kemallaydn/FAC-IO-HARDWARE/manufacturing/DRAFT-2026-11-08/drill-report.txt

Drill report for FAC-IO-Mini-V1.kicad_pcb
Created on 2026-11-08T16:09:45

Copper Layer Stackup:
    =============================================================
    L1 :  F.Cu                      front
    L2 :  In1.Cu                    in1
    L3 :  In2.Cu                    in2
    L4 :  B.Cu                      back

Drill file 'FAC-IO-Mini-V1-PTH.drl' contains
    plated through holes:
    =============================================================
    T1  0.300mm  0.0118"  (154 holes))
    T2  0.300mm  0.0118"  (12 holes))
    T3  0.600mm  0.0236"  (4 holes)  (with 4 slots)
    T4  0.850mm  0.0335"  (16 holes))
    T5  0.900mm  0.0354"  (8 holes))
    T6  1.020mm  0.0402"  (4 holes))
    T7  1.100mm  0.0433"  (4 holes))
    T8  1.600mm  0.0630"  (10 holes))

    Total plated holes count 212

Drill file 'FAC-IO-Mini-V1-NPTH.drl' contains
    unplated through holes:
    =============================================================
    T1  0.650mm  0.0256"  (2 holes))
    T2  3.200mm  0.1260"  (4 holes))
    T3  3.250mm  0.1280"  (2 holes))

    Total unplated holes count 8
