kemallaydn/FAC-IO-HARDWARE/manufacturing/REVIEW-2026-11-10-PCBA-DRAFT/release/drc-report.txt

** Drc report for FAC-IO-Mini-V1.kicad_pcb **
** Created on 2026-11-10T16:45:32 **
** Report includes: Errors, Warnings, Exclusions **

** Found 0 DRC violations **

** Found 0 unconnected pads **

** Found 0 Footprint errors **

** Ignored checks **
    - Hiçbiri

** End of Report **
