kemallaydn/FAC-IO-HARDWARE/manufacturing/DRAFT-2026-11-09-DRAFT-1.2/reports/revision-notes.txt

DRAFT-1.2 revision notes

- Enabled footprint-placement enforcement for the existing ESP32 antenna keepout in both the PCB footprint instance and project footprint library. No manufacturing geometry, nets, outline, Gerbers or drills changed. Refreshed ERC, DRC and machine-readable parity reports; ERC and DRC/parity pass with zero violations. A follow-up coordinate audit confirmed the 30×14 mm Edge.Cuts cutout places the 28×11 mm antenna keepout fully outside the base-board outline; the earlier rectangular-bounding-box interpretation was incorrect. Confirm enclosure clearance and perform RF range/throughput tests if Wi-Fi/BLE is enabled.

- Source revision: DRAFT-1.2.
- Changed only F1's manufacturer selection from Littelfuse 1812L050/30PR to 1812L075/33DR. The MPN is synchronized in schematic, PCB, source BOM, Robotistan draft BOM, schematic BOM and exported position Value fields. The 1812 footprint, PCB geometry, nets and component placement are unchanged.
- Littelfuse's 1812L datasheet lists the new part at 0.75 A hold, 1.5 A trip, 33 V maximum, and 0.36 A in its 85 C temperature table. Littelfuse explicitly says temperature rerating is reference-only. This improves the preliminary hot-current estimate but does not close the PTC selection; source/load/ambient, local heating, fault coordination and first-article tests remain open.
- Regenerated current-source KiCad 10.0.8 Gerber, Excellon, schematic PDF, schematic BOM, ERC, DRC and machine-readable parity report. All normalized Gerber and drill payloads match DRAFT-1.1 after revision/date metadata is removed; this confirms no manufacturing geometry changed.
- Gerber/Excellon CRC ZIP contains 11 Gerber layers, one Gerber job file, and separate PTH/NPTH drill files. ZIP integrity passes. Gerbonara 1.6.3 independently parses the DRAFT-1.2 Gerbers and drills; see `reports/gerber-parse.txt`. Its `G90`-after-header warning is a parser classification warning: Excellon defines G90 as absolute mode and permits it as a standalone program command, and JLCPCB's published example also places it after `%`. The KiCad exports remain unchanged. Fabricator CAM acceptance remains open.
- Corrected 51 stale `Status` notes in `bom/robotistan-bom-draft.csv` by syncing from `hardware/bom-draft.csv`. Exact supplier-code mappings now cover 45 of 56 placements across 26 MPNs (resistors, capacitors, semiconductors, PTC fuse, TVS, relays, ESP32 module, USB-C connector and Samtec sockets); 11 BOM rows remain without confirmed codes. The values are catalog identifiers, not confirmed Robotistan procurement/assembly acceptance or current stock. Current stock and assembly acceptance are unverified.
- KiCad 10.0.8 ERC and DRC/parity both pass on current source CAD. This remains an engineering DRAFT, not a production release.

- 2026-11-09 follow-up: fresh KiCad 10.0.8 ERC/DRC/parity and netlist checks pass (0 ERC issues; 0 DRC/parity issues/unconnected pads/ignored checks). A stale 10-row schematic BOM was replaced by the current 56-reference KiCad export. Source, Robotistan and assembly BOMs match 56 refs × 7 fields; schematic BOM matches value/footprint/MPN 56/56; positions match 56/56. Exact catalog codes cover 45/56 placements (11 blank).
- Refilled-zone Gerber/drill exports, schematic PDF, assembly PDF, board render and flat 14-file ZIP were regenerated from current CAD. Gerbonara parses 11 Gerbers and both drill files; Excellon `G90` warnings remain for supplier CAM confirmation. ZIP integrity and `git diff --check` pass. PlatformIO target build was attempted and stopped during RISC-V toolchain extraction with `No space left on device`; no target binary is verified.

- Follow-up sourcing update: matched CUI TB007-508-02BE (J1) to LCSC C3816270 and TB007-508-03BE (J4/J5) to C3820511; synchronized source, Robotistan and assembly BOMs. Exact catalog-code coverage is now 48/56 across 28 MPNs (8 rows blank). These IDs do not confirm Robotistan import, current stock or assembly acceptance.

- Follow-up component lifecycle update: changed C3/C8/C30 from TDK C1608X7R1E104K080AA (manufacturer NRND) to C1608X7R1H104K080AA (active production, 100 nF/50 V X7R 0603, LCSC C72453). Corrected C3 BOM/value export to 100nF/50V; updated schematic, PCB, source/assembly/Robotistan/schematic BOM and placement CSVs. Nets, land patterns, copper and drill geometry are unchanged. KiCad 10.0.8 netlist/ERC/DRC/parity pass. Manufacturer states alternate interchangeability is not guaranteed; independent design review remains open. Supplier-code coverage is 51/56 placements across 29 MPNs; five placements remain uncoded.
