kemallaydn/FAC-IO-HARDWARE/PROJECT_STATUS.md

# 2026-11-12 — Basit üretim yolu seçimi ve güncel KiCad kontrolü
- Aynı checkout’taki ana tasarımlar KiCad 10.0.8 ile tekrar kontrol edildi. **Mini V1 (ESP32-C3 + hazır WIZ850io modülü + iki kuru kontak röle):** ERC 0 hata, 2 uyarı (J6/J7 özel sembol kopyaları kütüphaneyle eşleşmiyor); tam DRC 0 ihlal, 0 açık bağlantı, 0 şematik eşlik sorunu. Üretim paketi mevcut: `manufacturing/REVIEW-2026-11-10-PCBA-DRAFT/`.
- **Lite V3 (çıplak W5500 + magjack):** ERC 0/0; error-level DRC/parity 0 hata/açık; tam DRC 389 uyarı. Esas engel MDI: RX toplam uzunlukları 81.81/77.20 mm ve hatlarda via var; WIZnet’in 75 mm sınırı/via kılavuzunu karşılamıyor. V3’ten yeni Gerber çıkarılmadı.
- Bu kanıta göre yeni MDI yerleşimini sıfırdan yönlendirme yolunu durdurup, üretime en yakın sade yol olarak WIZ850io modüllü V1’e dönüyorum. Kart yine **üretime hazır değil**: Robotistan BOM stok/tedarik ve WIZ850io’nun fabrikada takılmasını yazılı kabul etmeli; V1’in iki ERC uyarısı ve elektriksel/ilk ürün doğrulamaları da kapanmalı. DRAFT paketi sipariş onayı değildir.
- Raporlar: `validation-reports/final-check-v1-{erc.txt,drc.json,drc-full.json}` ve `final-check-v3-{erc.txt,drc.json,drc-full.json}`. V3 deney adayları ana CAD’e alınmadı; kullanıcı değişiklikleri korunuyor.

# 2026-11-12 — Lite V3 MDI yerleşim/yönlendirme denemeleri (üretim kapısı açık)
- Kaynak V3 şema/PCB dosyaları bu denemelerde değiştirilmedi. Üretim Gerber/BOM/PnP paketi üretilmedi. Önceki kaynak doğrulaması geçerlidir: KiCad 10.0.8 ERC 0 hata/0 uyarı; kaynak PCB hata-seviyesi DRC + parity 0 hata/0 açık/0 parity, fakat MDI gereksinimleri ve 389 tam-seviye uyarı nedeniyle üretime hazır değil.
- Tam bağlanan geçici `mdialign19` rotası izleri 0.20 mm’ye alınıp W5500 pinindeki iki 0.0023 mm açıklık ihlali kısa, yatay pad kaçışıyla giderildi. Son hata-seviyesi KiCad DRC: **0 ihlal / 0 açık**. Ölçülen MDI: TXP/TXN 30.78/43.88 mm (2/0 via); RX PHY tarafı 40.35/39.77 mm (2/3 via); RX magjack tarafı 37.81/34.14 mm (1/1 via). RX kondansatörleri üzerinden toplam yaklaşık 78.16/73.91 mm: RXP, WIZnet 75 mm mutlak sınırını aşıyor. Her çiftte yasaklanan via/katman geçişleri de var. Aday üretim için reddedildi.
- Kondansatörleri U6–J7 arasına alan `mdialign23` yerleşimi fiziksel yerleşim DRC’sinde temizdi, fakat 200 geçişe kadar autoroute 26 bağlantı açık bıraktı; genişletilmiş 0.20 mm izlerle hata DRC’sinde 2 clearance hatası kaldı. MDI ölçümleri: RX toplam yaklaşık 44.40/44.90 mm, fakat via’lar 2–3/adet; TX 35.50/31.79 mm ve TXP/TXN’de 1/0 via. Elektriksel bağlantı tam değil, aday reddedildi.
- Kondansatörleri kart altındaki boşluğa alan `mdialign26` da fiziksel yerleşim DRC’sini geçti; 200 geçişte 26 açık bağlantı, 2 clearance hatası ve MDI’de 1–3 via/net verdi. RX toplamı yaklaşık 59.91/63.86 mm, TX 42.05/33.25 mm. Aday reddedildi.
- Tam bağlı `mdialign19` güç izlerini yeni MDI rotalarıyla birleştirme denemesi `mdialign27` de KiCad hata-seviyesi DRC’de 56 ihlal ve 11 açık verdi; iz uçları ve ağlar çakıştığından reddedildi. Otomatik rota parçalarını farklı yerleşimlerden birleştirmek güvenilir değil.
- Ayrıntılı deneme kanıtı geçici çalışma alanında `/tmp/facio-v3-finalize/mdialign19*`, `mdialign23*`, `mdialign26*` altındadır; bu adayların hiçbiri kaynak tasarıma alınmadı ve eşlenik şematik parity/CAM testi geçmedi. Üretim kapısı halen kapalıdır. Sonraki gerekli iş: magjack, RX kuplaj kondansatörleri, güç dağıtımı ve W5500’ü birlikte yeniden yerleştirip tüm kartı elle/kurallı yönlendirmek; sonra MDI via’sız ve ≤75 mm (tercihen <25 mm) doğrulaması, tam ERC/DRC/parity ve bağımsız CAM/ilk ürün incelemesi.

# 2026-11-12 — V3 magjack yerleşim adayı yeniden değerlendirildi
- Taze KiCad 10.0.8 kontrolü kaynak V3 için ERC **0 hata/0 uyarı**, hata-seviyesi DRC + şematik eşliği **0 hata/0 açık/0 parity** verdi. Tüm-seviye DRC **389 uyarı** verdi (193 silk çakışması, 190 silk-bakır, 6 silk-kenar); bu uyarılar üretim onayı değil. Raporlar: `validation-reports/lite-v3-2026-11-12-audit-{erc.txt,drc.json,netlist.xml,mdi.txt}`.
- Kaynak PCB izleri KiCad’in pcbnew API’siyle ölçüldü: TXP/TXN **59.19/49.11 mm, 3/3 via**; RX PHY P/N **39.48/40.41 mm, 4/4 via**; RX kablo P/N **42.33/36.79 mm, 1/1 via**. RX seri kuplaj kondansatörlerinin iki yanındaki net parçaları toplandığında toplam RXP/RXN **81.81/77.20 mm**; WIZnet’in 75 mm mutlak uzunluk sınırını da aşıyor. Tüm MDI çiftlerinde via var; kılavuz via/katman değişimini yasaklıyor. DRC temizliği bu üretici koşullarını karşılamıyor; kaynak PCB üretime hazır değil.
- WIZnet’in W5500 + J1B1211CCD referans şeması büyütülerek kontrol edildi ve KiCad netlist’iyle eşlendi: 6.8 nF RX seri kuplajı, RX 49.9 Ω eşleme ve 10 nF merkezden GND’ye, TX 49.9 Ω bias ve TCT 10 Ω/22 nF ağı V3 ile uyumlu. Referanstaki R21–R24 seri damping konumları opsiyonel; şemadaki temel değeri 0 Ω, açıklama ise kendi testlerinde 33 Ω’nun EMI’ye iyi geldiğini söylüyor. 33 Ω zorunlu değildir ve mevcut V3’e körlemesine eklenmeyecek.
- `/tmp/facio-v3-finalize/mdialign11-trackless.kicad_pcb` deneme yerleşimi 37 fiziksel DRC hatası verdi; reddedildi. Deneme ana V3’e aktarılmadı. Kaynak şema/PCB değişmedi; Gerber/BOM/PnP üretilmedi.
- `/tmp/facio-v3-mdi90/` içindeki 90° magjack denemesini KiCad 10.0.8 3D görünümünde kontrol ettim. Adayda J7 kart kenarında değil, kartın ortasında kalıyor; routing/DRC sayısal olarak 0 açık/parity gösterse de mekanik kullanıma uygun değil. Bu aday reddedildi ve ana V3 şema/PCB’ye kopyalanmadı.
- Kaynak PCB’nin kendi J7’si üst kenarda (194,109,0°). Sağ kenar alternatifi için yalnızca geçici yerleşim denemesi yaptım: U6 (185,136,180°), J7 (205,136,90°). MDI pad merkezleri yaklaşık 18–21 mm aralığında; doğrudan düz fanout hesabında TX ve RX çiftlerinin her birinde birer sıralama kesişmesi var. Son yerleşim taslağında U6/R38 ve C104/R38 courtyard çakışmaları da sürüyor. Bu, yönlendirilmiş PCB veya üretim adayı değildir; mevcut routing bu taşımada artık geçersizdir.
- **MDI damping kararı:** J1B1211CCD referansındaki R21–R24 opsiyonel seri damping yerleşimleridir; şemada 0 Ω gösterilmiş, notta WIZnet’in kendi denemesinde 33 Ω’nun EMI için iyi sonuç verdiği yazılmıştır. V3 bunları eklemez; EMI test sonucu olmadan 33 Ω’ya çevrilmeyecek.
- Üretici kılavuzu MDI için 100 Ω diferansiyel empedans, 6–12 mil iz, olabildiğince eş uzunluk, <25 mm öneri / 75 mm en kötü durum ve via/katman değişikliği olmamasını istiyor; RJ45/manyetik altında güç ve GND düzlemi bırakılmamalı. Kaynaklar: [WIZnet Hardware Design Guide](https://docs.wiznet.io/Design-Guide/hardware_design_guide), [J1B1211CCD referans şeması](https://docs.wiznet.io/assets/files/w5500_sch_v110_use_mag_-dfff8bbb103d13be4f25cd2b2f8b950d.pdf), [Yageo RC0402JR-070RL](https://www.yageogroup.com/component-documentation/download/specsheet/RC0402JR-070RL).
- **Kaynak V3 dosyaları değiştirilmedi.** Bu oturumda `/tmp` yerleşim denemeleri üretim/parity kanıtı oluşturmaz; mevcut kaynak PCB’nin daha önceki DRC raporu da yeni MDI topolojisini doğrulamaz. Gerber/BOM/PnP yayımlanmadı.
- **Sıradaki:** J1B1211CCD’yi gerçek kart kenarında tutarak U6, kristal, RX 6.8 nF ağı ve terminasyonları birlikte yerleştir; MDI’yi mümkün olduğunca kısa, eş uzunlukta ve viasız route et. DRC/parity yanında MDI uzunluk/via, silk, power/return, CAM, BOM ve Robotistan PCBA kabulü geçmeden üretim paketi verme.

# 2026-11-11 — V3 üretici referanslı Ethernet yerleşimi yeniden başlatıldı
- Kaynak `hardware/FAC-IO-Lite-V3.kicad_sch/.kicad_pcb` KiCad 10.0.8 ile yeniden kontrol edildi: ERC **exit 0 / 0 ihlal**; zone refill + schematic parity error-level DRC **exit 0 / 0 hata / 0 açık bağlantı / 0 parity sorunu**. Tam-severity DRC **389 uyarı** veriyor; raporlar `validation-reports/lite-v3-continuation-*` altında. Uyarılar üretime uygunluk kararı değildir.
- WIZnet’in `W5500-EVB-Pico_V100` resmi PCB referansındaki W5500/magjack ve MDI pasif geometrisi ayrı deneme kopyasına taşındı. 0603’ler bu sık yerleşimde açıklık ve courtyard ihlali oluşturdu; uygun KiCad 0402 kütüphane footprint’lerine çevrilip U5 ve kristal çevresi konumu düzeltildi. Trackless placement-only adayda error-level DRC **0 fiziksel kural ihlali** verdi. Aday ve rapor: `validation-reports/lite-v3-wiznet-placement-only-trackless.kicad_pcb`, `lite-v3-wiznet-placement-only-errors.json`.
- Bu adayda yönlendirme ve zonelar bilerek kaldırıldı: **183 bağlantısız öge** var. Şematik/PCB parity, WIZnet MDI performansı veya üretim dosyası kanıtı değildir; ana V3 kaynakları değiştirilmedi. Resmî referanstaki R21–R24 opsiyonel seri damping noktaları V3’te yok; 33 Ω yalnızca WIZnet’in kendi EMI denemesinde işe yarayan opsiyonel değerdir.
- **Üretime hazır değil; Gerber/BOM/PnP yayımlanmadı.** Sonraki: V3 şemasına dört MDI seri direncini ve PHY/kablo net sınırlarını ekle; üretici footprint/MPN’lerini doğrula; Ethernet alanını bu adayda bütün netlerle route et; kaynak PCB’ye almadan tam parity, DRC, MDI uzunluk/via, silk, power/return, CAM ve Robotistan PCBA kabulünü kapat.

# 2026-11-11 — WIZnet yerleşiminde çift GND dolgusu denemesi reddedildi
- Kaynak V3 kartına dokunmadan PnP-referanslı 0402 Ethernet yerleşimine üst katman GND dolgusu eklendi; KiCad 10.0.8 zone-refill + error-level DRC çalıştırıldı. Üst dolgu GND açıklarını 16'dan 5'e düşürdü, fakat 5 bağlantısız zone adacığı kaldı. Pad bağlantısını solid yapmak C31 açık bağlantısını ve iki starved-thermal hatasını kaldırdı; zone adacıklarını kaldırmadı.
- Adayda hâlâ 8 gerçek açıklık ihlali var: U6 çevresinde iki ETH_MOSI/ETH_INT açıklığı 0.1986/0.200 mm; OPEN_COM/OPEN_NC 0.1786/0.200 mm; PULSE2/TRIG2 0.1517/0.200 mm. Ölçümler DRC kuralını karşılamıyor ve gevşetilmedi.
- Kaynak `FAC-IO-Lite-V3` ayrıca KiCad 10.0.8 ile taze kontrol edildi: ERC **0 ihlal** (exit 0); zone-refill + schematic-parity error-level DRC **0 ihlal / 0 açık bağlantı / 0 parity sorunu** (exit 0). Tam severity DRC **389 uyarı** veriyor; bunlar kaynak kartın bilinen silkscreen uyarılarıdır. Raporlar `validation-reports/lite-v3-current-final-*` altında. Bu CAD temel sonucu MDI topolojisinin üretici kılavuzuna uyduğunu veya kartın üretime hazır olduğunu kanıtlamaz.
- Reddedilen aday ve raporlar `validation-reports/lite-v3-wiznet-pnp-dualgnd-trial*` altında saklandı. Ana şema/PCB değişmedi; Gerber, Excellon, üretim BOM veya PnP üretilmedi. Bu aday şema-parity, MDI eş uzunluk/viasız yönlendirme, tam üretici/CAM ve Robotistan incelemesini geçmedi; üretime hazır değil.
- Sıradaki: clearance kurallarını koruyarak MDI, röle/dijital izleri yeniden yerleştirip route et; GND plane island bağlantılarını çöz; tüm-net DRC/parity ve MDI uzunluk/via analizinden sonra güncel BOM/PnP/Robotistan kabulüne geç.

# 2026-11-11 — V3 üretici yerleşim yönündeki yeni routing denemesi
- WIZnet'in resmi tasarım kılavuzu tekrar kontrol edildi: MDI izleri 6–12 mil, 100 Ω diferansiyel, çiftler olabildiğince eş uzunlukta ve viasız olmalı; önerilen uzunluk <25 mm, mutlak üst sınır 75 mm. Referans sayfası J1B1211CCD'yi W5500 ile desteklenen magjack olarak listeliyor. Kaynaklar: [Hardware Design Guide](https://docs.wiznet.io/Design-Guide/hardware_design_guide), [W5500 Reference Schematic](https://docs.wiznet.io/Product/Chip/Ethernet/W5500/ref-schematic).
- Eski kaynak karttan ayrı bir trackless kopyada J7/U6 yönü üretici W5500-EVB-Pico PnP sırasına göre düzeltildi; eski MDI ağı ve ilgili pasiflerin konumu bu yerleşimde korundu. FreeRouting 2.5.0, bu ayrı kopyada **195 bağlantısız netten 0'a** indi ve **0 router ihlali** raporladı.
- FreeRouting'in 0.10–0.15 mm izleri 0.20 mm'ye büyütülüp KiCad 10.0.8 DRC çalıştırıldı: **0 bağlantısız öğe, 13 açıklık ihlali** (exit 5). Tam DRC'de bunlara ek olarak 391 silkscreen uyarısı ve 1 footprint kitaplık uyarısı var. KiCad parity bu geçici farklı adlı adayda çalıştırılamadı. MDI uzunlukları hâlâ yüksek: TXP/TXN **59.93/46.46 mm**, RX_PHY P/N **46.31/50.64 mm**; TXP/TXN/RX_PHY P/N sırasıyla **3/2/3/2 via**. WIZnet'in viasız ve <25 mm hedefini karşılamıyor.
- Aday PCB ve DRC/FreeRouting raporları `validation-reports/lite-v3-ethernet-relayout-trial*` içinde. **Ana V3 PCB/şema değiştirilmedi; üretim Gerber/BOM/PnP üretilmedi ve kart üretime hazır değil.** Sıradaki iş MDI terminasyon/kuplaj elemanlarını ve W5500/RJ45 yerleşimini birlikte yeniden kurup MDI çiftlerini üretici kurallarına yaklaştırmak; ardından temiz tam DRC/parity ve Robotistan CAM/BOM kabulünü doğrulamak.
- Takip denemesi: FreeRouting optimizer MDI uzunluk/via ölçülerini değiştirmedi; yakın pasif yerleşimi denemesinde W5500 pad aralığında kısa-devre ve footprint çakışmaları oluştu, reddedildi. Hiçbiri ana PCB'ye aktarılmadı.

# 2026-11-11 — V3 iki katmanlı yönlendirme adayı: 3V3 dolgusu ölçüldü, serbest bırakılmadı
- Kaynak PCB'ye dokunmadan geçici U6/J7 yerleşimi ve FreeRouting rotasına F.Cu/B.Cu 3V3 dolgusu eklendi; J7/manyetikler altında dolgu için copper-fill keepout kullanıldı. Dolgu, açık bağlantıları 18'den 5'e düşürdü.
- Router'ın 0.15 mm izleri aday kopyada 0.20 mm'ye büyütüldü. KiCad 10.0.8 hata-seviyesi DRC sonucu: **1 starved-thermal hatası, 5 bağlantısız item; exit 5** (`validation-reports/lite-v3-2layer-plane-candidate-errors.*`). İz genişliği/açıklık hatası kalmadı; bu aday için parity testi koşulmadı.
- 3V3 zone bağlantısı doğrudan bakır (full connection) yapılarak starved-thermal hatası kapatıldı. Güncel tam DRC adayı: **0 error-level ihlal, 5 bağlantısız item ve 392 uyarı; exit 5** (`validation-reports/lite-v3-2layer-plane-candidate-connectivity.*`). Açıklar 3 zone adacığı ile J7.12/U6 ve J7.5/C8 arasındaki 3V3 bağlantılarıdır. Kaynak PCB'ye uygulanmadı.
- Kalan açıklar: 3V3 dolgu adacıkları, U6 pin 45 beslemesi ve J7/C8 LED beslemesi. MDI ölçümleri hâlâ uygunsuz: TXP/TXN 43.91/30.97 mm ve 2/1 via; RXP/RXN_PHY 18.80/25.28 mm ve 2/1 via; kablo çifti 24.04/22.00 mm ve 1/1 via. Bu nedenle aday WIZnet yerleşim/yönlendirme koşullarını karşılamıyor.
- **Üretim dosyası oluşturulmadı; V3 üretime hazır değil.** Büyütülmüş ve doldurulmuş kopya `/tmp/v3-place-j-fullpower-routed-3v3planes-020.kicad_pcb` altındadır; kaynak V3 PCB değişmedi. Sonraki CAD işi MDI çiftlerini viasız ve eş uzunlukta yeniden yerleştirmek, kalan 3V3 bağlantılarını kapatmak, ardından tam DRC/parity ve bağımsız CAM kontrolü almaktır.

# 2026-11-11 — Lite V3 kısa MDI yerleşim yönlendirmesi reddedildi
- Trackless U6 `(191,133,270°)` / J7 `(188,108,0°)` yerleşimi, 0402 RX seri kondansatörleri ve taşınmış pasiflerle fiziksel error-level DRC'yi geçiyordu. FreeRouting 2.5.0 bu adayı 30 ve 100 geçişte de **16 unrouted** bağlantıyla bıraktı; devamı 3V3 ağı ve röle GPIO netlerinde kaldı.
- SES geçici kopyaya alındığında KiCad 10.0.8 DRC **34 iz genişliği hatası** ve **22 bağlantısız item** (20 adet 3V3, 1 TRIG1, 1 ACTLED) ve 14 dangling-via uyarısı buldu. Altı MDI iletkeni toplam iz/via sayımı: TXP 34.28 mm/2, TXN 28.28 mm/1, RXP_PHY 13.92 mm/1, RXN_PHY 27.89 mm/0, RXP_CABLE 21.72 mm/1, RXN_CABLE 21.53 mm/1. PHY RX çifti **13.97 mm dengesiz**; aday üretim için reddedildi.
- Kaynak V3 kart değiştirilmedi. Kaynak dosyanın yeni KiCad 10.0.8 kontrolleri: ERC **0 ihlal**; PCB hata-seviyesi DRC **0 ihlal, 0 bağlantısız, 0 parity**; tam DRC **389 silkscreen uyarısı** ile exit 5. Raporlar `validation-reports/lite-v3-final-erc.txt`, `lite-v3-final-drc-errors.json`, `lite-v3-final-drc.json`; reddedilen geçici aday ölçümleri `validation-reports/lite-v3-place-j-0402d-router.txt`.
- **Durum değişmedi: V3 üretime hazır değil; Gerber/Excellon/BOM/PnP yayımlanmadı.** Kalan temel iş, Ethernet bloğunu üretici kılavuzuna uyan viasız/eşlenmiş diferansiyel rotayla yeniden yerleştirip tüm 3V3/SPI/röle netlerini üretilebilir iz genişliklerinde tamamlamak. Kısa pad aralığı tek başına yeterli değil.

# 2026-11-11 — V3 güncel ERC/DRC ve MDI pin-sırası incelemesi
- KiCad CLI **10.0.8** ile güncel V3 kaynakları tekrar kontrol edildi. ERC: **0 hata / 0 uyarı** (raporda 4 ERC exclusion listeleniyor). Zone refill + schematic parity PCB DRC: **0 hata, 0 bağlantısız pad, 0 footprint/parity sorunu**; bütün **389 DRC mesajı uyarı** ve silkscreen taşması/örtüşmesi/kenar mesafesi. Raporlar: `validation-reports/lite-v3-final-followup-erc.txt`, `validation-reports/lite-v3-final-followup-drc.txt`, `validation-reports/lite-v3-final-followup-drc.json`. `--severity-all` çalıştırmasının exit code 5'i bu uyarıları da exit-code kapsamına aldığı için; hata-seviyesi ve bağlantı/parity sayıları sıfırdır.
- WIZnet'in güncel referans sayfası J1B1211CCD'yi W5500 EVB'de kullanılan magjack olarak listeliyor; bağlı merkez uç devresinde C23/C24 şartını tekrar doğruluyor. Donanım kılavuzu MDI çiftleri için 100 Ω diferansiyel empedans, 6–12 mil iz, TX/RX çiftleri arasında en az 20 mil ayrım, tercihen <25 mm (en çok 75 mm) ve via/layer-change olmaması gerektiğini belirtiyor. Datasheet W5500'de Auto-MDIX olmadığını söylüyor; bu nedenle TX/RX çiftlerini çaprazlamak çözüm olarak kullanılmayacak.
- MDI pad sırası, gerçek KiCad footprint'leri ve 4 kardinal U6 yönü / 4 J7 yönü geçici kopyalarda karşılaştırıldı. Mevcut dar yerleşimde dış RJ45 yönünü koruyan J7=0° dışında diğer 3 yön yerel courtyard/kenar/pad çakışmaları getiriyor; J7=0° ile W5500 MDI pad sırası, referans kablo pin sırasıyla düz ve sıralı viasız fanout oluşturmuyor. Bu sonuç üretici pin/net eşlemesini veya iletken polaritesini değiştirmeden yeni Ethernet alanı yerleşimi/footprint adayı gerektiğini gösteriyor; hiçbir geçici yön ana PCB'ye alınmadı.
- WIZnet'in önerdiği `J1B121ZCCD` ve `J1B1211CCD` üretici çizimleri karşılaştırıldı. MDI pad sırası ve yerleşimi aynı olduğundan, `J1B121ZCCD`'ye geçiş tek başına pin-order sorununu çözmüyor; mevcut aday değişmedi.
- İkinci bir geçici yerleşimde U6=180° / J7=0° denendi. FreeRouting 2.5.0 geçişi 195 bağlantıyı 2 açık bağlantıya düşürdü, ancak KiCad 10 DRC bu adayda **62 iz genişliği hatası** (0.15 mm izler, kart minimumu 0.20 mm) ve **4 bağlantısız pad** buldu; MDI ağları hâlâ 1–3 via içeriyor ve uzunluklar TXP 48.89 mm, TXN 39.63 mm, RXP_PHY 22.38 mm, RXN_PHY 29.87 mm, RX kablo 35.96/21.53 mm. Aday reddedildi, ana karta aktarılmadı. Router ve DRC kayıtları `validation-reports/lite-v3-orient-u180-j0-*` altında.
- U6=0° ve J7=0° denemesi FreeRouting'de 1 unrouted bağlantıya indi; KiCad DRC yine **42 iz genişliği hatası**, **4 bağlantısız pad** ve MDI çiftlerinde **1–2 via** buldu. Ethernet iz uzunlukları TXP/TXN 52.49/34.60 mm, RX_PHY 18.25/20.42 mm, RX_CABLE 23.83/21.53 mm. Bu aday da reddedildi. U6=90° denemesi 15 unrouted bağlantıda kaldı. Raporlar `validation-reports/lite-v3-orient-u0-j0-*` altında; tüm yön denemeleri `/tmp` kopyalarında, kaynak PCB değişmedi.
- Kaynak V3 PCB/şematik bu incelemede değiştirilmedi. Mevcut MDI segmentleri (TXP 59.19 mm/3 via; TXN 49.11 mm/3; RXP_PHY 39.48 mm/4; RXN_PHY 40.41 mm/4; kablo tarafı 42.33/36.79 mm ve via'lı) WIZnet yerleşim rehberini karşılamıyor. **V3 ve üretim paketi hâlâ üretime hazır değil; Gerber/Excellon/BOM/PnP yayımlanmadı.** Sıradaki iş: RJ45/PHY alanını pin-sırası ve enclosure/board-edge yönüyle yeniden yerleştirip tüm MDI izlerini doğru hat sırası ve WIZnet kurallarıyla route etmek; bu başarılamazsa mevcut V1'in dört katmanlı, DRC/parity geçmiş üretim tasarımını PCBA tedarik engelleriyle karşılaştırıp en kısa gerçek üretim rotasını seçmek.

# 2026-11-11 — V3 Ethernet yerleşim alternatifleri elendi; üretim kilidi sürüyor
- Mevcut V3 PCB'yi bozmadan iki geçici yerleşim denemesi KiCad 10.0.8 DRC ile kontrol edildi. İşlevsel blokları kaba biçimde yeniden dağıtan deneme 42 footprint courtyard çakışması verdi; J7/U6'ı yaklaştıran dar kapsamlı deneme 8 çakışma ve 8 fiziksel pad kısa-devre DRC'si verdi. RJ45'i kart kenarına 90° çeviren alternatif 10 courtyard çakışması, 2 bakır-kenar açıklığı ve 1 THT/courtyard ihlali verdi. Bunların tamamı `/tmp` altındaki geçici kopyalardır; ana PCB ve mevcut netlist/routing kaynakları değiştirilmedi.
- Denemeler yeni üretim PCB'si değildir: izler kaldırılarak yalnız footprint çakışma teşhisi yapılmıştır; bu yüzden bu raporlardaki bağlantısız pad sayıları routing sonucu olarak yorumlanamaz. Ana V3 kartın son geçerli raporu VBG düzeltmesi sonrası önceki girişte kayıtlıdır.
- **Üretime hazır değil; Gerber/Excellon/BOM/PnP onaylanmadı.** Darboğaz, W5500 MDI çiftlerini kısa/eş uzunluklu/viasız tutarken J1B1211CCD, seri/terminasyon elemanları, kristal ve decoupling bileşenlerini aynı bölgede fiziksel olarak çakışmadan yerleştirecek yeniden tasarımdır. Sıradaki iş, Ethernet bölgesini netlist ve mekanik courtyard kısıtlarını birlikte gözeterek yeniden yerleştirip tam izleri baştan route etmek; ancak ERC/DRC/parity ve MDI ölçümleri geçerse ana karta almak.

# 2026-11-11 — V3 MDI için düşük uzunluklu yerleşim adayı bulundu (geçici)
- Track'leri kaldırılmış geçici yerleşimde U6 W5500 `(191,133,270°)`, J7 magjack `(188,108,0°)` konumuna alındı; U6 çevresindeki R/C elemanları yeniden konumlandırıldı. KiCad 10 DRC'sinde footprint-courtyard çakışması, bakır kısa devresi ve bakır açıklık ihlali **0** oldu; 389 silkscreen uyarısı ve 1 footprint library uyarısı kaldı. Bu placement-only denemedir; izler kaldırıldığı için net bağlantısı/DRC'si geçmedi ve ana PCB'ye aktarılmadı.
- Pad merkezleri arasındaki düz çizgi alt sınırları: TXP **21.49 mm**, TXN **21.08 mm**, RXP **23.38 mm**, RXN **23.52 mm**. Bunlar route uzunluğu değildir; RX seri kapasitörleri, eş uzunluk ayarı, 100 Ω diferansiyel empedans, via'sız yönlendirme ve tüm-net DRC ayrıca kanıtlanmalı. C32/C33 0603 footprint'leri bu dar alana sığmadı; 0402 alternatifi kütüphane-senkron footprint ve uygun MPN doğrulaması olmadan kabul edilmedi.
- Sonraki CAD adımı: C32/C33'ü üretici kütüphanesiyle gerçekten 0402 yapıp MDI koridorunda fiziksel DRC'yi doğrula; ardından bu yerleşimde dört MDI netini ve TX tap/LED/RX matching ağını yönlendir, rotaları ölç ve kalan tüm güç/SPI/röle ağlarını yeniden bağla. Mevcut kaynak dosyalar ve üretim çıktıları değiştirilmedi.

# 2026-11-11 — V3 W5500 VBG düzeltildi; PCB DRC/parity tekrar doğrulandı
- W5500 üretici datasheet'inde VBG pini açık devre bırakılmalı. Şemadan hatalı C100 (10 nF) kaldırıldı; U6 pin 18 NC olarak işaretlendi. PCB'den C100, eski VBG bağlantıları ve DRC'nin yakaladığı 0.475 mm'lik boştaki GND izi çıkarıldı. NC pad, KiCad şema/PCB eşliği için `unconnected-(U6-VBG-Pad18)` ağına eşlendi.
- KiCad 10.0.8 güncel V3 ERC: **exit 0, 0 ihlal**. Zone refill + schematic parity tam PCB DRC: **0 hata, 0 bağlantısız, 0 şema/PCB eşlik sorunu**; 389 uyarının tamamı silkscreen taşması/örtüşmesi/kenar mesafesi. JSON raporları: `validation-reports/lite-v3-w5500-erc-current.json`, `validation-reports/lite-v3-drc-current.json`; güncel netlist: `validation-reports/lite-v3-w5500-netlist.xml`.
- Ethernet yönlendirme ölçümü hâlâ uygun değil: TXP 59.19 mm/3 via, TXN 49.11 mm/3 via, RXP_PHY 39.48 mm/4 via, RXN_PHY 40.41 mm/4 via, RXP_CABLE 42.33 mm/1 via, RXN_CABLE 36.79 mm/1 via. WIZnet kılavuzu MDI için 25 mm altını öneriyor, 75 mm üst sınır veriyor, çiftlerin eş uzunlukta ve viasız olmasını istiyor; mevcut PCB hem uzunluk hedefini hem via kuralını hem de TX/RX çift eşleşmesini karşılamıyor. W5500+magjack yakın yerleşim denemesi geçici kopyada yapıldı; DRC pin aralığı/çakışma sorunları ve tamamlanmayan FreeRouting sonucu nedeniyle ana karta aktarılmadı.
- **Üretime hazır değil ve Gerber/BOM/PnP yayımlanmadı.** MDI yerleşim/yönlendirme, silkscreen ve Robotistan tedariki açık. Netlistteki 71 fiziksel referansın 20'sinde MPN boş (önceki 25 sayısı fiziksel olmayan 5 adet `PWR_FLAG` sembolünü de içeriyordu); katalog kodu/stok ve Robotistan PCBA kabulü ayrıca doğrulanmadı. Kontrollü empedans ve bağımsız CAM/ilk-numune kontrolü açık.

# 2026-11-11 — V3 W5500 + J1B1211CCD devresi tamamlandı, ERC temiz
- V3 şemasına WIZnet’in J1B1211CCD magjack referansı eklendi: TX bias/merkez-uç ağı, 2×6.8 nF RX seri izolasyonu (WIZnet’in connected-CT C23/C24 şartı), 2×49.9 Ω RX eşlemesi, 22 nF/10 nF EMI ağı, 1 nF/2 kV shield kapasitörü, LED dirençleri, 3V3A ferrit ayrımı, W5500 100 nF/10 µF bypassları ve 1 MΩ/25 MHz kristal ağı. J1B1211CCD pin numaraları, V3’teki gömülü KiCad sembolü ve kurulu footprint ile eşleşiyor.
- KiCad 10.0.8 netlist export **exit 0**; ERC **exit 0, 0 hata / 0 uyarı**. Kontrol edilen ağlar: ESP32-C3 SPI/reset/interrupt↔W5500 pin 32–37; TX±→J7.1/J7.3; RX±→seri C32/C33→J7.4/J7.6; RX eşleme R34/R35 ortak düğümü; TCT/RCT; LINK/ACT LED; 3V3A/3V3 ve CGND. Netlist: `validation-reports/lite-v3-w5500-netlist.xml`; ERC: `validation-reports/lite-v3-w5500-erc.txt`.
- KiCad BOM export **exit 0**, 72 benzersiz referans (başlık hariç) gösteriyor. Bu bir Robotistan PCBA BOM’u değil; yeni W5500 ağı için birçok exact MPN/katalog kodu ve tedarik doğrulaması henüz eklenmedi. Schematic PDF dışa aktarıldı ve gözle incelendi; çizim yerleşimi okunabilirlik için yeniden düzenlenmeli.
- **Hâlâ üretime hazır değil:** V3 PCB henüz oluşturulmadı; bu nedenle V3 DRC, bağlantısız pad, şematik/PCB eşliği, Gerber/Excellon, Pick & Place, CAM ve iki katman route kanıtı yok. Sonraki: 2 katmanlı V3 PCB’yi oluştur, Ethernet pair/anten/izolasyon keepout’larını uygula, route et ve gerçek DRC/parity çalıştır. BOM/Robotistan teklif ve ilk numune testleri sonradan.

# 2026-11-11 — Lite V3 C3 + W5500 şema entegrasyonu başladı
- `hardware/FAC-IO-Lite-V3.kicad_sch` WT32 starter olarak kalmaktan çıkarılıp ESP32-C3-WROOM-02-N4 ve doğrudan W5500 entegrasyonuna başlandı. W5500 `LQFP-48` sembolü, 12.4 kΩ/1% EXRES, 25 MHz kristal ve WIZnet referansından alınan yerel kondansatörler eklendi. ESP32-C3 SPI/reset/interrupt bağlantıları netlistten doğrulandı: SCK GPIO4↔U6.33, MOSI GPIO5↔U6.35, MISO GPIO6↔U6.34, CS GPIO7↔U6.32, INT GPIO10↔U6.36, RESET GPIO3↔U6.37; röle TRIG1/2 GPIO0/1 eşleşmeleri korunuyor.
- KiCad 10.0.8 şematik netlist export **exit 0**. Güncel ERC **exit 5, 2 hata / 4 uyarı**: RXN/RXP henüz magjack/PHY eşleme ağına bağlanmadı ve TX/RX ağ etiketleri tek uçlu. Bu, bilinen eksik devreyi doğru biçimde yakalıyor; ERC temiz değil.
- V3 başlık ve çizim açıklaması, devam eden taslağı ve üretim yasağını yansıtacak şekilde güncellendi. Gerber, BOM veya Pick & Place üretilmedi. Raporlar: `validation-reports/lite-v3-w5500-netlist.xml`, `validation-reports/lite-v3-w5500-erc.txt`.
- **Sıradaki:** resmi WIZnet J1B1211CCD PHY/center-tap referans ağını ve RJ45 sembol pin eşleşmesini V3'e entegre et; W5500 decoupling/clock değerlerini üretici belgesiyle son kez karşılaştır; ardından V3 tam ERC ve netlist işlev kontrollerini çalıştır. Sonra röle/güç devrelerinin V3'e doğru taşındığını ve iki katmanlı yeni PCB'yi kur. V3 üretim için hazır değil.

# 2026-11-11 — İki katman V1 dönüşümü FreeRouting ile yeniden denendi
- Resmî FreeRouting 2.5.0 JAR'ı indirildi ve SHA-256'sı yayımlı sürüm özetiyle eşleşti (`f6f51bb02245e8e717f9359bd260cc9c5c0b1bc0acc8b7cb2cd5b8ffeb5de3c7`). FreeRouting, geçici V1 iki-katman DSN'i üzerinde fanout'u **124/147 SMD pininde** tamamladı; ilk autoroute pass'i **69 unrouted item'dan 40'a** indi ve o anda sıfır router ihlali raporladı. Sonraki geçişler `/GND`, `ETH_MISO`, USB ve tetik netlerinde 2.000 iterasyon normalizasyon sınırına takıldı; en iyi durum pass 8'de 40 unrouted item idi. İki dakikayı aşan takılma nedeniyle SES oluşmadan denemeler durduruldu. Günlük: `/tmp/en/freerouting.log`; V1 kaynak PCB'si değişmedi.
- **Sonuç:** 4 katmanlı V1'i sadece iki kata indirmek üretim yolu değil; DRC'den geçen tam yönlendirme sağlanmadı. Bu, yeni yerleşimli iki katman V3'ün imkânsız olduğunu göstermez. Sıradaki iş eski V1'i dönüştürmeyi bırakıp seçilen ESP32-C3 + W5500 + röle işlevini taşıyan ayrı V3 şema ve yeni PCB yerleşimini kurmaktır. **Üretim dosyası hâlâ yok; siparişe hazır değil.**

# 2026-11-11 — W5500 referans devresi ve yerleşim kısıtları doğrulandı
- WIZnet'in güncel W5500 referans şeması ve PCB kılavuzu incelendi: J1B1211CCD bu uygulama için desteklenen magjack adaylarından; bağlı merkez uçlu topolojide RX eşleme ağı ile 3V3 arasına C23/C24 ayırma kapasitörleri konmalı. Ethernet çiftleri kısa/eş uzunlukta ve viasız yönlendirilmeli; konektör/manyetiklerin altındaki tüm bakır katmanlar boş bırakılmalı. Kaynaklar: `hardware/FAC-IO-Lite-V3-architecture.md` içindeki WIZnet referans bağlantıları.
- WIZnet'in Altium referans kartı yalnız `/tmp` altında KiCad'e alındı ve incelendi; içe aktarılan geçici dosyada **298 DRC ihlali** çıktı. Kaynak yerleşimden fikir alınabilir, ancak bu KiCad aktarımı V3'e kopyalanmayacak ve üretim çıktısı değildir.
- **V3 CAD hâlâ kurulmadı:** `FAC-IO-Lite-V3.kicad_sch` WT32 starter kopyası olarak duruyor; V3 PCB yok. Bu aşamada üretim Gerber/BOM/PnP çıkarılmadı. Sonraki: V1'in güvenilir güç/röle bölümlerinden başlayarak gerçek ESP32-C3 + W5500 devre bloğunu üretici referansına göre V3'e entegre etmek ve yeni şemanın ERC/netlistini doğrulamak.

# 2026-11-11 — Üretim hedefi için CAD başlangıç durumu tekrar doğrulandı
- Yerel KiCad CLI **10.0.8** ile `hardware/FAC-IO-Lite-V3.kicad_sch` ERC çalıştırıldı: **exit 0, 0 hata, 0 uyarı**. Rapor: `/tmp/facio-v3-baseline-erc.txt`. Ancak bu V3 dosyası hâlâ WT32 V2 starter kopyasıdır; ERC sonucu seçili ESP32-C3 + doğrudan W5500 devresine ait değildir. Raporda dört hariç tutulan ERC kontrolü var.
- Karşılaştırma için kullanıcı kaynaklı `hardware/FAC-IO-Mini-V1.kicad_pcb` üzerinde KiCad DRC + zone refill + şematik eşliği: **exit 0, 0 DRC ihlali, 0 unrouted pad, 0 parity sorunu**. Rapor: `/tmp/facio-v1-baseline-drc.txt`. Bu kart 4 katmanlıdır ve seçilen düşük maliyetli 2 katmanlı V3 tasarımının yerine geçmez.
- Önceki iki katmana yalnızca iç katmanları silerek dönüştürme denemesi geçersiz kaldı; temp kopyada **101 ihlal ve 85 unrouted bağlantı** bulundu (`/tmp/facio-v1-2layer-drc.txt`). V1 kaynak dosyası değiştirilmedi.
- **Durum: V3 üretim-CAD işi hâlâ başlamadı; üretim hazır değil.** Sıradaki adım, V1'deki doğrulanmış ESP32-C3/güç/röle bloklarını referans alıp WIZnet referansına göre doğrudan W5500 + J1B1211CCD içeren ayrı bir V3 şeması kurmak; şema/ERC ve gerçek 2 katmanlı PCB/DRC/parity kanıtı oluşturmaktır. WIZnet, bağlı merkez uçlu magjack devresinde C23/C24 ayırma kapasitörlerini zorunlu belirtiyor; PCB'de RJ45 altı bakır ve Ethernet çift yönlendirmesi ayrıca kılavuzlanmalı.

# 2026-11-10 — Robotistan BOM içe aktarma hatası kökü bulundu
- Kullanıcının Robotistan yükleme ekranındaki sıfır C kodu ve adet/ref uyuşmazlığı, CAD hatası değil BOM sütun/adet eşlemesi: `Exact MPN` üretici parça numarasıdır, RobotistanPro/LCSC `C...` kodu değildir. Ayrıca yüklenen “Quantity for 5 boards” değerleri 5'le çarpılmış toplam adet olduğundan, portalın kart başına adet alanına verilince her PCB sayısıyla yeniden çarpılmıştır.
- Mevcut PCBA taslak dosyası `manufacturing/REVIEW-2026-11-10-PCBA-DRAFT/bom/Robotistan-BOM.xlsx` kontrol edildi: `RobotistanPro Part` sütununda C-kodları, `Quantity` sütununda kart başına adet var; 56 referansın 51'inde C-kodu mevcut. Import eşlemesi: `Designator` → Reference, `RobotistanPro Part` → Part Code/MPN, `Quantity` → Quantity (per board), `Manufacturer Part Number (MPN)` → Exact MPN, `Footprint` → Footprint, `Comment` → Request/description.
- Beş referans için hâlâ Robotistan C-kodu yok: C1, C2, L1, SW1, SW2. Bunlar kodu eklenmeden çevrimiçi stok eşleştirmesinden otomatik doğrulanamaz. Bu dosya düzeltmesi sipariş onayı değildir; C-kodu olmayan beş parça ve mevcut dört katman/1 katman seçimi ayrıca çözülmelidir.

# 2026-11-10 — V1 Gerber katman seçimi yeniden kontrol edildi
- Kullanıcının Robotistan konfigüratöründe 1 katmanı seçmesi üzerine mevcut gerçek PCB kaynağı incelendi: `hardware/FAC-IO-Mini-V1.kicad_pcb` hâlâ **4 bakır katmanlıdır** (`F.Cu`, `In1.Cu`, `In2.Cu`, `B.Cu`). Bu kaynak için 1 katmanlı üretim seçeneği/çıktısı eşleşmez. Önizlemede iki yüz görünmesi, iki katman olduğu anlamına gelmez.
- Güncel KiCad 10.0.8 doğrulaması: ERC **0 hata / 0 uyarı**; DRC, zone refill ve şematik eşliği **0 ihlal / 0 bağlantısız pad / 0 eşlik sorunu**. Raporlar `/tmp/facio-current-v1-erc.txt` ve `/tmp/facio-current-v1-drc.txt` içinde. Bu yalnız mevcut V1 CAD kurallarını doğrular; fiyatlandırma ayarı, PCBA tedariki veya üretim onayı değildir.
- Sonraki işlem: V1 dosyalarıyla teklif/üretime gidilecekse katman sayısını 4 ile eşleştir; daha ucuz 2 katmanlı sürüm hedefleniyorsa ayrı PCB yeniden yerleşim ve yönlendirmesi gerekir. Mevcut V3 dosyası gerçek devre/PCB olmadığı için V3 Gerber'i de henüz yoktur.

# 2026-11-10 — Lite V3 düşük maliyetli üretim rotası seçildi
- Güncel Robotistan katalog sayfaları incelendi: WT32-ETH01 ürünü **tükendi** ve ESP32-C3 Mini geliştirme kartı da **tükendi**. Bu modül yolu, mevcut ESP32-C3 + SPI W5500 firmware hedefini de değiştirecekti. Kaynaklar: [WT32 Robotistan](https://www.robotistan.com/wt32-eth01-ethernet-modul), [ESP32-C3 Mini Robotistan](https://www.robotistan.com/esp32-c3-mini-wifi-bluetooth-modul).
- Aktif maliyet/uyumluluk mimarisi `hardware/FAC-IO-Lite-V3-architecture.md` içine kaydedildi: üretim ESP32-C3-WROOM-02-N4 + doğrudan W5500 + WIZnet J1B1211CCD manyetikli RJ45; iki kuru-kontak röle; tek dual CD74HC221 one-shot; korumalı 12 V ve 3.3 V; iki katman hedefi. Tak-çıkar WIZ850io ve soket maliyetini kaldırma hedefleniyor; Ethernet fiziksel devresi WIZnet referansına göre CAD'de kurulmalı.
- LCSC katalog sayfalarında aday tedarik kodları/stok görünümü bulundu: ESP32-C3-WROOM-02-N4 `C2934560`, W5500 `C32843`, J1B1211CCD `C910371`, CD74HC221M96 `C133954`. Bu katalog görünümü RobotistanPro eşleşmesi, gerçek stok, teklif veya sipariş kabulü değildir; her kod PCBA BOM'a alınmadan canlı Robotistan doğrulaması gerekir. Kaynaklar: [ESP32-C3](https://www.lcsc.com/product-detail/C2934560.html), [W5500](https://www.lcsc.com/product-detail/C32843.html), [J1B1211CCD](https://www.lcsc.com/product-detail/C910371.html), [CD74HC221](https://www.lcsc.com/product-detail/C133954.html).
- Gerçek mevcut CAD kapsamı yeniden doğrulandı: V2'de yalnız şema var, `FAC-IO-Lite-V2.kicad_pcb` yok. `FAC-IO-Lite-V3.kicad_sch/.pro` bu aşamada yalnız V2 WT32 şemasının adlandırılmış starter kopyasıdır; başlıkta üretim yasağı eklendi ve KiCad BOM'da U2 hâlâ WT32-ETH01 olarak doğrulandı. V3 ESP32-C3 + doğrudan W5500 devresi, PCB, manufacturing BOM/PnP ve Gerber henüz yok. Kopya üzerinde KiCad 10.0.8 net BOM export **exit 0 / 40 referans** ve ERC **exit 0 / 0 hata / 0 uyarı** verdi; bunlar seçilen V3 devresini doğrulamaz. Raporlar `/tmp/facio-v3-starter-bom.csv` ve `/tmp/facio-v3-starter-erc.txt` altında. Üretim hazır değil.
- V1 karşılaştırma tasarımı mevcut KiCad 10.0.8 ile yeniden kontrol edildi: ERC **exit 0 / 0 hata / 0 uyarı**, DRC + schematic parity **exit 0 / 0 ihlal / 0 bağlantısız öğe / 0 eşlik sorunu**. Raporlar mevcut kullanıcı dosyalarını ezmemek için `/tmp/facio-v1-erc.txt` ve `/tmp/facio-v1-drc.txt` altında üretildi. Bu sonuçlar V1 taslağının kurallara uygunluğunu gösterir; V3 mimarisini, tedarik onayını veya üretim hazırlığını doğrulamaz.
- Sonraki adım: WIZnet W5500 referans devresini ve J1B1211CCD bağlantı şemasını eşleyerek V3 entegre şemayı oluştur, pin/netlist/ERC doğrula; ardından iki katman PCB'yi yerleştir ve route et.

# 2026-11-10 — WT32 pin numaraları fiziksel 26-pad adayına düzeltildi
- Üretici datasheet'i ana 20-pin arayüz ve 6-pin programlama arayüzünü **ayrı ayrı** numaralandırıyor. Eski KiCad sembolü bunları birleştirip OPEN/CLOSE'ı fiziksel pad 2/3 sanıyordu; PCB'ye taşınsaydı yanlış pad eşleşmesi riski vardı. Sembol ve şema içindeki 26 pin, datasheet sinyalleri ve açık kaynak KiCad fiziksel pin dizilimi referans alınarak düzeltildi. Pin dizilimi/ölçü üretici çizimiyle onaylı değildir; fiziksel numune kapısı açık.
- KiCad 10.0.8 CLI yeniden çalıştırıldı: netlist export **exit 0**, BOM export **exit 0**, ERC **exit 0 / 0 hata / 0 uyarı**. Güncel rapor/netlist/BOM: `validation-reports/lite-v2-schematic-erc.txt`, `lite-v2-netlist.xml`, `lite-v2-schematic-bom.csv`. Netlistte OPEN trigger `U2.5`, CLOSE trigger `U2.6`, EN `U2.1/U2.4`, 3V3 `U2.3/U2.10`, programlama IO0/RX0/TX0 `U2.24/U2.25/U2.26` olarak doğrulandı.
- Rapor dört exclusion göstermeye devam ediyor; ERC sonucu yalnız CAD kural kontrolüdür. `U2` footprint'i boş ve `FAC-IO-Lite-V2.kicad_pcb` hâlâ yok; dolayısıyla DRC, parity, Gerber, Robotistan PnP/BOM paketi yok.
- Tedarik güncellemesi: Robotistan WT32 ürünü tükendi gösteriyor; Görsü Elektronik ürünü stokta ve 404,51 TL + KDV listeliyor. Bu, numune temini için gerçek bir adaydır; stok adedi ve Robotistan'ın müşteri tedarikli THT modülü dizgiye kabulü henüz doğrulanmadı. Kaynak: [Robotistan](https://www.robotistan.com/wt32-eth01-ethernet-modul), [Görsü Elektronik](https://gorsuelektronik.com/wt32-eth01-esp32-tabanli-serial-to-ethernet-modul).
- Sıradaki: WT32 revizyonunu ve fiziksel pad/anten/RJ45 konumunu numuneyle ölç; doğru footprint'i kilitle; ardından iki katmanlı PCB'yi çizip ERC/DRC/parity ve CAM, BOM/PnP eşliğini üret. Gerber üretim onayı hâlâ kapalı.

# 2026-11-10 — Lite V2 tek çift-zamanlayıcı taslağı yeniden doğrulandı
- Mevcut `hardware/FAC-IO-Lite-V2.kicad_sch` KiCad 10.0.8 CLI ile tekrar işlendi: netlist export **exit 0**, şema BOM export **exit 0**, ERC **exit 0 / 0 hata / 0 uyarı**. Rapor: `validation-reports/lite-v2-schematic-erc.txt`; netlist ve BOM aynı klasörde.
- V2 adayında iki LTC6993 yerine tek çift-kanallı `CD74HC221M96` ve iki RC zaman ağı var. Bu CAD tutarlılığını sadeleştiriyor; pulse toleransı, power-up/reset davranışı ve gerçek bariyerle uyum hâlâ ölçülmemiştir. ERC raporunda dört bilinen exclusion var (tekil global label, birleşik bağlantı noktaları, SPICE model, footprint-filter mismatch); sıfır ERC mesajı bunları veya elektriksel onayı ortadan kaldırmaz.
- BOM çıktısı 40 referanslıdır; `U2 WT32-ETH01` için PCB footprint'i boş. `hardware/FAC-IO-Lite-V2.kicad_pcb` **yok**; bu nedenle V2 için DRC, Gerber, PnP, üretim BOM'u veya CAM kanıtı yoktur.
- Robotistan ürün sayfası WT32-ETH01'i **596,79 TL KDV dahil / tükendi** gösteriyor. Robotistan PCBA servisi dizgi için Gerber+BOM+Pick & Place ve tedarik edilecek parçalarda RobotistanPro/LCSC C kodu istiyor. Dolayısıyla WT32'li V2 şu anda Robotistan'dan tamamı takılı kart olarak hızlı teslim edilebilir rota değildir. Kaynaklar: [WT32-ETH01 ürün sayfası](https://www.robotistan.com/wt32-eth01-ethernet-modul), [Robotistan PCB servisi](https://www.robotistan.com/pcb-servisi).
- **Karar:** V2'nin elektronik sadeleşme yönü korunuyor; ancak PCB/üretim dosyası adımına geçmeden Robotistan'ın tedarik edebildiği Ethernet/ESP32 çözümü ve WT32'nin yerine geçecek stoklu modül netleştirilecek. V1'in hazır dört-katmanlı CAD'i fiziksel/tedarik/PCBA engelleri çözülmeden üretim alternatifi olarak onaylanmış sayılmaz.
- **Durum: üretime hazır değil.** Sonraki iş: mevcut BOM satırlarını Robotistan stok/tedarik eşleşmesiyle sınıflandırıp en az özel parça gerektiren uygulanabilir modülü seçmek; ardından yalnız seçilen mimari için PCB, DRC/parity, Gerber, BOM/PnP eşliği ve ilk-numune planını tamamlamak.

# 2026-11-10 — Lite V2 ilk entegre şema taslağı oluşturuldu
- Yeni `hardware/FAC-IO-Lite-V2.kicad_sch` ve `.kicad_pro` eklendi; V1 dosyaları korunarak WT32-ETH01, 12 V giriş/power, iki röleli kuru-kontak çıkışı, servis header'ı ve iki donanımsal darbe zamanlayıcısını içeren aday çıkarıldı. `hardware/fac_io.kicad_sym` içine yeni WT32 modül sembolü eklendi.
- KiCad 10.0.8 CLI'da şema netlist/BOM dışa aktarımı ve ERC çalıştı: **0 ERC error, 0 warning**. Aday netlistte TRIG1/TRIG2, OPEN/CLOSE COM/NO ve servis UART/reset hatları doğrulandı. Bu yalnız ERC ve CAD bağlantı tutarlılığıdır; elektriksel tasarım incelemesi veya üretime hazır olma kanıtı değildir.
- Şemada V1'den taşınan iki `LTC6993IS6-1` var; mimari taslaktaki CD74HCT221 gerçek şemaya henüz geçirilmedi. V2 bileşen azaltma hedefi için bu seçim açık. KiCad şema önizlemesi üretildi; okunabilirlik/yerleşim düzeltmesi gerekli.
- **Üretim engelleri:** WT32 sembolünde footprint yok; gerçek modülün 2×13 pad sırası/ölçüsü fiziksel örnekle doğrulanmadı. V2 PCB, DRC, Gerber, BOM/PnP ve üretici CAM onayı yok. Mevcut firmware ESP32-C3+W5500 hedefli olduğu için WT32'de çalışmaz; yazılım portu gerekir.
- Sıradaki: V2 pin bağlantılarını datasheet ile yeniden gözden geçir, şemayı okunaklı blok düzenine getir ve pulse-limiter bileşen seçimini doğrula; sonra fiziksel modül ölçüsüyle footprint/PCB'ye geç. Gerber üretme kapısı henüz kapalı.

# 2026-11-10 — Lite V2 GPIO arayüzü çıkarıldı
- WT32-ETH01'in resmî ana I/O ve debug pin tablolarından V2 aday net eşlemesi oluşturuldu: OPEN tetik GPIO32/CFG, CLOSE tetik GPIO33/485_EN; EN/IO0/TXD0/RXD0 servis programlama header'ına ayrıldı. Strapping hassas IO2/IO12/IO15 kullanılmıyor; Ethernet PHY pinleri modül içinde kalıyor.
- [gpio-map-lite-v2-draft.csv](hardware/gpio-map-lite-v2-draft.csv) ile [gpio-map-lite-v2-draft.md](hardware/gpio-map-lite-v2-draft.md) eklendi. Kaynak pin adlarını ve servis bağlantılarını tanımlar; gerçek PCB pad numaralarını bilerek tahmin etmez. Modülün tam 2×13 footprint sırası/ölçüsü hâlâ fiziksel modülle doğrulanmalı.
- Daha az parça/hedef maliyet için güç taslağı 5 V'tan 3.3 V WT32 beslemesine çevrildi; mevcut AP63203 3.3 V buck yeniden kullanım adayı. Regülatörün gerçek 500 mA+ kaynak, termal ve geçici rejim performansı doğrulanmadı.
- Güncel yerel liste fiyatı karşılaştırması WT32 yönünü destekliyor: Robotistan W5500 USR-ES1 348,49 TL + ESP32-C3 Mini 189,01 TL = 537,50 TL (C3 Mini stokta yok, soket/montaj hariç); Görsü WT32 404,51 TL + KDV ≈485,41 TL KDV dahil. Yaklaşık 52 TL görünen fark üretim teklifi değildir; WT32'nin ayrı üretici kaynağı/PCBA montajı ve yazılım port maliyeti ayrıca çözülmeli. Kaynaklar architecture notundadır.
- **Uyumluluk riski:** Mevcut firmware `ESP32-C3 + W5500` (RISC-V + SPI Ethernet) için derleniyor. WT32 klasik ESP32 + LAN8720 RMII kullanır; mevcut binary/firmware aynen çalışmaz, farklı firmware hedefi ve Ethernet başlangıç kodu gerekir. Bu fark V2 kararının üretim maliyetinden ayrı olarak çözülmeli; firmware uyumluluğu doğrulanmadan V2 şematik dondurulmayacak.
- Bu arayüz notundan sonra ilk V2 şematik taslağı ayrıca oluşturuldu (yukarıdaki güncel kayıt). Şematik ERC geçiyor, ancak elektriksel/pin/footprint incelemesi açık; V2 PCB ve Gerber hâlâ yok. Firmware uyumluluk ve WT32 tedarik/footprint riskleri çözülmeden üretim kilidi açılamaz.

# 2026-11-10 — WT32 Lite V2 tedarik kontrolü güncellendi
- Resmî WT32-ETH01 veri sayfası tekrar kontrol edildi: modülde ESP32 + Ethernet/RJ45 entegre; 5 V veya 3.3 V besleme seçeneklerinden yalnız biri seçilmeli ve güç kaynağı en az 500 mA sağlayabilmeli. 26 pinin sinyal görevleri verilmiş, ancak üretime esas ölçülü PCB land-pattern çizimi yok.
- Canlı katalog kontrolünde LCSC WT32-ETH01 C477837 **0 stok**, Robotistan ürün sayfası mevcut fakat stokta değil; Görsü Elektronik sayfasında WT32-ETH01 **404,51 TL + KDV / stokta var** görünüyor. Bu nedenle V2 modülü başka satıcıdan satın alınabilir aday, Robotistan'ın tedarik edeceği/haricî müşteri modülünü dizgiye alacağı ise doğrulanmış değil.
- Tasarım kararı değişmedi: WT32 tabanlı yeni 2 katmanlı taşıyıcı kart en az elektronik blokla devam edecek. Ancak modülün pin/delik geometrisi fiziksel numune ile ölçülmeden footprint/Gerber üretim onayı verilmeyecek. V1 dosyaları korunuyor.
- Kaynaklar: [WT32 üretici veri sayfası](https://www.mouser.com/datasheet/2/744/WT32_ETH01_datasheet_V1_1__en-2487862.pdf), [Robotistan](https://www.robotistan.com/wt32-eth01-ethernet-modul), [Görsü Elektronik](https://gorsuelektronik.com/wt32-eth01-esp32-tabanli-serial-to-ethernet-modul), [LCSC](https://www.lcsc.com/product-image/C477837.html).
- Bu aşama yalnız tedarik/arayüz doğrulamasıdır; sonraki tarihli kayıt ilk V2 şematik taslağını ve ERC sonucunu kaydeder. V2 PCB ve üretim dosyası yoktur.

# 2026-11-10 — Sade/ucuz revizyon için Ethernet modülü ve üretim yolu karşılaştırıldı

## 2026-11-10 — Lite V2 yönü seçildi (CAD'e geçiş öncesi)
- Mevcut WIZ850io (LCSC C134462, 1 adet $22.89) + ESP32-C3 modülü (C2934560, 1 adet $3.32) yerine Ethernet/RJ45'i üzerinde taşıyan WT32-ETH01 modülü seçildi. Robotistan sayfasında 596,79 TL KDV dahil ve stokta yok; Görsü Elektronik sayfasında 404,51 TL + KDV ve stokta var. Bu, V2'nin parça sayısını ve kaynak donanım maliyetini azaltma yönünde somut aday; farklı satıcıların fiyatı kesin üretim maliyeti karşılaştırması değildir.
- V2'nin ilk şema kararları [FAC-IO-Lite-V2-architecture.md](hardware/FAC-IO-Lite-V2-architecture.md) içine yazıldı: 12 V girişten 5 V/1 A buck, WT32'ye 5 V, iki 12 V G6K-2P-Y kuru-kontak röle, AO3400A sürücüler ve 5 V TTL tetik uyumlu çift CD74HCT221 zamanlayıcı; USB-UART kaldırılıp UART/BOOT/EN servis header'ı bırakılacak.
- Manufacturer kaynakları WT32'nin Ethernet/RJ45, pin tablosu, tek besleme seçimi ve en az 500 mA besleme ihtiyacını doğruluyor; TI CD74HCT221'in çift resetli monostable ve TTL uyumlu giriş olduğunu doğruluyor. WT32'nin ölçülü mekanik footprint'i üretici veri sayfasında yok. Fiziksel modül örneği veya ölçülü çizim, Robotistan'ın müşteri tedarikli modülü dizgiye kabulü ve RC pulse toleransı açık üretim kapılarıdır.
- Eski CAD'e direkt 2 katman müdahalesi yok. Sonraki CAD işi yeni `FAC-IO-Lite-V2` entegre şematiği ve PCB'si; V1 DRAFT ve Gerber'ler yedek/karşılaştırma için korunuyor.

## 2026-11-10 — İki katmana düşürme denemesi
- V1 kartının kopyasında iç katman izleri/viaları çıkarıp 2 katmanlı aday oluşturuldu. İlk gerçek KiCad DRC sonucu: **103 ihlal, 85 bağlantısız öğe**; bu kopya üretime uygun değil.
- Freerouting 2.4.1 ile, bölgeler kaldırılmış DSN üzerinde 40 geçişli deneme başlatıldı. Fanout 147 SMD pad'in 124'ünü çıkardı; otomatik yönlendirme 12 geçişten sonra **33 bağlantısız öğe ve 48 ihlalde takıldı**. `normalizeTraces` tekrar uyarıları ve artmayan skor nedeniyle deneme durduruldu; SES/üretim dosyası alınmadı.
- Bu sonuç, iki katmanın imkânsız olduğunu değil, mevcut yerleşimin iki katmana doğrudan çevrilemeyeceğini gösteriyor. Sonraki doğru adım daha az parçalı ve iki katman için baştan yerleştirilmiş yeni revizyondur; V1 üretim dosyaları korunacak.

- Hedef netleştirildi: Robotistan’dan mümkün olduğunca az parçalı, iki katmanlı ve montajlı bir kart almak; mevcut V1’in dört katmanlı Gerber’ini tek katman fiyatıyla sipariş etmemek.
- Sıfırdan en basit alternatif olan Wireless-Tag WT32-ETH01 incelendi. Üretici veri sayfası modülde ESP32, LAN8720A ve RJ45 bulunduğunu; modülün PCB’ye yarım delikli pad veya delikli bağlantıyla lehimlenebildiğini doğruluyor. Robotistan ürün kodu 24229 sayfası incelenirken modül 596,79 TL ve stokta yok görünüyordu; bu nedenle Robotistan’dan hızlı/ucuz PCBA yolu olarak doğrulanmadı. LCSC `C477837` katalog kaydı var, fakat açılan sayfa stok miktarı veya fiyat vermiyor. Haricî Türkiye satıcılarında görülen yaklaşık 702 TL fiyat, Robotistan PCBA tedarik/monte kabulü kanıtı değildir.
- WT32-ETH01 ile devam etmek ESP32-C3 + W5500 hedefini ve mevcut firmware Ethernet sürücüsünü değiştirir. Şu an en az riskli tasarım yönü ESP32-C3 + WIZ850io modüllerini koruyup taşıyıcı kartı küçültmek; USB/programlama, besleme, iki kuru kontak çıkış ve donanımsal darbe sınırını yalnız ihtiyaca göre tutmaktır. Yeni revizyon/fiyat karşılaştırması ve BOM/PCB üretilebilirliği doğrulanmadan bu karar üretim onayı sayılmaz.
- Tedarik engeli olan iki adet tek kanallı LTC6993 yerine araştırılacak maliyet/stok adayı TI `CD74HC221M96` (LCSC `C133954`) bulundu: TI bunu resetli, iki kanallı monostable olarak tanımlıyor ve tetiklemeden sonraki girişlerin aktif darbeyi değiştirmediğini belirtiyor; LCSC katalog sayfasındaki anlık görüntüde 1.022 adet stok ve 10 adette $0,50/adet görünüyordu. Bu parça henüz seçilmedi; RC toleransları, çıkış/reset/power-up davranışı, üretici stok güncelliği ve şematik/PCB yeniden yönlendirmesi doğrulanmalı.
- Mevcut V1 kaynak CAD’i KiCad 10.0.8 ile yeniden kontrol edildi: ERC **exit 0, 0 hata/uyarı** (dört exclusion raporda listeleniyor); zone refill + schematic parity DRC **exit 0, 0 ihlal, 0 bağlantısız pad, 0 footprint hatası, 0 parity sorunu**. Bu yalnız mevcut dört katmanlı CAD kural kontrolüdür; yeni sade revizyonu, elektriksel güvenliği, üretici kabulünü veya fiziksel ürünü doğrulamaz.
- Sonraki iş: aynı firmware hedefini koruyan küçük revizyonun gerçek şematik/BOM kapsamını dondurmak, uygun iki katman yerleşimi oluşturmak ve tedarikçi BOM/PnP akışına göre fiyatı tekrar ölçmek. Üretim Gerberi, yalnız yeni revizyon ERC/DRC/parity ve CAM kontrollerinden geçtikten sonra çıkarılacak.

# 2026-11-10 — Tedarik engeli olan pasifler BOM/CAD'e eşitlendi

- Robotistan BOM ekranında stok sorunu görülen pasiflerden altı referans için, değer/gerilim sınıfı/dielektrik/ayak izi eşleşen stoklu katalog alternatifleri seçildi: C3/C8/C30 → YAGEO `CC0603JRX7R9BB104` (C91183, 100 nF/50 V X7R, 0603); C9 → YAGEO `CC1206KKX7RDBB102` (C23631, 1 nF/2 kV X7R, 1206); C28/C29 → KEMET `C0805C104K1RACAUTO` (C141125, 100 nF/100 V X7R, 0805). LCSC kataloglarında bu MPN'ler stoklu listeleniyor; Robotistan'ın satın alma/dizgi kabulü henüz doğrulanmadı.
- Schematic ve PCB yalnızca MPN alanları bakımından eşitlendi; footprint, pad, net ve routing değiştirilmedi. `hardware/bom-draft.csv`, PCBA CSV ve iki BOM XLSX'inde MPN, katalog kodu ve değer güncellendi. `manufacturing/REVIEW-2026-11-10-PCBA-DRAFT/bom/schematic-bom.csv` da güncel CAD MPN'lerini içeriyor. 56 PCB referansı ve PnP koordinatları değişmedi.
- KiCad 10.0.8 yeniden çalıştırıldı: ERC **exit 0, 0 hata / 0 uyarı** (raporda dört bilinen exclusion görünür); refill + schematic parity DRC **exit 0, 0 ihlal / 0 bağlantısız pad / 0 parity sorunu**. Raporlar depo ve PCBA taslak paketinde yenilendi. Robotistan BOM XLSX'i Artifact Tool ile dışa aktarıldı ve 3 alternatif satır yeniden okunup/render edilerek doğrulandı. Paket SHA-256 manifesti yenilendi.
- Üretim kararı değişmedi: V1 PCB dört katman; Robotistan yapılandırıcısındaki tek katmanlı fiyat bu CAD'e uygulanamaz. İki katmana yeni tam routing henüz yapılmadı. 5 BOM kodu hâlâ boş (C1, C2, L1, SW1, SW2); LTC6993 sayısı 5 kart için yetersiz; WIZ850io'nun Robotistan'da temini ve J6/J7'ye fabrika takılması onaylanmadı. Bağımsız elektrik/CAM incelemesi, gerçek bariyerle OPEN darbesi ve ilk ürün testleri de açık.
- **Durum: üretim emri için hazır değil.** Sonraki iş: kalan BOM/monte edilebilirlik engellerini Robotistan'ın gerçek sourcing akışıyla kapatmak ve ancak eşdeğer 2-katmanlı CAM teklifi doğrulanırsa ayrı V2 routing yapmak. V1'in dört katmanlı Gerber'i tek katmanlı seçeneğe yüklenmemeli.

# 2026-11-10 — Sade kart / iki katman maliyet azaltma fizibilitesi

- Ölçülen mevcut KiCad V1: 4 bakır katman, 501 iz parçası ve 125 via; izlerin 89'u In1.Cu, 49'u In2.Cu üzerinde. Bu yüzden Robotistan'da katman sayısını 1/2 seçmek mevcut Gerber'i değiştirmez; yeni iki katmanlı PCB yerleşimi ve yönlendirmesi gerekir.
- Doğrudan iki katmana indirme fizibilite denemesi sadece `/tmp` kopyasında yapıldı; 138 iç-katman izi çıkarıldı, özgün PCB'ye dokunulmadı. Deneme DRC'si **89 ihlal / 51 bağlantısız pad** verdi; dolayısıyla bu dönüşüm Gerber olarak verilemez ve kapsamlı yeniden yönlendirme gerektiriyor.
- Mac ARM64 FreeRouting CLI 2.5.0 dosya checksum'u yayınlanan SHA-256 ile eşleşti ve iki katmanlı DSN'yi yükledi; ancak routing işi board snapshot serileştirme exception'ında durdu, `.ses` üretmedi. Otomatik yönlendirme sonucu CAD'e alınmadı; özgün V1 değişmedi.
- Aynı anda özgün V1 tekrar KiCad 10.0.8 ile kontrol edildi: ERC **0 error / 0 warning** (dört exclusion raporda görünür); zone refill + schematic parity DRC **0 ihlal / 0 bağlantısız / 0 eşlik sorunu / 0 ignored check**. Bu, elektriksel ürün doğrulaması veya üretim onayı değildir.
- V1'in elektronik blokları ESP32-C3 modülü, WIZ850io (W5500 + Ethernet), 12 V korumalı besleme, iki bağımsız kuru kontak röle ve iki donanımsal non-retriggerable darbe sınırlayıcıdır. 56 referansın önemli kısmı bypass/protection ve güvenli röle sürüşüdür; yalnızca parça sayısını azaltmak, kartın doğru veya ucuz kaldığını kanıtlamaz.
- İki katmanlı yeniden tasarımın Robotistan maliyeti/termin avantajı için karşılaştırılabilir güncel fiyat teklifi henüz yok. 1 katmanlı yapılandırıcı ekranındaki fiyat, 4 katmanlı mevcut CAD ile eşdeğer değildir. Bu nedenle V1'in “gereksiz” olduğu veya sıfırdan V2'nin daha ucuz/hızlı olacağı doğrulanmış sayılmıyor.
- Üretim hedefi değişmedi: Robotistan'ın kartı parçaları takılmış halde göndermesi. Bunun için üretici tarafından alınabilir/monte edilebilir BOM satırları ve WIZ850io'nun fabrika montaj kabulü kritik; Gerber tek başına bu teslimatı sağlamaz.
- Güncel tedarik araştırması: Robotistan ürün kataloğunda 0805 150 nF/50 V seramik kapasitör SKU 24019 ve 1206 1 nF/50 V SKU 17922 listeleniyor. İlk ürünün exact üretici MPN'si yayınlanmıyor; ikinci ürün C9'un 2 kV değerinin yerine kullanılamaz. Bu nedenle bunlar Robotistan Pro PCBA için doğrulanmış ikame sayılmadı ve CAD/BOM'a işlenmedi. Samsung'un üretici sayfası 150 nF/50 V X7R 0805 sınıfını doğruluyor, fakat Robotistan SKU 24019 ile birebir parça kimliği eşleşmesi açık değil.
- Darbe sınırlayıcı için TI SN74LV221A teknik olarak 2–5.5 V çift monostable seçeneğidir; ancak tedarikçi verileri paket/ömür durumu tutarsız ve Robotistan PCBA stoğu kanıtlanmamış. LTC6993 yerine geçecek şekilde seçilmedi.
- Sıradaki somut iş: mevcut V1'in tedarik blokajlarını exact-spec üretici alternatifleriyle kapatmak ve Robotistan'ın güncel stok/dizgi teklifini almak. Ancak doğrulanabilir toplam maliyet/termin avantajı çıkarsa, ayrı V2 olarak iki katmanlı yerleşim yapılacak; V1 kaynakları korunacak.

# 2026-11-10 — Lowest-cost/fastest route checked against fresh CAD and supplier evidence

- Re-ran local KiCad 10.0.8 on the current V1: ERC **0 errors / 0 warnings** (four listed exclusions remain visible in the report); refilled DRC with schematic parity **0 violations / 0 unconnected pads / 0 footprint errors / 0 parity issues**. Reports refreshed at `validation-reports/schematic-erc.txt` and `validation-reports/pcb-drc.txt`.
- The current four-layer design and Gerbers already exist, so a full V2 would add re-layout, new Gerber quote and new first-article risk. Robotistan's upload dialog has inflated component counts because it received order-total quantities rather than per-board BOM quantities; the prepared `Robotistan-BOM.xlsx` is per-board (for example C1=1, R30=1, U5/U6=2) and is the fastest next supplier check.
- Cost leads are not directly comparable: the user's Robotistan screenshot shows $136.97 for the selected five-board offer; KinCony's official KC868-A2v3 listing is $55 each but currently says sold out and does not establish delivered price to Turkey. No cheaper turnkey replacement is proven yet.
- A lower-cost timer candidate was identified for a possible V2: TI SN74LV123ADR is dual-channel and operates at 2–5.5 V, but it is retriggerable. A repeated trigger can extend the output, so it is not an approved replacement for the current non-retriggerable LTC6993-1 barrier pulse limiter; timer truth table, maximum-pulse behavior, stock and CAD changes would need validation first. The non-retriggerable SN74LV221A family is another research lead, with supplier code/stock unresolved. No timer substitution was applied.
- The PCBA review package manifest now verifies all listed deliverables; volatile Finder `.DS_Store` metadata was excluded. `git diff --check` exits 0.
- Decision for the objective: first upload the prepared per-board Robotistan BOM and obtain a corrected assembly/source quote; preserve V1. Start a cheaper V2 only if the corrected quote remains uneconomic or sourcing is rejected. Production remains unapproved; no purchase order or fabricated first article exists.

# 2026-11-10 — Robotistan example BOM and Pick & Place files prepared

- Filled the user's Robotistan templates: BOM has 34 grouped MPN rows covering 56 fitted PCB references plus EXT1 WIZ850io; PnP has the exact 56 CAD placements, coordinates, rotations and top/bottom layers. Both XLSX files round-trip through the workbook reader; template headers and BOM/PnP PCB reference sets match. Per-board quantity is 57 including the module.
- The WIZ850io BOM row (C134462) explicitly requests factory insertion into J6/J7. It is not in the CAD PnP because the current schematic/PCB represents it as a plug-in external module, not a main-board centroid. Robotistan must accept this manual installation item; do not invent a centroid to force parity.
- BOM C codes remain blank for C1, C2, L1, SW1 and SW2; exact MPNs are present. A portal-only stock check may classify these as customer-supplied. Files are ready for supplier quotation/review, not a fully source-confirmed assembly order.
- CAD unchanged. KiCad ERC/DRC evidence remains applicable. XLSX render and round-trip reviews passed; PCBA package SHA-256 manifest verifies 24 files and `git diff --check` passes.

# 2026-11-10 — BOM adapted to the supplied XLSX template

- Replaced the generic workbook with the user's `default_bomlist.xlsx` template columns: Fabrika Kodu, Açıklama, Designatör, Malzeme Kılıfı, Adet. Grouped the 56 PCB references by exact manufacturer MPN into 33 supplier rows, with Adet as per-board quantity, and added EXT1 WIZ850io as a separate factory-install item. Sum is 57 physical parts per board including the Ethernet module.
- Rendered the workbook and verified its exported XLSX round-trip, template headers, reference coverage, numeric per-board quantities and module row. The LCSC/RobotistanPro codes for C1, C2, L1, SW1 and SW2 remain unresolved in the PCBA portal BOM. MPNs are supplied in this template for sourcing quotation; availability is not yet confirmed.
- KiCad CAD was not edited; existing ERC/DRC evidence remains applicable to the CAD. Package SHA-256 manifest verifies 20 files, and `git diff --check` passes.
- This remains a review/quotation draft, not an approved order. Robotistan must confirm sourcing and install WIZ850io into J6/J7 before shipment; first-article validation remains open.

# 2026-11-10 — PCBA scope clarified for Robotistan factory delivery

- Confirmed from Robotistan's current PCB service documentation that PCB dizgi uses Gerber + BOM + Pick & Place and that THT/SMD parts, sourcing, and assembly are selected in the same flow. This supports the requested factory-assembled delivery; it does not itself prove every component or the plug-in Ethernet module is accepted for this particular order.
- Added WIZnet WIZ850io as factory-installed external assembly item EXT1, LCSC C134462, with a supplier instruction to insert it into J6/J7 before shipment. The user is not expected to install it. Robotistan’s manual final insertion acceptance and supply remain unconfirmed.
- Added `manufacturing/REVIEW-2026-11-10-PCBA-DRAFT/bom/robotistan-component-sourcing-request.csv` for the five exact MPNs whose online catalog codes remain unresolved (C1, C2, L1, SW1, SW2), quantities for five boards. No substitutions or guessed codes were introduced.
- Refreshed PCBA readiness text and package manifest. This is still a quotation/review draft, not an order-ready release: five catalog codes/sourcing, module insertion acceptance, assembly availability/stock, independent electrical review and first-article verification remain open. Firmware flashing and enclosure are separate follow-on steps.

# 2026-11-10 — Current-source bare-PCB review bundle staged

- PCBA path: the requested outcome is an assembled FAC-IO board. Created `manufacturing/REVIEW-2026-11-10-PCBA-DRAFT/` by adding the Robotistan BOM and Pick & Place to the current-source bare-PCB evidence. Fresh KiCad 10.0.8 schematic BOM matches all 56 references' values/footprints/MPNs; fresh position export matches all 56 designators' coordinates/rotation/side. Five supplier codes are still blank (C1, C2, L1, SW1, SW2); WIZ850io is a separate plug-in module and is not in the 56 placements. PCBA release gate is intentionally blocked by absent independent approval; do not place assembly order from this DRAFT.
- Supplier configurator check: user selected 1 copper layer for a price estimate, but the current KiCad source and Gerber archive are 4-layer (F.Cu/B.Cu/In1.Cu/In2.Cu). Fresh KiCad 10.0.8 exports contain 662 F.Cu, 211 B.Cu, 272 In1.Cu and 231 In2.Cu Gerber objects; the current PCB has 125 through-vias. A 1-layer order would not match this design and cannot be fixed by changing the supplier dropdown. Select 4 layers for this revision, or complete a full PCB reroute and repeat ERC/DRC/parity and Gerber validation for any layer reduction. No source CAD was changed.
- Final local rerun: KiCad `10.0.8`; ERC exit 0 / 0 errors / 0 warnings; refilled DRC with schematic parity exit 0 / 0 violations / 0 unconnected pads / 0 footprint errors / 0 parity issues; JSON reports zero ignored checks. Refreshed the repository validation reports and the review bundle copies from this run.
- `git diff --check` and manufacturing gate tests **8/8** pass. Review bundle SHA-256 manifest and Gerber ZIP CRC both verify. `release_check.py --profile pcb --root manufacturing/REVIEW-2026-11-10-DRAFT` remains blocked only by the intentionally absent independent `release/APPROVED.txt`; repository PCB profile is missing five release files and PCBA seven.
- Independently checked Excellon record structure: PTH has 177 round hits plus 4 `G85` slots; NPTH has 6 round hits; all coordinates are inside Edge.Cuts. KiCad's `G90` body command after `%` matches the command placement shown in JLCPCB's published Excellon fragment. Gerbonara's message remains as a parser warning, but is not evidence of malformed drill data. Added `validation-reports/excellon-structure.txt` and the same evidence to the review package. Robotistan CAM/stackup and slot acceptance remain open.
- Checked supplier-code candidates for C1, C2, L1, SW1 and SW2. Exact manufacturer MPN/spec sources are not proof of an available Robotistan/LCSC stocking code; LCSC live search returned HTTP 403 from this host. Left those catalog-code fields blank rather than inventing or substituting them. PCBA package is therefore not approved or complete.
- Re-ran local KiCad 10.0.8 against the current CAD: schematic ERC exit 0 / 0 violations; PCB DRC with zone refill and schematic parity exit 0 / 0 violations, 0 unconnected pads and 0 parity issues. Latest saved reports: `validation-reports/schematic-erc.txt`, `validation-reports/pcb-drc.txt`, and `validation-reports/pcb-drc-parity.json`. Fontconfig emitted host-only warnings.
- Exported all 11 Gerbers and both decimal-format Excellon files from the current PCB. Compared them with DRAFT-1.2 after normalizing only creation timestamps; all 13 layer/drill files match. Built `manufacturing/REVIEW-2026-11-10-DRAFT/gerber/FAC-IO-Mini-V1.zip` from those fresh exports plus the Gerber job file: 14 members, ZIP CRC pass. Gerbonara 1.6.3 parsed 11 Gerbers and 2 drills; Edge.Cuts is 110.10×77.10 mm, PTH count 181 including four slots, NPTH count 6. Gerbonara still flags G90 after the header in both Excellon files; the package records that and requires fabricator CAM/slot acceptance.
- Added `--root` to `manufacturing/release_check.py`, allowing checks and reviewer hash generation against an explicitly labelled review bundle. Review bundle includes current ERC/DRC/parity evidence, preview, drill/parser reports, SHA256 manifest and `NOT-APPROVED.txt`; it has no `APPROVED.txt`. The bare-PCB check against this bundle is blocked only by the missing independent approval. The repository default bare-PCB package still misses five release files; PCBA misses seven. No approval or production release was generated.
- Manufacturing gate regression suite passes **8/8**; `git diff --check` passes. Updated README, ROADMAP, validation guide and this status record. The design remains **NOT production-ready**: fabricator/supplier CAM and stackup acceptance, independent electrical review, purchasing/assembly confirmation, and physical first-article tests are open.

# 2026-11-10 — Signed ESP32-C3 security test build verified

- Fixed the isolated PlatformIO security profile after real CMake/build failures: pinned the available ESP-IDF 5.5.5 package (`framework-espidf ~4.50505.0`), removed a reference to a missing generic SDKConfig defaults file, enabled Arduino autostart and its required 1 kHz FreeRTOS tick, and selected the actual 4 MB flash size.
- Cross-checked the configured `ESP32-C3-WROOM-02-N4` MPN against Espressif's current module datasheet: it specifies chip revision v0.4; Espressif's Secure Boot V2 guide requires v0.3/ECO3 or newer. Firmware minimum revision 3 is compatible for this exact specified variant; incoming production lot/marking remains to be verified.
- `uvx --from platformio pio run -e fac_io_c3_security_test` exited 0 against `esp32-c3-devkitm-1`; PlatformIO reports 15,172 bytes RAM and 354,812 bytes in the 1 MB application partition. SDKConfig confirms ESP32-C3, minimum silicon revision 3, Secure Boot V2 and flash-encryption Release mode.
- Signed bootloader (28,672 bytes), application (397,312 bytes) and partition table (8,192 bytes) verified successfully with `espsecure v5.4.0` using a temporary RSA-3072 key. The key and signed test images were deleted after checks. Detailed build/config/signature exit codes and artifact hashes are recorded in `validation-reports/firmware-secure-build-test.txt`. ESP-IDF warned that no flash-encryption key was configured, so this does not prove a flash-encrypted production image. No firmware was flashed and no eFuse was changed. Test profile artifacts must never be flashed or distributed.
- Local verification: strict C++ host tests 5/5 using installed Mbed TLS 3.6.7; firmware Python 7/7, GPIO checker Python 5/5, manufacturing gate Python 7/7; `git diff --check` passes. The physical target, exact production module revision, networking, NVS fault behavior, relay pulses and reset/brownout behavior remain untested.
- Production gate remains **NOT READY**: bare PCB release check exits 1 for five missing approval/report/production Gerber files; PCBA exits 1 for those plus BOM and Pick & Place. CAM/supplier acceptance, independent electrical review, security-key custody/provisioning and first-article measurements are still open.

# 2026-11-10 — Release approval bound to exact reviewed artifacts

- Hardened `manufacturing/release_check.py`: reviewer approval now must carry SHA-256 values for the source CAD set, ERC/DRC/parity reports and Gerber ZIP; PCBA approval additionally binds BOM and Pick & Place. Any changed source or release artifact invalidates approval. Added `--print-approval-hashes` to produce values for reviewer entry after staging; it does not create approval.
- Added stale-CAD and stale-DRC negative-control tests. Release-gate suite passes **7/7**; `docs/validation.md` records the new approval fields and command. Latest DRAFT-1.2 ZIP's 13 layer/drill filenames match the gate's normalized `.gbr`/`.drl` expectations; the earlier native-extension DRAFTs are obsolete, so no suffix-check change was needed.
- Re-ran the real repository profiles after the gate change: bare PCB exits 1 on the five absent approval/report/production Gerber files; PCBA exits 1 on those plus BOM/Pick & Place (seven). DRAFT-1.2 Gerber ZIP passes CRC and contains all 13 required layers/drills plus the optional KiCad job file. `git diff --check` passes.
- No release approval or production outputs were created. Production readiness is still **NOT READY**.

# 2026-11-10 — Secure C3 build environment feasibility checked

- Rechecked the current host and PlatformIO profile: no `idf.py` or `framework-espidf` installation is present in the local search paths; the security profile requests `arduino + espidf`, ESP-IDF SDKConfig defaults and an external signing key. `pio project config --json-output` parses these settings successfully, but this is configuration evidence only.
- Only 1.6 GiB is available on the data volume and no external build volume is mounted. The secure target build was not attempted because installing/building ESP-IDF under this space limit risks a partial package and still cannot establish a reproducible signed image. No eFuse/device operations occurred.
- The profile remains unverified. Next target-build step requires a build volume with adequate free space or an already provisioned ESP-IDF 5.5.5 environment; continue local design/release review meanwhile.

# 2026-11-10 — DS-TMG42X command input electrical limit clarified

- Matched the `UD30852B-A` DS-TMG42X manual listed on Hikvision's official support page with its indexed section 2.4.3: it instructs connecting the barrier's opening/closing command pairs to the corresponding Access ANPR camera outputs. It publishes no command input electrical limits in the reviewed section.
- **Correction:** an earlier draft of this entry incorrectly applied a DC 12 V maximum from a DS-TMG52X manual to DS-TMG42X. That value was removed from all three technical documents; it is not valid evidence for the target model. The 42-Series brochure still supports the Rising/Falling command names and warns that continuous closing can lock the barrier. Command contact limits and acceptable pulse width remain unknown; keep outputs isolated and first-article compatibility testing as release gates. No CAD change or compatibility approval was made.
- Re-ran local KiCad 10.0.8 against current CAD: schematic ERC exit 0 / 0 violations; PCB DRC with zone refill and schematic parity exit 0 / 0 violations / 0 unconnected items / 0 parity issues. Refreshed `validation-reports/schematic-erc.txt` and `validation-reports/pcb-drc-parity.json`; JSON reports empty violation/unconnected/parity arrays. `git diff --check` passes.
- Release-gate rerun remains blocked as expected: bare PCB profile misses approval, release ERC/DRC/parity records and production-named Gerber ZIP (5 files); PCBA additionally misses BOM and Pick & Place (7 files). These were not fabricated.
- Production status remains **NOT READY**. Next: resume the current verified-release blockers: secure C3 target build/signing (1.6 GiB available, ESP-IDF package absent), supplier/CAM/mechanical and independent review, and first-article contact/timing/power/fail-safe tests.

# 2026-11-09 — ESP32-C3 development target build and full CAD/host regression rerun

- Installed PlatformIO Core 6.2.0 via `uvx`; used a temporary `/tmp` low-disk package-install wrapper to avoid the installer's duplicate 2.16 GB toolchain copy. Official target packages resolved as Arduino-ESP32 3.3.12 / ESP32-C3 libs 3.3.12, espressif32 8.0.0 and RISC-V toolchain 14.2.0+20260121. The wrapper is not in the repository.
- Corrected the flash-encryption API to `esp_flash_encryption_enabled()` from the installed SDK header. The real C3 build then exposed USB mode selection: `USBSerial` was undefined because the C3 hardware USB Serial/JTAG mode was not selected. Added `ARDUINO_USB_MODE=1` alongside CDC-on-boot and extended the GPIO config checker and negative-control tests to require it.
- `pio run -e fac_io_c3` now exits 0 and produces `.pio/build/fac_io_c3/firmware.bin` (373,694 bytes flash image; 15,692 bytes RAM / 327,680). This is a prototype/dev target build only: current config does not sign Secure Boot firmware or provision production flash encryption, so the command service remains fail-closed. No device upload or eFuse operation occurred.
- Re-ran host tests: C++ 5/5 with `-Wall -Wextra -Werror -pedantic` and installed Mbed TLS 3.6.7; firmware Python 7/7; GPIO config/startup 5/5; manufacturing gate 5/5; static GPIO checker 11/11. KiCad 10.0.8 netlist export, schematic ERC (0 violations) and refilled PCB DRC/parity (0 violations, 0 unconnected, 0 parity issues, 0 ignored checks) all exit 0. Fontconfig warnings are environment-only.
- Re-ran both manufacturing profiles: `--profile pcb` remains blocked by 5 missing release files; `--profile pcba` by the same 5 plus production BOM and positions. No approval marker or production package was created. `git diff --check` passes.
- Updated `firmware/src/main.cpp` SDK API call, `firmware/platformio.ini`, `hardware/gpio_check.py`, and `hardware/test_gpio_check.py`. No PCB or manufacturing source changed. Production release remains NOT READY; secure production configuration/signing, LPR integration, physical board bring-up, supplier/CAM/mechanical/independent review and first-article tests are still open.

# 2026-11-09 — Secure firmware build profile corrected; full sign/build still unverified

- Inspected the installed PlatformIO 8.0.0 builder and found that a profile using only `framework=arduino` ignores the ESP-IDF security SDKConfig path. Its first trial produced ordinary unsigned prototype artifacts; these were explicitly discarded along with the disposable `/tmp` test key and were not treated as security evidence.
- Corrected `fac_io_c3_security_test` to use the supported `arduino, espidf` component build, pinned ESP-IDF 5.5.5 (`framework-espidf ~3.50505.0`, matching the installed Arduino/C3 libraries), separate SDKConfig defaults, Secure Boot V2 RSA signed binaries and flash-encryption Release mode. Secure Boot key path comes from `FAC_IO_SECURE_BOOT_SIGNING_KEY`; no private key is stored in the repository. PlatformIO configuration parsing confirms the selected frameworks/config paths and required options.
- A genuine signed image build was not run: the required ESP-IDF package is absent from `~/.platformio/packages`, with 267 MiB free on the data volume. No package installation was attempted. No flash/upload/eFuse operation occurred. First boot of a Release-mode image can irreversibly configure security eFuses; production image provisioning remains an explicit first-article task.
- `firmware/README.md` and `docs/validation.md` now distinguish this unverified secure profile from the passing ordinary development build. Next: run the secure profile on a build host with sufficient storage using a disposable signing key, inspect the signed bootloader/app and SDKConfig evidence, then separately define production-key custody and per-device flash-encryption provisioning. Do not flash the test image.

# 2026-11-09 — Host CI test linking fixed; complete local verification rerun

- Reproduced the repository's previous `.github/workflows/firmware-host-tests.yml` loop locally; it failed to link the pulse-parser and request-auth tests because their implementation sources were omitted. Updated the workflow to install the Mbed TLS development package and explicitly compile each test with its source dependencies and `libmbedcrypto`.
- Ran all five C++ host executables locally with strict warnings against installed Mbed TLS 3.6.7: **5/5 passed**. Firmware client Python tests: **7/7**; GPIO startup Python tests: **4/4**; manufacturing gate tests: **5/5**; GPIO static checker: **11 signal assignments pass**. The GitHub Actions run itself has not been observed.
- Re-exported the current schematic netlist and reran KiCad 10.0.8. Netlist exit 0; ERC exit 0 / 0 violations; zone-refilled DRC plus schematic parity exit 0 / 0 violations / 0 unconnected pads / 0 parity issues / 0 ignored checks. `git diff --check` passes. Fontconfig warnings are host-only.
- Production release gate remains blocked; no approval or production package was created. A renewed ESP32-C3 install attempt got through archive extraction but failed moving the 2.16 GB unpacked toolchain into the package directory because the package manager temporarily needs both staging and destination copies. Removed that incomplete toolchain directory (it had no `.piopm` install record) and duplicate retry archives; one re-downloadable 558 MB archive remains and free disk is restored to 2.5 GiB. No target binary resulted. The toolchain alone needs about 5 GiB transient space with this installer; framework/build packages require additional room. Next: use a sufficiently provisioned build host or free adequate workspace, then continue target secure build, exact sourcing, mechanical/CAM review and first-article validation.

# 2026-11-09 — Hikvision command interface evidence corrected

- Checked Hikvision's official 42-Series brochure. It supports the interface names **Rising Control ±** / **Falling Control ±** and warns that only pulsed closing signals are supported; a continuous closing signal can lock the barrier. The brochure does not substantiate J4/J5 terminal numbers, input voltage, minimum contact load or a 503 ms pulse window.
- Removed the unsupported J4/J5 claim and corrected README, requirements, architecture and first-article validation wording. Installation guidance now requires wiring only to the exact board's physically labelled, isolated command pair; power/ground/motor/mains are excluded.
- No CAD or manufacturing content changed in this milestone. `git diff --check` passed. Installed KiCad 10.0.8: schematic ERC exit 0 / 0 violations; PCB DRC using `--refill-zones --schematic-parity --format json --exit-code-violations` exit 0 / 0 violations / 0 unconnected pads / 0 parity issues. An initial DRC without zone refill reported two stale-fill clearance items; the required refilled-zone run is clean. Fontconfig emitted environment warnings only.
- Manufacturing release-gate regression suite passed 5/5 tests. Actual `release_check.py --profile pcb` exits 1 for five missing approval/report/production Gerber files; `--profile pcba` exits 1 for those plus BOM and Pick & Place. `git diff --check` passes; no release files or approval were created. The verified Hikvision command wording was also aligned in `hardware/component-selection-v1.md`.
- Target build toolchain is still unavailable: no `pio`, `idf.py` or `riscv32-esp-elf-g++`; `~/.platformio/packages` is empty and the data volume has only 2.0 GiB free. Do not remove unrelated user caches to force an installation. The current PlatformIO config also does not establish the required signed Secure Boot / flash-encryption production build.
- **Disposition remains NOT production-ready.** Next: continue target firmware build/integration, exact sourcing and mechanical/CAM approval, independent electrical review, and first-article barrier pulse/fail-safe validation. No fabrication approval or production package is inferred.

# 2026-11-09 — ESP32-C3 target build attempted with recovered PlatformIO CLI

- Rechecked machine state: no global `pio`, ESP-IDF, or RISC-V compiler was installed; `~/.platformio/packages` was empty. `uvx --from platformio pio --version` successfully provided PlatformIO Core 6.2.0 without adding a repo dependency.
- Ran `uvx --from platformio pio run -e fac_io_c3` in `firmware/`. The manager began installing `toolchain-riscv32-esp @ 14.2.0+20260121`, but unpacking stopped with `Errno 28: No space left on device`; mirror retry was cancelled. No target compilation or binary resulted.
- The cached toolchain tar is 584,612,113 bytes compressed and contains 2,163,660,043 bytes uncompressed. Three byte-identical copies (SHA-256 `55a35871a174a321dfa4643bae16ae0a8ae2bb62318e2d774f94bbc616b34067`) had accumulated during retries. Removed the two duplicate cache copies, retained one, and restored free space to 2.5 GiB. No project files or user source files were removed; `~/.platformio/packages` remains empty.
- **Disposition remains NOT production-ready.** Next: obtain enough free disk for the complete target toolchain/framework and signed-production build, then resume integration/build; independent electrical/CAM review, sourcing, physical fit and first-article tests remain open.

# 2026-11-09 — Bare-PCB and PCBA release gates separated

- Robotistan'ın resmî PCB servis akışını kontrol ettim: çıplak kart için Gerber yeterli ve standart minimum 5 adet; PCBA için ayrıca BOM ve Pick & Place gerekiyor. Robotistan'ın tedarik edeceği BOM parçalarında C kodu stok/fiyat eşleştirmesi için kullanılıyor. Beş belirsiz katalog kodu bare-PCB Gerber teslimini engellemiyor, ancak Robotistan tedarikli dizgiyi engelliyor.
- `manufacturing/release_check.py` artık `--profile pcb` ve varsayılan `--profile pcba` seçeneklerine sahip. İki profil de profil ile eşleşen onay kaydı, 0 ERC/DRC kanıtı ve üretim-named Gerber ZIP ister; PCBA profili ayrıca BOM/PnP eşliği, MPN ve C-kodlarını kontrol eder. Bir onay dosyası başka profile aitse reddedilir.
- Beş release-check regresyon testi geçti (`python3 -m unittest discover -s manufacturing -p 'test_release_check.py' -v`); Python syntax ve `git diff --check` geçti. Gerçek projede `--profile pcb` hâlâ 5 eksik onay/rapor/ZIP dosyası, `--profile pcba` 7 eksik dosya nedeniyle exit 1; üretim paketi veya onay oluşturulmadı.

# 2026-11-09 — Fresh validation rerun and current blockers reconciled

- Re-ran installed KiCad 10.0.8 directly against current source: schematic ERC exited 0 with 0 violations; PCB DRC with zone refill and schematic parity exited 0 with 0 violations, 0 unconnected items and 0 parity issues. Refreshed `validation-reports/schematic-erc.txt` and `validation-reports/pcb-drc-parity.json`.
- Re-exported Gerber/Excellon from the current PCB into `/tmp`; all 14 fabrication files match DRAFT-1.2 after normalizing creation timestamps, and all 14 ZIP members exactly match their sidecars with CRC passing. A fresh KiCad position export matches the Robotistan Pick & Place coordinates/orientation/side for 56/56 references. A fresh schematic BOM export (`MPN` mapped to the package's `Manufacturer MPN` label) matches all 56 packaged schematic-BOM rows and six exported fields.
- Re-ran all available Python suites: firmware client 7/7, GPIO checker 4/4, manufacturing release-gate tests 3/3; `hardware/gpio_check.py` passes its 11 static assignments. Recompiled and ran all five standalone C++ host tests with strict warnings; the HMAC test used a temporary OpenSSL-backed mbedTLS shim, not the target mbedTLS binary.
- `manufacturing/release_check.py` exits 1 as expected and lists seven absent approval/report/production-package artifacts. This is a blocker result, not an approved release. The source/Robotistan/assembly BOM still has five supplier codes without confirmed identifiers.
- Queried LCSC's live global-search API for the five uncoded MPNs. The returned capacitor and switch listings are non-matching variants (voltage/MPN suffix or 160 gf vs the selected 100 gf switch), and no exact inductor listing was returned. Kept all five codes blank rather than inserting a plausible but wrong catalog number; Robotistan sourcing/import still needs supplier confirmation.
- Reconciled README wording: the host signer/client exists; production firmware signing and LPR integration do not. Current host has 2.0 GiB free, no `pio` or ESP-IDF CLI, and an empty PlatformIO packages directory; therefore no fresh ESP32-C3 target build was possible this rerun. No disk caches were removed and no eFuses were touched.
- **Disposition remains NOT production-ready.** Next: create a supported, reproducible signed/encrypted target build in a toolchain-capable environment; integrate client into LPR; then close source/CAM/mechanical/independent review and run first-article electrical and fail-safe tests. Do not submit the DRAFT package to fabrication.

# 2026-11-09 — Host pulse client and sequence-safe key setup added

- Added `firmware/tools/facio_client.py`: creates a cryptographically random 32-byte per-device key in a 0600 file, emits the physical USB pairing command, signs the fixed OPEN/CLOSE request, and sends it over HTTP. It stores a locked, atomic local uint64 sequence allocator with 256-command reservations; it advances only after an explicit server `replay` response and does not retry network timeouts, which could otherwise duplicate an accepted pulse.
- Added seven host tests covering the published HMAC vector, malformed inputs, key-file creation/permissions, actual signed HTTP framing to a localhost mock, sequence persistence/restart, replay-window recovery and no timeout retries. All seven pass; Python syntax/help checks and `git diff --check` pass. No request was sent to a physical device.
- Updated `README.md`, `ROADMAP.md`, `docs/network-contract.md` and `firmware/README.md` to identify the host helper accurately and keep deferred status/config APIs out of the implemented route list. The helper is not integrated into the LPR application and has not been tested against an ESP32.
- Re-ran KiCad 10.0.8 against current source: ERC 0 violations; DRC with zone refill and schematic parity 0 violations, 0 unconnected pads and 0 parity issues. Source, Robotistan and assembly BOMs match 56 references × 8 procurement/status fields; 51 codes are present and 5 remain uncoded. The release checker still fails on its seven absent approval/report/production-named artifacts. Production readiness remains blocked by target secure build, physical first-article verification, supplier/CAM approval and the missing release approval.

# 2026-11-09 — Candidate authenticated relay command path integrated

- Connected the fixed HTTP pulse parser, per-device HMAC-SHA256 verifier, sequence reservation/NVS persistence, shared relay guard, and GPIO trigger pulses in `firmware/src/main.cpp`. Only POST to relay 1/2 fixed pulse paths is accepted; request body and duration are rejected. Device MAC and HMAC must match; sequence ceiling writes complete before GPIO actuation. USB key setup/rekey is physically gated by pressing BOOT after normal startup, then sending `KEY:<64 hex chars>` within 60 seconds. This avoids holding GPIO9 low through reset, which would select the ESP32-C3 ROM downloader.
- Runtime commands require DHCP and active link, NVS readiness, Secure Boot enabled, flash encryption enabled and a key. Verified current official ESP-IDF declarations for `esp_secure_boot_enabled()` and `esp_efuse_is_flash_encryption_enabled()`; the code uses the non-deprecated flash-encryption check. **The current PlatformIO configuration still does not build/sign the required Secure Boot image or configure production flash-encryption mode, so this command service remains fail-closed in the current build.** No eFuses were modified.
- Verification: five standalone host C++ test executables pass with strict warnings (pulse parser, HMAC vector via temporary OpenSSL-backed mbedTLS shim, command policy, relay guard, sequence reservation); four GPIO startup tests and three production-gate regression tests pass. `hardware/gpio_check.py` passes. `main.cpp` and the firmware sources pass `-fsyntax-only -Wall -Wextra -Wpedantic -Werror` against API-shaped host stubs; this is not a target build. `git diff --check` passes.
- Re-ran KiCad CLI 10.0.8 on current CAD: ERC exit 0 / zero violations; PCB DRC with zone refill and schematic parity exit 0 / zero violations, unconnected pads, or parity issues. `manufacturing/release_check.py` still exits 1 because the seven approved-release artifacts are missing. Host reports contain Fontconfig warnings only.
- **Not production-ready:** no ESP32-C3 target build (2.0 GiB free; prior PlatformIO toolchain extraction failed for lack of space), no secure production firmware configuration/signing, physical board, first-article pulse/fail-safe test, or manufacturing approval. The host signer/client was added in the following milestone. Next: integrate it with LPR, establish a reproducible signed/encrypted target build, then perform first-article verification before considering release.

# 2026-11-09 — Firmware and fail-safe contracts reconciled with source behavior

- Updated `README.md`, `docs/network-contract.md`, `docs/firmware-interface.md` and `docs/validation.md` to match the current candidate firmware. Documented that only the two pulse routes exist in source, the current build is fail-closed, the server returns trigger acceptance without barrier feedback, and status/config API, client signer, per-client throttling and persistent audit logging are not implemented.
- Corrected reset/network-loss semantics: if the one-shot has already started, an MCU reset or Ethernet loss does not necessarily abort its bounded hardware pulse. The controller accepts no new commands and queues none; residual pulse/no-retrigger behavior must be measured on the first article. This replaces the inaccurate blanket claim that a reset immediately makes contacts inactive.
- Verification: source/docs consistency review and `git diff --check`; the host tests and KiCad gates from the preceding milestone remain applicable because no firmware logic or CAD was modified.

# 2026-11-09 — Enable native USB CDC for the custom board

- The board routes ESP32-C3 native USB D+/D- and has no separate USB-UART bridge. Added `ARDUINO_USB_CDC_ON_BOOT=1` to the PlatformIO environment so `Serial` diagnostics and the intended native USB workflow target that connector. Espressif's Arduino-ESP32 guide lists USB CDC on boot for ESP32-C3.
- `hardware/gpio_check.py` now checks that build flag. Four GPIO-check regression cases pass, including a disabled-CDC negative control. Target build/USB enumeration still require the ESP32 toolchain and physical board.

# 2026-11-09 — HMAC-SHA256 pulse-request verification primitive

- Added `firmware/include/request_auth.h` plus canonicalization/tag-parsing and mbedTLS SHA-256 HMAC verification sources. The signature binds method, route, device MAC and sequence in a strict LF-delimited canonical request; key length and signature length are fixed, hex is validated, and digest comparison is constant-time. Documented a cross-language vector in `docs/network-contract.md`.
- C++ tests cover canonical route/device/sequence formatting, invalid inputs, fixed-length digest parsing and constant-time equality. The HMAC verifier passes a known vector through a temporary OpenSSL-backed host shim; the mbedTLS call site also passes a host syntax check against an API-shaped stub. Neither check executes the target mbedTLS binary. The local PlatformIO target toolchain remains unavailable due the low-disk extraction failure.
- No network handler calls this verifier yet; no key provisioning or protected key storage exists. This adds no relay control. Current firmware remains diagnostic-only.

# 2026-11-09 — Sequence reservation ceiling loaded from NVS at boot

- Confirmed the selected local PlatformIO `espressif32@8.0.0` manifest uses Arduino ESP32 package `4.30312.0` / ESP32 libraries `3.3.12`. Added startup loading of `seq_hi` in namespace `facio`, type-checking it as `PT_U64`, and restoring the host-tested reservation window. If namespace open or stored type validation fails, sequence storage reports fail-closed. The sequence write adapter is not implemented yet.
- ESP32 Arduino's official API exposes `Preferences.getULong64` and `getType`. `main.cpp` passes a strict host C++ syntax check against API-shaped stubs; this does not prove the PlatformIO target build or runtime API behavior. The 4 C++ host tests, 4 GPIO tests, static GPIO checker and `git diff --check` pass. Real power-loss/corruption tests remain open.
- This does not add authentication or relay commands. Sequence ceilings are not secret credentials; no NVS encryption, flash encryption or secure-boot provisioning is configured. The initially drafted but unused `putULong64` callback was removed after the host warning check.

# 2026-11-09 — Host-testable anti-replay sequence reservation

- Added `firmware/include/sequence_reservation.h`: an authenticated command sequence is accepted only if strictly newer and the relay guard is clear. Before accepting a sequence beyond the stored ceiling, it persists a 256-value reservation high-water mark; reboot restores that ceiling as the accepted floor, skipping possibly-used numbers and avoiding a flash write for every pulse. Persistence failure and uint64 exhaustion fail closed.
- Added `firmware/test/test_sequence_reservation.cpp` covering block writes, within-block no-write behavior, duplicate/stale/unauthorized/busy requests, reboot skipping, storage failure, and overflow. All three standalone host C++ tests compile with `-Wall -Wextra -Wpedantic -Werror` and pass.
- Updated the network contract, security note, firmware README and roadmap. This is policy only: no HMAC implementation, NVS adapter, transport, relay actuation or ESP32 target build exists yet. `git diff --check` passes.

# 2026-11-09 — Firmware relay-trigger startup made explicitly inactive

- Re-exported netlist confirms `/TRIG1` maps to ESP32-C3 GPIO0 and `/TRIG2` to GPIO1. Firmware now preloads both output latches low, enables the pins as outputs, and keeps them low before SPI or Ethernet initialization. The hardware schematic has 100 kΩ pulldowns on these one-shot inputs; this static update does not prove reset/brownout waveforms or timer behavior on a physical board.
- Extended `hardware/gpio_check.py` to check firmware GPIO assignments, low initialization before network setup and the native USB CDC build flag. It passes: 11 static signal assignments and the startup/config checks. Added 4 `hardware/test_gpio_check.py` regression cases, including wrong-pin, missing-init and disabled-USB negative controls; all pass. All 3 release-gate regression tests also pass; `git diff --check` passes.
- `firmware/src/main.cpp` remains diagnostic-only: no network service, authentication, persistent anti-replay sequence, relay command path, or firmware update flow. ESP32-C3 target compilation and all bench/fault tests remain unverified, so this change does not enable barrier actuation or production use.

# 2026-11-09 — Source BOM parity added to production release gate

- Extended `manufacturing/release_check.py` to compare each production BOM reference and its quantity, value, footprint, manufacturer MPN, supplier C Code and population flag against the authoritative `hardware/bom-draft.csv`. It now rejects missing/invalid C Codes, BOM reference drift and per-field source drift before accepting a package.
- Added `manufacturing/test_release_check.py` with three persistent regression tests. A complete synthetic package passes the structural gate; a changed C1 value and an invalid supplier code both fail. `python3 -m unittest discover -s manufacturing -p 'test_release_check.py' -v` passed all 3 tests; Python syntax validation and `git diff --check` passed.
- Updated `docs/validation.md` to describe the stronger gate. The actual project release remains blocked because the seven approved-release artifacts are absent; the source BOM still has uncoded C1, C2, L1, SW1 and SW2. No production output was created.

# 2026-11-09 — Independent fresh local CAD/release-gate rerun

- Re-ran the installed KiCad CLI 10.0.8 directly against the current source files (not copied DRAFT exports): schematic ERC with all severities and violation exit codes returned **exit 0, 0 violations**; PCB DRC with all severities, zone refill, schematic parity and violation exit codes returned **exit 0, 0 DRC violations, 0 unconnected items and 0 schematic-parity issues**. The CLI emitted host Fontconfig configuration warnings, which did not affect ERC/DRC results.
- Re-ran `python3 manufacturing/release_check.py`: **exit 1**, blocked by the seven absent approved-release files (approval record, archived ERC/DRC/parity reports, production-named Gerber ZIP, BOM and position file). No production package was created from the draft.
- Checked firmware source and contract again: `main.cpp` is still Ethernet/W5500 DHCP diagnostics only and deliberately has no network command server, authentication or relay access. The required production control behavior is therefore not implemented. Host policy/state-machine tests do not substitute for an ESP32-C3 firmware build or first-article tests.
- Available host disk space is 1.8 GiB; PlatformIO's RISC-V build package is not installed in `~/.platformio/packages`. The prior target build failed during toolchain extraction for lack of space; no target binary is available. No user cache was deleted and no toolchain build was repeated.
- **Current disposition: NOT production-ready.** These checks changed no CAD, BOM or manufacturing output files. Remaining external/physical gates include full sourceability and Robotistan acceptance, CAM/stackup approval, module/enclosure fit, independent electrical/safety review, target firmware implementation/build, and first-article electrical/failsafe tests.

# 2026-11-09 — Fresh CAD gate and DRAFT-1.2 package synchronization

- KiCad CLI 10.0.8 netlist export, ERC and PCB DRC with `--refill-zones --schematic-parity` all pass: ERC 0 errors/0 warnings; DRC 0 violations, 0 unconnected pads, 0 parity issues and 0 ignored checks. Refreshed machine-readable reports in `validation-reports/` and DRAFT-1.2.
- Found and corrected a stale DRAFT schematic BOM that listed only 10 grouped rows. Re-exported it directly from the current schematic as 56 unique references. Source, Robotistan draft and assembly BOMs match on all 7 procurement fields across 56 references; schematic BOM matches value/footprint/MPN for all 56; Pick & Place reconciles 56/56 unique references. Added exact LCSC IDs for the CUI input/output terminal blocks (C3816270/C3820511); catalog-code coverage is now 51/56 with 5 rows still uncoded. Robotistan import, stock and assembly remain unverified.
- Replaced the TDK 0603 100 nF/25 V NRND MPN on C3/C8/C30 with active-production C1608X7R1H104K080AA (100 nF/50 V X7R, C72453); C3 value label now correctly states 50 V. Schematic/PCB properties and all BOM/position outputs are synchronized; no nets or footprints changed. TDK notes its recommended alternate is not guaranteed interchangeable, so independent electrical review remains required. Fresh ERC/DRC/parity all pass.
- Re-exported Gerbers with zone refill, PTH/NPTH drills, schematic PDF, assembly PDF and board render from current CAD; rebuilt the flat 14-file Gerber/drill ZIP. Gerbonara 1.6.3 parses all 11 Gerbers and both drill files (181 PTH hits including 4 slots; 6 NPTH hits; 110.10×77.10 mm Edge.Cuts). It still flags `G90` placement in each Excellon file; fabricator CAM confirmation is open. ZIP CRC and `git diff --check` pass.
- Re-ran host C++ policy/state-machine checks and `hardware/gpio_check.py`; both host checks pass, and GPIO checker reports 11 candidate signals without static conflicts. PlatformIO ESP32-C3 build was attempted but failed while unpacking the RISC-V compiler with `No space left on device` (2.0 GiB free remained); no target binary or hardware bring-up is verified.
- `python3 manufacturing/release_check.py` still exits 1 for seven intentionally absent release approval/report/production-package files. This remains an engineering DRAFT, not production-ready. Supplier CAM/assembly acceptance, full sourcing, physical fit, independent review and first-article tests remain open.

# 2026-11-09 — ESP32 antenna keepout placement enforcement

- Enabled footprint-placement checking on the ESP32-C3-WROOM-02's existing four-layer antenna copper keepout in both the board instance and project footprint library. This makes the current 28×11 mm keepout protect against future component placement as well as copper, traces, vias and pads.
- Re-ran local KiCad 10.0.8 against the current project: ERC **exit 0, 0 errors/0 warnings**; PCB DRC with zone refill and schematic parity **exit 0, 0 violations, 0 unconnected pads, 0 footprint errors**. Machine-readable parity report shows 0 violations, unconnected items, parity issues and ignored DRC checks. Refreshed both validation reports and DRAFT-1.2 report copies.
- This is a rule/metadata change; no nets, footprints, copper geometry, board outline, Gerber or drill geometry was changed. DRAFT Gerber/drill ZIP remains the same geometry package.
- Rechecked the actual `Edge.Cuts` geometry instead of the rectangular board bounding box. The antenna cutout runs from x=113 to 143 mm with its local edge at y=112 mm; the 28×11 mm copper/placement keepout is at x=114..142 mm and y=100.9..111.9 mm, outside the board outline. The base PCB is already cut back under the onboard antenna, with 0.1 mm vertical and 1 mm side clearance to that keepout. The previous 2.95 mm-inside-edge conclusion was incorrect and is withdrawn.
- The current ESP32-C3-WROOM-02-N4 layout therefore keeps its onboard antenna beyond the local board edge. Housing clearance still needs confirmation; Espressif recommends 15 mm clearance around the antenna inside the enclosure and RF range/throughput tests when Wi-Fi/BLE is used. The Ethernet control path itself does not rely on that radio. A temporary -02U footprint swap was rejected after its isolated candidate DRC reported silk-edge errors and a footprint/value mismatch; no -02U files or changes were retained.

# 2026-11-09 — Exact supplier-code mapping expanded across BOM

- Extended exact MPN-to-catalog-code checks from resistors to capacitor, diode, MOSFET, buck converter, USB ESD protector, one-shot timer, PTC fuse, relay and ESP32 module items. Added 14 exact MPN/code mappings covering 20 placements beyond the original 9 resistor MPNs, for **41/56 coded placements across 23 exact MPNs**; 15 parts remain without a confirmed supplier code.
- Synchronized only supplier-code/status fields in `hardware/bom-draft.csv`, `manufacturing/DRAFT-2026-11-09-DRAFT-1.2/bom/robotistan-bom-draft.csv` and `.../assembly-bom.csv`. All three have 56 unique references and 37 populated code cells. The new exact MPN/code pairs are recorded in `hardware/component-selection-v1.md`.
- Verified code and MPN consistency across all three BOMs, plus reference/value/footprint/quantity parity. These are catalog identifiers only: current stock, RobotistanPro import, MOQ, THT/SMT assembly acceptance and purchase pricing remain unverified. This does not make the PCBA BOM complete or unblock production.
- No schematic, PCB, Gerber, drill, position or firmware source was changed in this milestone; the prior KiCad 10.0.8/ERC/DRC/parity evidence remains the latest CAD run.
- Final checks for this BOM/documentation-only update: CSV parity assertion **PASS** (56/56 refs and all 7 BOM fields identical across all three files; 41 codes/15 blanks); Pick & Place reference check **PASS** (56/56 unique designators); `git diff --check` **PASS**; DRAFT Gerber/drill ZIP CRC check **PASS**. `python3 manufacturing/release_check.py` exits 1 as intended and reports seven missing release artifacts/approval files.

# 2026-11-09 — Exact LCSC/JLC catalog identifiers added for resistor BOM

- Mapped nine supplier part codes to the exact YAGEO MPNs used by 21 resistor placements: C98220, C105580, C107701, C114633, C14675, C482916, C22548, C105578 and C185324. The first eight were checked against exact LCSC product records; C185324 was checked against the exact YAGEO MPN in the JLCPCB catalog. Electrical values, 0603 packages and 1% specifications match the design BOM. A subsequent milestone expanded the total to 37 coded placements.
- Updated only supplier code and sourcing-status cells in `hardware/bom-draft.csv`, `manufacturing/DRAFT-2026-11-09-DRAFT-1.2/bom/robotistan-bom-draft.csv` and `manufacturing/DRAFT-2026-11-09-DRAFT-1.2/bom/assembly-bom.csv`. At that milestone, 21/56 rows had identifiers; the later update above covers 37/56. These identifiers do not establish stock, MOQ, Robotistan import or PCBA acceptance.
- Robotistan's live PCB-service description lists BOM and Pick & Place for PCBA and includes the C-code as a purchasing field. The draft package remains non-production; no upload or order was made.
- Subsequent exact catalog lookup found Littelfuse `1812L075/33DR` as LCSC C151170 and added that code for F1 to all three BOMs. This raises coverage to 38/56; no Robotistan stock/import/assembly acceptance is implied.
- Follow-up exact catalog lookups found Omron `G6K-2P-Y DC12` C132367 and Espressif `ESP32-C3-WROOM-02-N4` C2934560, then synchronized K1/K2/U2 in all three BOMs. Coverage is now 41/56; Robotistan import and current procurement status remain unconfirmed.

# 2026-11-09 — Robotistan BOM metadata integrity correction

- Audited the DRAFT-1.2 Robotistan BOM against `hardware/bom-draft.csv`. All 56 references, MPNs, values, footprints, quantities, populate flags and supplier-code cells already matched; however, 51 `Status` cells incorrectly repeated F1's PTC note. Replaced only those notes with the matching source-BOM status values and verified 56/56 exact status matches; no part selection or purchasing code was changed.
- At that point in the audit, all 56 RobotistanPro/LCSC C-code fields were blank; a subsequent entry above maps 21 resistor placements. ZIP integrity remains good and `git diff --check` passes.
- Robotistan's current PCB service page requires Gerber plus BOM/Pick & Place for PCBA and lists its C-code field as a purchasing identifier. This draft still lacks codes for 35 rows and stock/assembly/THT acceptance; no files were uploaded or ordered.

# 2026-11-09 — DRAFT-1.2 fresh CAM parser and KiCad gate recheck

- Re-ran the installed KiCad 10.0.8 ERC and PCB DRC on the integrated source. ERC: exit 0, 0 violations. PCB DRC with zone refill and schematic parity: exit 0, 0 violations, 0 unconnected items, 0 parity issues, 0 ignored checks. Refreshed `validation-reports/schematic-erc.txt`, `validation-reports/pcb-drc.txt`, `validation-reports/pcb-drc-parity.json` and the corresponding DRAFT-1.2 report copies.
- Installed Gerbonara 1.6.3 in an isolated `uv run` environment and parsed the fresh DRAFT-1.2 files: all 11 Gerber layers and both Excellon files parse; Edge.Cuts is 110.10 × 77.10 mm; PTH contains 181 hits including 4 routed slots; NPTH contains 6 hits. Gerbonara warns on `G90` after `%` because its parser treats G90 as header-only. The Excellon CNC-7 specification describes G90 as absolute mode (the default) and JLCPCB's published example also puts it after `%`; the KiCad drill files were not modified. Refreshed `validation-reports/gerber-parse-draft-1.2.txt` and the DRAFT report. Fabricator CAM still must accept drill interpretation and tool/slot mapping.
- Cost-down check: the integrated source still has four copper layers (`F.Cu`, `In1.Cu`, `In2.Cu`, `B.Cu`). No two-layer reroute candidate was produced or checked; no local Freerouting executable is installed. Do not order the current 4-layer package as a 2-layer board or assume two-layer pricing.
- `python3 manufacturing/release_check.py` remains exit 1 as designed: `release/APPROVED.txt`, release ERC/DRC/parity reports, production Gerber ZIP, production BOM and production position CSV are absent. This DRAFT package is not approved for manufacture. Supplier sourcing/CAM, physical fit, independent design review and first-article electrical/thermal/fail-safe tests remain release blockers.

# 2026-11-09 — DRAFT-1.2 hot-input PTC candidate and synchronized outputs

- Replaced F1 from Littelfuse `1812L050/30PR` with `1812L075/33DR`, keeping the same 1812 land pattern and changing no electrical nets or copper. The manufacturer datasheet lists 0.75 A hold, 1.5 A trip, 33 V maximum and a reference-only 85°C derating-table value of 0.36 A (vs. 0.29 A for the prior 0.50 A part). Against the existing 0.249 A illustrative input estimate, that is 111 mA of table-based headroom, not a guaranteed operating margin. Actual input/load/ambient, local PTC temperature, fault coordination and manufacturer confirmation are still open.
- Bumped schematic/PCB to DRAFT-1.2 and synchronized source BOM, Robotistan BOM draft, schematic BOM and position value fields. Regenerated the 11 Gerbers and two Excellon files from KiCad 10.0.8; normalized geometry payloads match DRAFT-1.1 exactly after excluding revision/date metadata. Regenerated schematic PDF, fresh ERC/DRC/parity reports and a 14-member Gerber/drill ZIP. ZIP CRC passes. Gerbonara 1.6.3 independently parsed the current package in the follow-up recorded above; both drill files show the unresolved `G90`-after-header warning.
- KiCad 10.0.8 ERC exit 0; DRC with zone refill and schematic parity exit 0 (0 violations, 0 unconnected items, 0 parity issues, 0 ignored checks). Fresh netlist export succeeds; all 56 board BOM MPNs match both schematic and PCB fields, and BOM/position references reconcile 56/56 uniquely. At this checkpoint all RobotistanPro/LCSC codes were blank; the follow-up entry above adds codes for 21 resistor placements. Production approval remains blocked.

# 2026-11-09 — relay command model aligned to the fixed hardware one-shot

- Found a safety-contract mismatch: the host helpers and proposed API accepted configurable 100–1000 ms durations, while the populated PCB has a fixed LTC6993-1 one-shot of about 503 ms nominal. Removed the variable duration from the host policy and proposed network contract; commands now use a strictly increasing sequence and cannot request a longer pulse. The contract also serializes OPEN/CLOSE commands through one shared 600 ms guard.
- Consolidated the orphaned/duplicated host controller experiments by removing both volatile replay-cache controller implementations. Added a pure `CommandPolicy` that requires authenticated input and a caller-supplied durable sequence watermark, plus a 600 ms software re-arm guard. These are host-only helpers, not wired to Ethernet or GPIO; durable persistence/authentication and scope verification remain open.
- Replaced the old helper tests with two focused host tests covering monotonic replay rejection, auth/busy decisions, fixed re-arm timing and `millis()` rollover. Both compile with `-std=c++17 -Wall -Wextra -Wpedantic` and pass.
- Updated `README.md`, `docs/requirements.md`, `docs/network-contract.md`, `docs/firmware-interface.md`, `firmware/README.md` and `firmware/SECURITY.md` so none implies that firmware can choose the contact pulse duration or that the pure helpers are production controls. `git diff --check` passes.
- This does not change the PCB/Gerber geometry and does not close production readiness: the target firmware is not built, command security is not implemented, and first-article pulse measurements remain required.

# 2026-11-09 — DRAFT-1.1 KiCad gate recheck and Ethernet diagnostic firmware

- Re-ran installed KiCad 10.0.8 on the current integrated CAD: schematic ERC exit 0 (0 violations); PCB DRC with zone refill and schematic parity exit 0 (0 violations, 0 unconnected, 0 parity issues, 0 ignored checks). Refreshed `validation-reports/schematic-erc.txt` and `validation-reports/pcb-drc-parity.json`. `git diff --check` passes.
- Re-ran all four host C++ tests with `-std=c++17 -Wall -Wextra -Wpedantic`; all pass. PlatformIO resolved and installed `arduino-libraries/Ethernet@2.0.2`.
- Replaced the serial-only firmware with WIZ850io/W5500 diagnostics: explicit schematic SPI/reset pins, active-low reset plus the manufacturer-required post-reset wait, unique locally administered MAC derived from the ESP32-C3 factory MAC, DHCP acquisition/renewal/retry, W5500 detection, cable/IP reporting. `firmware/platformio.ini` now pins the tested PlatformIO platform and Ethernet library versions.
- **Not verified:** the ESP32-C3 target binary could not be built after the previous PlatformIO attempt exhausted disk while extracting the RISC-V compiler. No W5500 board has been attached, so link/DHCP behavior is not hardware-verified. The firmware intentionally has no command server and no relay GPIO actuation; authentication, provisioning, relay integration and signed update remain unimplemented.
- Production release gate still fails intentionally: approval, release-named reports, production Gerber ZIP/BOM/position files, supplier CAM/assembly acceptance, sourcing, independent review and first-article measurements are absent. DRAFT-1.1 is not approved for fabrication.

# 2026-11-09 — DRAFT-1.1 exact connector footprint rules

- Found five project connector footprint-filter mismatches hidden by the previous global `ignore` setting: J1/J4/J5 terminal blocks and J6/J7 WIZ850io sockets. Added three project-local connector symbols with exact footprint filters in `hardware/fac_io.kicad_sym`, pointed the schematic instances at them, and changed KiCad's filter-mismatch severity to `warning`. This leaves KiCad's stock symbol library untouched. A disposable candidate and then the integrated source both passed ERC/DRC/parity; final source DRC reports 0 violations, 0 unconnected pads, 0 footprint errors, 0 parity issues and no ignored DRC checks. ERC has 0 errors/warnings. Netlist export succeeds, and comparison shows all 60 component refs/values/footprints/fields and pin-to-net mappings unchanged.
- Generated `manufacturing/DRAFT-2026-11-09-DRAFT-1.1/` from DRAFT-1.1 CAD. Gerbonara 1.6.3 parsed 11 Gerbers and 2 drill files: 110.10×77.10 mm Edge.Cuts, 181 plated drill objects including 4 slots, 6 NPTH. Gerber/drill ZIP integrity passes. BOM and PnP were carried forward after proving the schematic netlist and PCB placement were unchanged; both still have matching 56-reference sets and all MPNs filled. The two Excellon `G90`-after-header warnings remain and require CAM acceptance.
- Checked the ADI LTC6993-1 datasheet behavior against the current pulse-limiter circuit: the chosen resistor divider yields DIVCODE 5 within the datasheet's ratio/impedance limits, and the datasheet documents OUT-low/trigger-ignore behavior during POR startup with POL=0. Recorded this component-level evidence in `hardware/component-selection-v1.md`; board reset/brownout and relay-contact behavior remain first-article scope tests.
- Saved KiCad's machine-readable DRC result as `validation-reports/pcb-drc-parity.json` and in DRAFT-1.1. It records empty violations, unconnected, schematic-parity and ignored-check arrays. Extended `release_check.py` to require those arrays, reject nonempty/invalid results and check report version. A temporary valid release fixture passes; a parity-error fixture fails. The real release run remains blocked for absent production approval/reports/exports; no production release was created.
- Firmware audit: `firmware/src/main.cpp` is still heartbeat-only; four host-built C++ policy/timing tests pass. Attempted `pio run` for `fac_io_c3` with PlatformIO 6.1.18 / espressif32 8.0.0; install failed while unpacking `toolchain-riscv32-esp` with `[Errno 28] No space left on device`. No ESP32-C3 target build, W5500 integration, authenticated network control or relay actuation is verified. Updated README/roadmap to make this incomplete scope explicit.
- The improvement only removes a KiCad rule blind spot; it does not resolve the manufacturing blockers. Production remains NOT READY pending real input/ambient/load and thermal closure, supplier codes/stock and Robotistan acceptance, physical module/socket/enclosure fit, independent review, DS-TMG420 terminal confirmation and first-article measurements.

# 2026-11-09 — DRAFT-1.0 protected input copper width

- Final local gate recheck: KiCad 10.0.8 ERC was rerun on the source schematic at 16:54 UTC (exit 0, 0 errors/warnings); PCB DRC was rerun with zone refill and schematic parity (exit 0, 0 violations, 0 unconnected pads, 0 parity issues). Refreshed `validation-reports/` and the DRAFT-1.0 report copies from these fresh runs. A drill-export trial with `--excellon-min-header` still emits `G90` after `%`, so it does not resolve Gerbonara's warning; the existing DRAFT drill files were left unchanged. Production release remains blocked by the physical, electrical, sourcing, independent review and supplier acceptance gates below.
- Reconciled DRAFT-1.0 BOM and Pick & Place: both have 56 unique references and identical reference sets; all 56 manufacturer MPNs are populated, but all 56 RobotistanPro/LCSC supplier codes are blank. Rechecked the 13-member Gerber/drill ZIP: integrity passes and its 11 Gerber plus 2 drill files byte-match the loose DRAFT exports. This verifies package synchronization, not supplier CAM acceptance.
- Hardened `manufacturing/release_check.py`: when a release package exists, the gate now checks clean ERC/DRC report content, required Gerber/drill members and ZIP integrity, populated unique BOM/position references with matching sets, populated MPNs, and a non-draft approval revision with explicit reviewer/date/pass fields. Current run remains exit 1 because all six release artifacts are absent, as intended. This does not substitute for independent/supplier sign-off.

- Widened the seven routed `/12V_IN` and `/12V_FUSED` segments from 0.20 mm to 0.45 mm between J1, F1 and D1. Added a project DRC rule enforcing a 0.45 mm minimum on these protected-input segments. This improves copper cross-section at the input/protection path; it does not prove short-circuit coordination or replace the fuse/thermal review.
- Isolated candidate with the rule and widened traces passed KiCad DRC and schematic parity with 0 violations/unconnected items. Negative-control DRC on the original 0.20 mm geometry flagged all seven undersized segments; evidence is in `validation-reports/pcb-drc-width-negative-control.txt` and the DRAFT-1.0 report bundle. Applied the 0.45 mm change to the source board at revision DRAFT-1.0; local KiCad 10.0.8 ERC passed with 0 errors/warnings, source DRC with zone refill/parity passed with 0 violations/unconnected pads/parity issues. Refreshed the source reports.
- Generated `manufacturing/DRAFT-2026-11-09-DRAFT-1.0/` from DRAFT-1.0 CAD: 11 Gerbers, separate PTH/NPTH Excellon, BOM/positions, schematic PDF, assembly PDF, 3D board render and ZIP. Gerbonara 1.6.3 parsed all files: 110.10×77.10 mm outline, 181 PTH objects including 4 routed slots, 6 NPTH. ZIP integrity passes. The same non-fatal Excellon `G90` placement warnings remain; supplier CAM acceptance is open.
- Assembly drawing was visually reviewed and regenerated at 2:1 on A4 using F.Fab, Edge.Cuts and Dwgs.User, with values excluded. This makes reference designators and the external WIZ850io module outline readable; it remains an internal assembly drawing, not an independent review.
- Production remains NOT READY: the actual 12 V source/ambient envelope and PTC/buck hot margin are unconfirmed; all 56 RobotistanPro/LCSC codes and component stock are unresolved; module/enclosure fit, independent electrical/CAM review, supplier stackup/assembly acceptance and first-article tests are open. `release_check.py` must remain blocked.

# 2026-11-09 — DRAFT-0.9 connector courtyard and module envelope

- Follow-up verification: `hardware/gpio_check.py` exits 0 (11 candidate signal assignments, no static pin conflicts); its own output correctly leaves reset behavior/module pin availability and relay startup levels as bench-unverified. Refreshed KiCad 10.0.8 netlist, ERC and DRC/parity reports after source cleanup: netlist export exit 0, ERC exit 0 with 0 errors/warnings, DRC exit 0 with 0 violations/unconnected pads/parity errors. Current reports are copied into the DRAFT-0.9 package. `git diff --check` and the DRAFT Gerber/drill ZIP integrity check pass.
- Independent Gerbonara SVG previews were generated and visually scanned for F.Cu, B.Cu, In1.Cu, In2.Cu, F.Silkscreen and Edge.Cuts. No obvious missing board outline or broken layer geometry was observed. This is an internal visual sanity check only; it does not constitute independent CAM approval or supplier acceptance. The Excellon `G90` warnings remain unresolved pending fabricator interpretation.
- DRAFT BOM/PnP reconciliation: 56/56 unique designators match; all 56 rows have manufacturer MPNs, while all 56 RobotistanPro/LCSC stock codes remain blank. Re-ran `python3 manufacturing/release_check.py`: exit 1, correctly blocked for absent approval marker and production-named reports/Gerber ZIP/BOM/position files. GPIO static validation is not hardware reset/fail-safe validation. Supplier sourcing/assembly, 12 V and effective-capacitance margin, physical WIZ850io/socket/enclosure fit, independent design review, Robotistan CAM/assembly acceptance and all first-article electrical tests remain open.
- TDK manufacturer's data was checked for the two protected-input MLCC candidates: nominal values/ratings are confirmed, but TDK labels characteristic curves reference-only, so they do not provide a guaranteed minimum combined capacitance at operating DC bias and temperature. Documented this limitation in `hardware/component-selection-v1.md`; input-capacitance margin remains open, not signed off.
- First-order rail/current screen added to `hardware/component-selection-v1.md`: provisional 0.641 A 3.3 V allocation (ESP32 supply recommendation + WIZ850io typical 100 Mb/s TX) is not a measured worst-case. At 85% illustrative buck efficiency, two nominal relay coils and 10.8 V source, estimated input is about 0.25 A before minor loads; the F1 PTC derates to 0.29 A at 85°C, leaving only about 0.04 A in this simplified estimate. U1 loss is about 0.38 W and reference θJA implies ~34°C rise; actual board thermal performance/efficiency is unverified. Supply range, simultaneous actual current and hot thermal margin are therefore still open; no fuse/regulator change was made from assumptions alone.

- Replaced the two local WIZ850io socket footprints' duplicated 23×25 mm F.Fab module boxes with standard 1×6 socket body/silk/Fab/courtyard geometry. Added one non-fabrication `Dwgs.User` outline for the external WIZ850io module (23×25 mm) based on its published mechanical dimensions. This helps assembly-courtyard checks; actual mating, height and enclosure clearance still require physical samples.
- Updated KiCad project DRC severity from `ignore` to `warning` for missing courtyard, footprint-type mismatch, track-to-via centering and tuning-profile geometry. No such issues were found. The generic connector symbol/footprint-filter mismatch remains explicitly ignored because the selected terminal blocks and WIZ850io sockets use valid manufacturer-specific packages; reports show that one ignored DRC category.
- Re-generated the DRAFT-0.9 Gerber, Excellon, BOM, SMD position, schematic PDF, assembly-top PDF, 3D board render and ZIP. Gerbonara 1.6.3 parsed 11 Gerbers and 2 Excellon files: 110.10×77.10 mm outline, 181 PTH hits including 4 routed slots, 6 NPTH. Its two non-fatal `G90` placement warnings remain open. ZIP integrity passes.
- Re-ran local KiCad 10.0.8: netlist export exit 0; ERC exit 0 with 0 errors/warnings; DRC with zone refill and schematic parity exit 0 with 0 violations, 0 unconnected pads and 0 footprint errors. The DRC report's single ignored filter-mismatch category is retained in the report. `git diff --check` passes after footprint formatting cleanup.
- **Production remains NOT READY.** `manufacturing/release_check.py` must stay blocked: no approved release marker, supplier acceptance, verified Robotistan purchase codes/assembly, independent CAM/electrical review, physical WIZ850io/enclosure fit or first-article measurements.

# 2026-11-09 — DRAFT-0.8 D2 TVS polarity semantics

- Corrected D2 from the generic bidirectional `Device:D_TVS` symbol to `Device:D_Zener`, which matches the unidirectional `SMCJ15A` MPN. KiCad netlist now explicitly reports D2 pin 1/K on `/12V_PROT` and pin 2/A on `/GND`; PCB pad 1 remains on `/12V_PROT`, pad 2 on `/GND`. The board layout/connectivity is unchanged by this schematic-only correction.
- Re-ran KiCad 10.0.8: schematic netlist export succeeded; ERC exit 0, 0 errors/warnings; PCB DRC with zone refill and schematic parity exit 0, 0 violations, 0 unconnected pads, 0 footprint/parity errors. Reports are refreshed in `validation-reports/`.
- Created `manufacturing/DRAFT-2026-11-09-DRAFT-0.8/` from the unchanged DRAFT-0.7 PCB outputs, refreshed the schematic PDF and checks, and recorded the CAD-only revision note. Gerber geometry is unchanged because no PCB geometry or net assignment changed.
- Production remains NOT READY. DRAFT outputs are not fabrication authorization; 12 V range/clamp/effective capacitance, assembly sourcing, supplier CAM/stackup acceptance, physical fit, independent review and first-article tests remain open.

# 2026-11-09 — DRAFT-0.7 protected-rail capacitor bank and synchronized outputs

- Replaced the two derated Murata 10 µF/25 V/0805 input capacitors with TDK C1 `C3225X7R1H226M250AC` (22 µF/50 V/1210) and C2 `CGA5L1X7R1H106K160AC` (10 µF/50 V/1206). Moved C2 beside AP63203 VIN and rerouted the local input/GND paths; C1 remains the nearby bulk capacitor. The change addresses the inadequate confidence in nominal 20 µF on the original 0805 pair. Effective capacitance at the actual input/transient/temperature/tolerance corners is still not proven; the candidate MPNs and 1210/1206 package specs are recorded in `hardware/component-selection-v1.md` and `hardware/bom-draft.csv`.
- Adopted the tested candidate into `hardware/FAC-IO-Mini-V1.kicad_sch` and `.kicad_pcb`, revision DRAFT-0.7. Installed KiCad 10.0.8: ERC exit 0 (0 errors/warnings); DRC with zone refill and schematic parity exit 0 (0 violations, 0 unconnected items, 0 footprint errors/parity issues). Refreshed `validation-reports/schematic-erc.txt` and `validation-reports/pcb-drc.txt`.
- Regenerated the DRAFT-0.7 Gerber/drill bundle, schematic PDF, top render, drill report, CAD BOM, Robotistan-format BOM and Pick & Place. Gerbonara 1.6.3 parsed 11 Gerbers and 2 Excellon files; outline is 110.10 × 77.10 mm, plated hits total 181 (4 slots), NPTH 6. ZIP passes `unzip -t`. Gerbonara still warns that `G90` follows the Excellon header terminator; CAM acceptance is open.
- BOM and PnP contain the same 56 unique references; all manufacturer MPN fields are filled, all 56 RobotistanPro/LCSC supplier codes remain blank. The output directory and ZIP are explicitly DRAFT.
- **Production remains NOT READY.** Still required: worst-case MLCC effective-capacitance and 12 V transient/clamp calculation; supplier sourcing/assembly and Robotistan stackup/CAM acceptance; physical WIZ850io/enclosure fit; independent electrical/CAM review; first-article power, thermal, reset/brownout, relay pulse/contact and Ethernet tests. `python3 manufacturing/release_check.py` must remain blocked; do not create the approval marker until these gates have evidence.

# 2026-11-09 final CAD gate recheck — DRAFT-0.6

- Re-ran local KiCad 10.0.8 on the current source CAD after the final whitespace-only cleanup: schematic ERC exit 0 (0 violations); PCB DRC with zone refill and schematic parity exit 0 (0 physical violations, 0 unconnected items, 0 parity issues). Refreshed `validation-reports/schematic-erc.txt`, `validation-reports/pcb-drc.txt`, and the matching DRAFT-0.6 report copies.
- DRAFT-0.6 Gerber/Drill ZIP passes `unzip -t`. The draft assembly BOM and Robotistan PnP each have 56 unique references with identical sets and no duplicates; all manufacturer MPNs are filled, all 56 RobotistanPro/LCSC C-code fields are blank. `hardware/gpio_check.py` passes its static signal-map check; it explicitly does not verify reset/startup behavior.
- `git diff --check` passes. `python3 manufacturing/release_check.py` exits 1 because no approved release marker, release-named reports, production Gerber ZIP, BOM or PnP exist. The manufacturing outputs remain **DRAFT**.
- **Production remains NOT READY.** Remaining gates are effective input-capacitance/protected-rail transient calculation and review; Robotistan CAM/stackup/assembly and component-sourcing acceptance (including Excellon G90 interpretation); independent electrical/mechanical review and physical WIZ850io/enclosure fit; and first-article startup, brownout, relay pulse/contact, supply/thermal and Ethernet measurements. CAD ERC/DRC and file parsing do not prove those gates.

# 2026-11-09 continuation — DRAFT-0.6 fabrication bundle and CAM parse

- Generated the synchronized DRAFT-0.6 output set under `manufacturing/DRAFT-2026-11-09-DRAFT-0.6/`: 11 Gerbers, separate PTH/NPTH Excellon, drill report, ERC/DRC, assembly drawing, schematic PDF, 3D board render, BOM and positions. The Gerber/drill ZIP passes `unzip -t`; both PDFs and the 3D render were generated from current source CAD.
- Parsed all 11 Gerbers and 2 Excellon files with Gerbonara 1.6.3. Outline is 110.1 × 77.1 mm; 181 plated hits (including 4 slots) and 6 NPTH. The parser accepts all files but warns that `G90` follows the Excellon `%` header terminator in both drill files; leave this for Robotistan CAM confirmation. Empty backside paste/silkscreen is consistent with the current top-side-only population. Parser report: `manufacturing/DRAFT-2026-11-09-DRAFT-0.6/reports/gerber-parse.txt`.
- Verified the latest Robotistan Pick & Place example file schema (Designator, Mid X, Mid Y, Layer, Rotation). Converted current KiCad placements to positive board-local coordinates using the DRAFT-0.6 Edge.Cuts origin and rebuilt the supplier-format CSV. BOM/PnP each contain 56 unique references and the sets match; all 56 manufacturer MPNs are present, but all RobotistanPro/LCSC C-code fields are blank, so PCBA sourcing/quote is not complete. Supplier confirmation of coordinate-origin convention remains required.
- KiCad 10.0.8 source checks remain ERC exit 0 (0 errors/warnings), DRC with zone refill and schematic parity exit 0 (0 violations, unconnected pads or parity issues). `git diff --check` was cleaned and re-run.
- `python3 manufacturing/release_check.py` exits 1 as designed: release approval, release-named reports, Gerber ZIP, production BOM and production PnP are absent. The files remain DRAFT. No Robotistan order or file upload was made.
- **Production status: NOT READY.** Remaining gates include AP63203 protected-rail transient/effective-input-capacitance closure, supplier component codes and THT/SMT capability, Robotistan CAM/stackup acceptance (including Excellon G90 handling), independent electrical/mechanical review and WIZ850io/enclosure physical fit, and first-article fault/power/timing/relay/network measurements.

# 2026-11-09 continuation — buck bootstrap loop relocation / DRAFT-0.6

- On an isolated project copy, moved C3 (100 nF BST-to-SW) from the remote lower position to immediately beside U1, rotated the 0603 body, removed both old net routes/vias and rebuilt BST/SW with three short front-copper segments. C3-to-U1 routes are approximately 2.0 mm (BST) and 1.9 mm (SW), with no vias in this loop.
- Adopted only after the candidate passed installed KiCad 10.0.8 PCB DRC with zone refill and schematic parity: exit 0, 0 violations, 0 unconnected pads, 0 footprint errors, 0 parity issues. Main source repeated the same gate: DRC exit 0. Schematic ERC remains exit 0, 0 errors/warnings. Reports refreshed in `validation-reports/`.
- Bumped schematic/PCB CAD revision to DRAFT-0.6 to keep output revision identity aligned. No electrical part/value/net change. Old DRAFT-0.5 manufacturing exports are stale for this board geometry; a synchronized DRAFT-0.6 export set is being regenerated.
- This closes one local buck-layout issue; it does not establish buck-loop EMI, ripple, transient margin, assembly fit or thermal performance. Production remains **NOT READY** pending input capacitor / protected-rail transient closure, exact procurable BOM + supplier acceptance, WIZ850io/enclosure mating, independent electrical/CAM review and first-article measurements.

# 2026-11-09 continuation — cost-down feasibility and BOM sync

- Benchmarked against Nöron's published product list: Ethernet, one relay, one input, RS232 and 12 V. FAC-IO keeps the required two isolated OPEN/CLOSE relays; an input and RS232 are not in V1 scope. Robotistan's live PCB service page still lists minimum 5 pieces and a four-layer option.
- Evaluated a lower-cost two-layer conversion of the existing routed four-layer CAD in isolated copies. Re-serialized four-layer baseline stayed clean (0 DRC, 0 unconnected, 0 parity). Simple inner-layer-to-outer-layer assignments failed: best mapping had 76 violations and 4 unconnected; the other had 174 violations and 15 unconnected. No conversion was adopted; a genuine two-layer redesign needs complete rerouting and cannot be treated as a quote-form option.
- Replaced stale 15-row `hardware/bom-draft.csv` (which still listed bare W5500/RJ45 placeholders) with the current DRAFT-0.5 56-reference assembly BOM. All 56 board references have manufacturer MPNs; all 56 RobotistanPro/LCSC C-code cells remain blank, so PCBA sourcing/assembly is not ready.
- A follow-up trial changing both protected-rail capacitors to TDK 10 µF/50 V/1206 on an isolated copy had 3 physical DRC errors (a C2 trace short, courtyard overlap with C3 and solder-mask bridge) plus silkscreen warnings. It was rejected and no main CAD or Gerbers were changed.
- Final source check on the unchanged DRAFT-0.5 CAD: KiCad 10.0.8 ERC exit 0 (0 errors/warnings), DRC with zone refill and schematic parity exit 0 (0 violations/unconnected pads/footprint errors/parity errors). Refreshed `validation-reports/schematic-erc.txt` and `validation-reports/pcb-drc.txt`; the Gerber/drill ZIP passes `unzip -t`. The 56 BOM refs match 56 Pick & Place refs, with no duplicates; PCBA source-code fields are all blank. `release_check.py` exits 1 as intended because release approval and production-named files/reports are absent; `git diff --check` passes.
- Current CAD architecture remains the four-layer ESP32-C3 + plug-in WIZ850io carrier, two isolated relay channels. Existing DRAFT-0.5 Gerbers remain unapproved. Next: settle cost against the actual quote and supplier BOM feasibility, close protection/input-capacitor and physical fit review, then finish independent CAM/electrical review and first-article tests before any release.

# 2026-11-09 continuation — refreshed CAD gate and input-capacitor trial

- Re-ran the installed KiCad 10.0.8 against the current source: schematic ERC exit 0 (0 errors, 0 warnings); PCB DRC with zone refill and schematic parity exit 0 (0 violations, 0 unconnected pads, 0 footprint errors, 0 parity errors). The source board/schematic remain unchanged by the capacitor trial.
- Corrected the earlier AP63203-EVB reference: Diodes' official guide lists a generic 10 µF, X5R/X7R, 1206, **35 V** input capacitor, not a 50 V TDK part. The official AP63203 datasheet says a ceramic capacitor greater than 10 µF is sufficient for most applications. The TDK CGA5L1X7R1H106K160AC remains only a separate 10 µF/50 V/1206 candidate, not the EVB BOM part.
- A rotated C1 1206/50 V trial on an isolated board copy produced 10 DRC warnings (one library-footprint mismatch and nine silkscreen clearance/clipping warnings), with 0 unconnected pads and 0 schematic-parity issues. It was not adopted. Current C1/C2 remain 10 µF/25 V/0805 on `12V_PROT`, protected by the SMCJ15A candidate; actual rail transient envelope and effective capacitance are still unverified.
- Current production package remains **NOT READY**. Next: close the protection/input-capacitor voltage and effective-capacitance analysis, then complete independent electrical/layout review, supplier CAM/stackup and assembly acceptance, physical WIZ850io/enclosure verification, and first-article fail-safe/power/network measurements.

# 2026-11-09 continuation — In2 GND reference plane / DRAFT-0.5

- Added a KiCad-native GND copper zone on In2.Cu to the current four-layer PCB, preserving the actual Edge.Cuts outline and the ESP32-C3 antenna cutout. Refilled area is about 7,271 mm² as one connected polygon; 55 existing GND vias are available to tie the plane to the other layers. This improves return-path copper but is not an EMC or stackup approval.
- Installed KiCad 10.0.8 schematic ERC: exit 0, 0 errors/0 warnings. PCB DRC with zone refill and schematic parity: exit 0, 0 violations, 0 unconnected pads, 0 footprint errors, 0 parity errors. Current reports: `validation-reports/schematic-erc.txt`, `validation-reports/pcb-drc.txt`.
- Bumped schematic/PCB title-block revision to DRAFT-0.5 and refreshed `manufacturing/DRAFT-2026-11-09-DRAFT-0.5/`: all 11 Gerbers, PTH/NPTH drill, 14-file ZIP, DRC/ERC reports, independent parser report, schematic PDF and 3D board render. ZIP integrity passes.
- Gerbonara independently parsed all 11 Gerber layers and both Excellon files. Board outline is 110.1 × 77.1 mm; plated drill report has 183 hits including 4 slots; NPTH has 6 hits. Gerbonara still warns that each Excellon file places `G90` after its header; parsing completes, but Robotistan CAM must confirm acceptance.
- `git diff --check` passes. Production remains **NOT READY**: no independent visual/CAM acceptance, Robotistan stackup/DFM/THT and sourcing approval, physical WIZ850io/enclosure mating check, independent electrical review or first-article measurements. `release_check.py` must remain blocked; no approval marker or production-named package was fabricated.

# 2026-11-09 continuation — input-capacitor margin audit

- Re-ran installed KiCad 10.0.8 against the current source files: schematic ERC exit 0 (0 errors/0 warnings); PCB DRC + schematic parity exit 0 (0 violations, 0 unconnected pads, 0 footprint errors, 0 parity errors). Reports refreshed at `validation-reports/schematic-erc.txt` and `validation-reports/pcb-drc.txt`.
- Audited C1/C2 on `12V_PROT`: both remain Murata 10 µF/25 V/0805 (`GRM21BZ71E106KE15L`). Diodes Incorporated's AP63203 evaluation-board guide lists a generic 10 µF, 35 V, 1206 X5R/X7R input capacitor; the manufacturer datasheet says >10 µF ceramic is sufficient for most applications. The TDK `CGA5L1X7R1H106K160AC` is a separate 10 µF/50 V/X7R/1206 candidate, not the EVB part. Neither source by itself establishes the correct board BOM or proves a footprint fits/routs cleanly.
- A rotated C1 1206 trial on an isolated copy produced shorts/clearance/courtyard failures in the first placement, then 10 DRC warnings (library-footprint mismatch and silkscreen clearance/clipping) in the follow-up routed placement. Both trials were rejected; the main schematic/PCB and DRAFT exports were not changed.
- **Open electrical decision:** establish the real protected-rail transient envelope and effective MLCC capacitance at voltage/temperature, then re-place/re-route the buck input capacitor bank as one reviewed layout change and rerun DRC. Do not order the current board based only on a nominal 25 V rating.
- Production gate remains **NOT READY**. The real source ERC/DRC pass is CAD evidence only. `python3 manufacturing/release_check.py` exits 1 because approved release marker/reports and production-named Gerber/BOM/PnP files are absent. Independent CAM/mechanical review, Robotistan project acceptance, assembly and first-article measurements remain external/uncompleted gates.

# 2026-11-09 continuation — Robotistan quote / layer-cost audit

- User reports a Robotistan quote of USD 135. Robotistan's current PCB service page states a 5-board standard minimum. If USD 135 is the total for five bare boards, that is USD 27 per board; confirm the quote's quantity and whether assembly/stencil are enabled before treating this as unit cost.
- Current outline is 110.1 × 77.1 mm and the board is 4-layer. KiCad board inspection counts 91 In1.Cu segments, 49 In2.Cu segments and 127 vias; the only copper zones are two GND zones on F.Cu. Therefore selecting 2-layer in the quote form would not match these Gerbers. A 2-layer cost-down requires a full reroute and a new return-path/EMC review; it is not a safe manufacturing-option toggle.
- The linked Nöron page lists Ethernet, one NC/NO relay, one input, RS232 and 12 V but does not publish a current price. Neutron's 2023 price list gives USD 280 excluding VAT for a 4-input/4-output TCP/IP I/O card; it is a different version and an old list, so it is not a direct current price comparison.
- The current draft order bundle remains unsubmitted. The existing Gerber ZIP integrity check passes, but CAM acceptance and release approval remain open.

# 2026-11-09 checkpoint — full MPN BOM and refreshed CAD checks

- Current CAD revision: DRAFT-0.4 in `hardware/FAC-IO-Mini-V1.kicad_sch` and `.kicad_pcb`; installed KiCad CLI 10.0.8.
- Added E-Switch `TL3342F100QG` for SW1/SW2 (same TL3342 land pattern, 100 gf, manufacturer-listed 1M cycle life). Its distributor lead time/MOQ and Robotistan sourcing still require confirmation.
- C2 is now the same Murata 10 µF/25 V 0805 part as C1; both are parallel at `12V_PROT` for 20 µF nominal total. Manufacturer DC-bias/temperature/tolerance data and first-article rail/ripple measurement still need confirmation.
- Corrected C9's displayed/BOM value from the purchasing code to `1nF/2kV`; its MPN remains `C1206C102KGRACTU`.
- CAD BOM: 56/56 populated refs carry manufacturer MPNs. Corrected the off-board WIZ850io entry: it is `EXT1` on J6/J7, not PCB reference U6 (LTC6993-1 timer). Robotistan working BOM, CAD BOM, and PnP use 56 designators and match value/footprint/MPN. Supplier purchase codes, stock, alternate approval, and THT/WIZ850io assembly acceptance remain open.
- Final KiCad 10.0.8 run: schematic ERC exit 0/0 errors/0 warnings; PCB DRC+schematic parity exit 0/0 violations/0 unconnected pads/0 footprint errors/0 parity errors. Reports copied to `validation-reports/` and the DRAFT-0.4 package.
- Gerbonara parsed all 11 current Gerber layers and both Excellon outputs, reporting 183 plated hits (4 slots) and 6 NPTH. NoX2/no aperture macros removed earlier parser issues; the parser still gives a non-fatal `G90` placement warning.
- All files under `manufacturing/DRAFT-2026-11-09-DRAFT-0.4/` remain explicitly DRAFT. No production release package or approval marker exists. Hikvision docs confirm separate Open/Close command interfaces and an Open/GND, Close/GND control pattern; exact installed controller revision/terminal labels and contact-load limits remain unverified. Independent CAM/mechanical review, Robotistan CAM/stackup/assembly confirmation, and first-article reset/brownout/timing/relay/network/power measurements are still required.
- `python3 manufacturing/release_check.py`: exit 1, correctly blocked because the approved release marker, production ERC/DRC copies, Gerber ZIP, BOM and position files are absent.
- **Production status: NOT production-ready.** These CAD checks establish parse/ERC/DRC/parity only; they do not establish assembly capability, device compatibility, electrical margin, enclosure fit, or field fail-safe behavior.

# 2026-11-09 continuation — BOM synchronization and release gate

- KiCad CLI 10.0.8 recheck: ERC exit 0 with 0 errors/warnings; PCB DRC + schematic parity exit 0 with 0 reported violations, 0 unconnected pads, 0 footprint errors and 0 parity issues. Current reports: `validation-reports/schematic-erc.txt`, `validation-reports/pcb-drc.txt`. `git diff --check` passes.
- Synchronized exact manufacturer MPN fields across schematic, PCB, CAD BOM and Robotistan draft BOM for 27 additional references (C1–C9 except absent reference numbers, C28/C29, C30, D1–D4, F1, J1/J2/J4/J5/J6/J7, K1/K2, L1, Q1/Q2, U1/U2/U3, plus previously assigned resistor and timer parts). 54/56 BOM references now have MPNs; CAD BOM and Robotistan BOM MPNs match each other and schematic/PCB fields.
- Two switch rows SW1/SW2 remain unresolved: E-Switch’s current page lists `TL3342F160QG` as a configuration, while the manufacturer’s change notice marks that order code obsolete. No replacement selected without footprint/mechanical confirmation.
- MPN selection does not complete electrical ratings: C1/C7 are 10 µF, 25 V in 0805 on the protected 12 V rail; their effective capacitance under DC bias and AP63203 input-capacitance margin still require calculation. Supplier inventory/Robotistan codes and assembly acceptance are unverified.
- During field synchronization, KiCad `pcbnew` reserialized the whole board and introduced 43 silkscreen warnings. That save was discarded. The pre-save board was recovered from `/tmp/fac-trial/FAC-IO-Mini-V1.kicad_pcb`, then metadata was applied without geometry reserialization; KiCad DRC/parity returned 0 violations.
- **Release: NOT production-ready.** No Robotistan project-specific CAM/stackup/assembly acceptance, reliable independent CAM and mechanical review, enclosure/module sample fit, independent electrical review, or first-article fail-safe/thermal/network measurements. `python3 manufacturing/release_check.py` exits 1 because approved release files are intentionally absent.
- **Next:** close the two switches and DC-bias/rail budget; obtain Robotistan CAM/assembly acceptance; complete independent review and first-article validation. Only then regenerate and approve production-named files.

# 2026-11-09 continuation — LTC6993-1 schematic integration checkpoint
- Replaced the capacitor-based dual SN74LV221A pulse timing stage in the schematic with two LTC6993-1 one-shot channels. The intended benefit is removing the large timing-capacitor power-down path; the selected network is nominally about 503 ms and still requires scope validation.
- Local KiCad 10.0.8 ERC: exit 0, 0 errors/warnings; report `validation-reports/schematic-erc.txt`.
- Local KiCad 10.0.8 PCB DRC with `--schematic-parity`: exit 5; report `validation-reports/pcb-drc.txt`. Physical DRC reports zero violations and zero unconnected pads, but the board is stale versus the schematic and has 40 footprint/parity mismatches (old SN74LV221A, no U6/R29/R30, old timing passives and obsolete PULSE_ARM connection).
- PCB routing/layout, BOM and manufacturing exports have not been synchronized to this schematic revision. Existing DRAFT Gerbers must not be sent to fabrication. No production readiness is claimed.
- Synchronized `hardware/component-selection-v1.md`, `hardware/gpio-map-v0.md` and `hardware/architecture.md` to the new schematic intent; removed the obsolete PULSE_ARM/GPIO20 assignment and recorded PCB parity failure. A temporary PCB placement trial under `/tmp` was rejected and did not alter the main board.
- Repeated official main-board checks with KiCad 10.0.8: ERC exit 0 / 0 violations; PCB DRC+schematic parity exit 5 / 0 physical DRC violations / 0 unconnected pads / 40 parity issues. Reports refreshed at `validation-reports/schematic-erc.txt` and `validation-reports/pcb-drc.txt`.
- Final timer placement trial corrected the capacitor values to the schematic, removed stale copper stubs and fixed its project-local footprint-library path. The adopted PCB is now synchronized with the LTC6993-1 schematic; the official KiCad 10.0.8 run reports ERC exit 0 / 0 violations and DRC+schematic parity exit 0 / 0 violations / 0 unconnected pads / 0 parity errors.
- Refreshed CAD-derived DRAFT BOM, all-component/SMD/Pick-and-Place positions, schematic PDF, assembly view, Gerber and drill outputs under `manufacturing/DRAFT-2026-11-09-WIZ850io/`. The DRAFT ZIP passes integrity checking and its 56 BOM references match 56 placement references. Only 27/56 board rows currently have manufacturer MPNs; 29 are still unresolved.
- Independent Gerbonara parsing recognizes the 4-layer stack and board outline (110.1 × 77.1 mm), 179 plated round hits + 4 slots, and 6 NPTH hits. It emits non-fatal Excellon `G90` and `RoundRect` macro warnings; CAM interpretation/visual approval remains open. `hardware/gpio_check.py` was brought into sync with the current schematic and passes its static 11-signal check; reset behavior is still unverified.
- **Next:** freeze and source the remaining exact BOM, perform independent Gerber/CAM and mechanical review, resolve Robotistan assembly/stackup acceptance, and complete first-article reset/brownout/timing/relay/network tests. This is a CAD-gate pass, not production approval; the release gate remains blocked.

# Current checkpoint — 2026-11-09

**Release state: NOT production-ready.** The current integrated engineering draft uses ESP32-C3-WROOM-02-N4, two Omron G6K-2P-Y dry-contact relays, and a plug-in WIZnet WIZ850io module. Only OPEN/CLOSE low-voltage barrier command contacts are in scope; no motor or mains connection.

# 2026-11-09 continuation — timer power-down clamp integration
- Reviewed TI SN74LV221A Rev. H power-down guidance: with 1 µF timing capacitors, stored charge can flow through pin 2/14 protection diodes; TI limits that current to 30 mA and recommends external clamp diodes when the supply can fall too quickly. This board does not establish a sufficiently slow 3.3 V decay, so the risk needs circuit closure.
- Added D5/D6 to the schematic as Nexperia PMEG2010EA,115 Schottky clamp candidates from each TIMERx_CEXT node to 3V3, using the verified installed `Diode_SMD:D_SOD-323` footprint. Schematic ERC exit 0, zero errors/warnings; netlist export exit 0.
- The current PCB has no D5/D6 footprints. Re-ran PCB DRC with schematic parity: exit 5, 0 copper-rule violations, 0 unconnected pads, but 2 missing-footprint parity warnings for D5/D6. Official report is `validation-reports/pcb-drc.txt`. The board was not modified by the placement/routing experiments; failed temporary copies remain under `/tmp` only.
- Placement trials confirmed the existing front-side timing area is crowded, and proposed via/inner-layer routes caused shorts or clearance/crossing violations. No trial route was adopted. The draft BOM, Gerbers, and position files therefore do not include D5/D6 and are stale relative to the schematic.
- `python3 manufacturing/release_check.py`: exit 1; approval marker, release ERC/DRC copies, production Gerber ZIP, BOM, and position export remain absent. `git diff --check`: pass.
- **Next:** redesign the timing-circuit placement/routing or select a timing limiter that avoids this capacitor power-down exposure; then synchronize schematic/PCB/BOM/positions and regenerate only DRAFT exports. Continue with independent electrical/layout review, Robotistan CAM/assembly confirmation, and first-article power/reset/pulse/fail-safe tests. **Production release is not approved.**

# 2026-11-09 continuation — fresh local production-gate check
- Re-ran installed KiCad 10.0.8 against the current source: ERC (`--severity-all --exit-code-violations`) exit 0, 0 violations; PCB DRC with schematic parity (`--severity-all --exit-code-violations --schematic-parity`) exit 0, 0 violations, 0 unconnected items and 0 parity errors. Netlist export succeeded. `git diff --check` passes.
- Re-ran `python3 manufacturing/release_check.py`: exit 1. It reports the intentionally absent `release/APPROVED.txt`, release ERC/DRC copies and production-named Gerber ZIP/BOM/position exports. No approval marker or production-named files were created.
- The current draft Gerber ZIP contains all 14 expected Gerber/job/drill entries and passes Python ZIP integrity validation. This does not substitute for an independent Gerber/drill viewer review or fabricator CAM acceptance.
- Reviewed TI's current SN74LV221A Rev. H datasheet: with the fitted 1 µF timing capacitors, abrupt 3.3 V collapse can send capacitor discharge through the IC input protection diode; TI says to add external clamp diodes if supply fall time cannot be guaranteed. The project has no verified clamp or power-down measurement. Treat this as an unresolved electrical design risk, not merely a test TODO.
- **Release remains blocked** by exact BOM/procurement freeze, timing-capacitor clamp and pulse-window validation, WIZ850io/socket/enclosure mechanical mating, supplier CAM/assembly confirmation, and first-article bench/fail-safe tests. No production release or supplier approval has been claimed.

# 2026-11-09 continuation — resistor BOM candidate freeze
- Updated `manufacturing/DRAFT-2026-11-09-WIZ850io/bom/robotistan-bom-draft.csv`: added YAGEO RC-series 0603, 1% MPN candidates to all 20 resistor placements. Manufacturer sheets confirm resistance, 1% tolerance, 0603 geometry, and 0.1 W rating for the series/selected values.
- Candidate mappings: 10 kΩ `RC0603FR-0710KL`, 5.1 kΩ `RC0603FR-075K1L`, 22 Ω `RC0603FR-0722RL`, 68 kΩ `RC0603FR-0768KL`, 100 kΩ `RC0603FR-07100KL`, 470 kΩ `RC0603FR-07470KL`, and 1 kΩ `RC0603FR-071KL`.
- No Robotistan/LCSC code, stock, lead time or assembly-sourcing acceptance was verified; resistor rows remain candidates and BOM is still DRAFT. This work does not validate the 470 kΩ / 1 µF pulse tolerance window or repair the timing-capacitor power-down clamp concern.
- CAD-exported schematic BOM and Robotistan draft agree for all 20 resistor MPNs. The release checker remains blocked (exit 1): no approved marker/reports or production-named export package was created.
- Schematic and PCB MPN fields now match for all 20 resistors; generated CAD BOM exports all 20 values. ERC exit 0 (0 errors/warnings); DRC + schematic parity exit 0 (0 violations/unconnected/footprint/parity issues); `git diff --check` passes. These checks do not close electrical or procurement blockers.

# 2026-11-09 continuation — buck output capacitor candidate update
- Changed C4/C5 from 22 µF / 6.3 V to Murata `GRM21BZ71A226ME15L`, 22 µF / 10 V X7R 0805. The manufacturer reference sheet confirms value, voltage, X7R, ±20%, and 0805 dimensions. The higher rating reduces DC-bias derating at 3.3 V; combined effective-capacitance range still needs final verification.
- Synchronized C4/C5 value and hidden MPN fields in schematic, PCB and draft BOM. Regenerated schematic BOM, 54-reference all-components and Robotistan position files, schematic PDF, and a 1:1 black-and-white assembly PDF with values suppressed for label readability. Visual review: one A4 sheet; assembly reference labels legible at board scale. No copper or footprint geometry changed, so Gerber files remain geometrically current.
- Source review corrected the buck note: AP63203 datasheet Table 2 recommends 3.9 µH for 3.3 V; current Coilcraft XAL5050-472MEC is 4.7 µH within the datasheet's general 2.2–10 µH range. Coilcraft published Isat 6.6 A and Irms 6.1 A at 20°C rise; estimated ripple at provisional 12 V is 0.46 A. Actual input range and thermal test remain open.
- KiCad 10.0.8 ERC exit 0 (0 errors/warnings), DRC+parity exit 0 (0 violations, unconnected, footprint or parity errors); 22/22 checked schematic/BOM MPNs match (20 resistors, C4/C5); all-components and assembly positions contain 54 refs; `git diff --check` passes.

## Verified in this checkout

- KiCad CLI: 10.0.8.
- `kicad-cli sch erc --severity-all --exit-code-violations -o validation-reports/schematic-erc.txt hardware/FAC-IO-Mini-V1.kicad_sch`: **exit 0**, 0 errors and 0 warnings.
- `kicad-cli pcb drc --severity-all --exit-code-violations --schematic-parity -o validation-reports/pcb-drc.txt hardware/FAC-IO-Mini-V1.kicad_pcb`: **exit 0**, 0 DRC violations, 0 unconnected pads, 0 footprint errors, 0 parity errors.
- `kicad-cli sch export netlist`: **exit 0**.
- New draft exports from current CAD: 11 Gerber layers including 4 copper layers and board outline, separate plated/non-plated drill files (176 plated holes, 6 unplated), CAD BOM, all-footprint positions, SMD positions, schematic PDF, assembly PDF.
- Draft Gerber ZIP has all 14 Gerber/job/drill files at archive root; `unzip -t`: **pass**. Independent Gerbonara parsing found a closed 110.1 × 77.1 mm outline, 4 copper layers, 172 plated round drills + 4 plated slots, and 6 NPTH. Top/bottom stack render visually inspected. Gerbonara reported non-fatal Excellon `G90` placement and `RoundRect` macro warnings; supplier CAM review remains required.
- `python3 manufacturing/release_check.py`: **exit 1**, as expected: production approval marker and production-named reports/ZIP/BOM/position exports are absent.
- Robotistan draft BOM and Pick & Place files each contain 54 board references and match 54/54; the plug-in WIZ850io is separately listed and absent from board placement. `git diff --check`: **exit 0**.

## Current changes

- Replaced the carrier's discrete W5500 + magjack CAD with the WIZ850io socket interface; added two local Samtec-style socket footprints and routed host signals. Extended the top-right board edge 2 mm, giving the module body envelope about 2.19 mm nominal edge margin; DRC remains clean. The module itself is a separate plug-in component, listed in `bom/external-items.csv` and excluded from PCB BOM and placement.
- Generated `manufacturing/DRAFT-2026-11-09-WIZ850io/`; the prior `DRAFT-2026-11-08/` export is stale and must not be used.
- Updated README, validation, architecture, component-selection, GPIO map, requirements, and roadmap to reflect the current design and blockers. Removed obsolete discrete-W5500 MDI-specific custom DRC rules; retained isolated OPEN/CLOSE copper clearance.

## Open production blockers

1. Exact purchasing MPN and datasheet/footprint verification for generic passives and all protection/connector parts; BOM procurement freeze and availability are not done.
2. Physical WIZ850io/header mating, orientation, insertion height, retention and enclosure/cable fit are not proven.
3. Robotistan service page currently lists 1/2/4-layer PCB options and BOM + Pick & Place assembly intake; its form describes THT/SMD choices and standard PCB minimum quantity 5. No project-specific DFM/stackup/finish/slot quote or component-sourcing approval has been completed.
4. Independent review of power budgets, relay isolation/fail-safe, protection, reset/pulse limiter operation, antenna keepout and electrical drawings is not complete. TI warns the current 1 µF monostable timing capacitors may need power-down clamp review; no clamp is proven in the current circuit.
5. DS-TMG420 command-input minimum load is undocumented; G6K is a low-level relay candidate but barrier compatibility remains unverified. Use isolated COM/NO across only the controller's OPEN/Rising or CLOSE/Falling input pair.
6. No board has been assembled; no power, Ethernet, USB/backfeed, relay pulse/fault, EMC, or controlled barrier tests have been run.
7. Independent Gerbonara parsed and rendered the DRAFT top/bottom Gerbers and drill files; its non-fatal format warnings and Robotistan CAM acceptance remain open. The generated schematic drawing uses a sparse A0 page; improve its readability before final handoff.

Do not create `release/APPROVED.txt` or production-named outputs before these gates are closed. Historical continuation notes below document rejected experiments and earlier states; this checkpoint supersedes their release/architecture summaries.

---

# 2026-11-09 continuation — current release gate and module-candidate check
- Re-ran KiCad 10.0.8 on the actual project files: `kicad-cli sch erc --severity-all --exit-code-violations` **exit 0, 0 violations**; `kicad-cli pcb drc --severity-all --exit-code-violations --schematic-parity` **exit 5, 18 violations, 0 unconnected pads, 0 footprint errors**. Current reports: `validation-reports/schematic-erc.txt` and `validation-reports/pcb-drc.txt`. All 18 PCB violations are custom W5500 MDI path-length, pair-skew, via-count, and differential-gap errors; they are not waived.
- `python3 manufacturing/release_check.py` **exit 1**. Still missing approved release marker, release ERC/DRC reports, production Gerber ZIP, production BOM, and production position CSV. No approved files were generated.
- WIZ850io host-interface candidate: the best saved DRC snapshot (`/tmp/fac-current/module-integrated-drc18.txt`) is **exit 5, 1 dangling-track warning, 0 unconnected pads, 0 footprint errors** after moving the generated socket geometry into a project-local library and hiding reference text. This is still an isolated PCB-only experiment. The subsequent stale-trace cleanup snapshot (`module-integrated-drc19.txt`) introduced **2 unconnected items** and is rejected; it must not be adopted. No candidate has schematic parity, verified module orientation/enclosure fit, or assembly sign-off.
- Official WIZnet documentation confirms the WIZ850io host pin map, dual 1x6 2.54 mm headers, 3.3 V supply and 50 ms post-reset SPI delay. This supports the interface concept only; it does not validate the host PCB candidate or replace CAD parity, assembly confirmation, and prototype testing.
- **Decision: NOT production-ready.** Next work: implement and verify a single schematic-synchronized Ethernet option, resolve the 18 main-board DRC violations (or replace the MDI circuit with a mechanically validated module interface), synchronize BOM/position outputs, then complete independent review, fabricator stackup/assembly confirmation, and first-article electrical/safety tests before release.

# 2026-11-09 continuation — WIZ850io control routing follow-up
- Re-routed the disposable module candidate from MCU-side netlist points toward its host sockets. Latest KiCad DRC is **exit 5, 35 violations, 2 unconnected items**; remaining errors include signal clearance/short/crossing issues, while obsolete circuit stubs and missing library registration still produce warnings. The DRC report is `/tmp/fac-current/module-integrated-drc5.txt`. This candidate is rejected and no experimental route has been copied into the main PCB.
- Main release decision is unchanged: the checked-in schematic still passes ERC, main PCB DRC still fails 18 project MDI constraints, and the release checker still exits 1. The production design/package is **not ready**.

# 2026-11-09 continuation — release gate and routed fallback recheck
- Follow-up disposable WIZ850io candidate reuses existing signal vias and routes the six low-speed SPI/reset/interrupt nets. Latest candidate DRC is still **exit 5, 32 violations and 4 unconnected items**, including one clearance error and numerous legacy dangling stubs; it is rejected and remains under `/tmp/fac-current/`. It is not schematic-synchronized and cannot be used for manufacturing.
- Ran `python3 manufacturing/release_check.py`: **exit 1**. Missing `release/APPROVED.txt`, release ERC/DRC reports, non-draft Gerber ZIP, production BOM, and production position CSV. No release artifacts were created. `git diff --check` passes.
- Next: finish either the discrete MDI redesign or a single integrated daughter-module design; synchronize schematic, board, footprint library, firmware pin map and BOM; then pass KiCad ERC/DRC/parity and independent manufacturing review before generating approved files. First-article electrical tests remain a separate release gate.

# 2026-11-09 continuation — WIZ850io host-interface PCB trial
- Built an isolated PCB candidate in `/tmp/fac-current/` using two 1x6 plated-through host sockets at the WIZ850io 20.32 mm row spacing; the projected 23 x 25 mm module body fits the current board edge envelope. This is a preliminary geometric fit only; it does not prove final connector orientation, enclosure access, module retention, or assembly feasibility.
- Removed the discrete W5500/magjack circuit in the disposable candidate and attempted the six SPI/reset/interrupt routes. KiCad 10.0.8 DRC returned **exit 5, 29 violations**, including two signal crossings, 15 unconnected items, dangling tracks, temporary footprint-library and silkscreen warnings. Candidate rejected; no schematic, main PCB, or manufacturing file was replaced.
- Next: either finish a routeable daughter-module interface and integrate its symbols/footprints into the single source-of-truth schematic, or continue the discrete MDI placement/routing redesign. The main project remains at the fresh 0-violation ERC / 18-violation DRC result above; no manufacturing release.

# 2026-11-09 continuation — fresh local CAD gate
- Re-ran the installed KiCad CLI (10.0.8) against the current integrated schematic and PCB. `kicad-cli sch erc --severity-all --exit-code-violations`: **exit 0, 0 violations**. `kicad-cli pcb drc --severity-all --exit-code-violations --schematic-parity`: **exit 5, 18 violations**, 0 unconnected pads, 0 footprint errors; report now saved in `validation-reports/pcb-drc.txt`. Netlist export succeeded (exit 0).
- Current PCB blockers are four RX path-length violations, two RX pair-skew violations, three MDI via-count violations and nine MDI differential-gap violations. The measurements confirm the discrete W5500 Ethernet routing still fails project MDI constraints. No experimental routing or WIZ850io interface has been applied to the main CAD.
- Next: produce one complete Ethernet implementation candidate (discrete MDI redesign or mechanically verified WIZ850io daughter-module interface), then run ERC, full project-rule DRC, schematic parity and physical clearance inspection on the candidate before adopting it. Manufacturing remains blocked.

# FAC-IO Mini V1 — PROJECT STATUS / AI HANDOFF
Last reviewed: 2026-11-09. Branch: main.
**Status: ENGINEERING DRAFT / NOT PRODUCTION READY.** The newer dated entries at the top supersede the historical continuation notes below.

## 2026-11-08 continuation — disposable MDI capacitor placement trial
- Used local KiCad 10.0.8 and disposable copies only. Rotated/moved C25/C26 near J3. The first placement-only trial had 5 native DRC warnings and **4 unconnected pads**; it did not load the project-specific `.kicad_dru` rules, so its result is not comparable to the main-board DRC and is not a pass.
- Moving the distant matching/bias resistors while retaining their old traces produced short circuits and 16 unconnected pads in `/tmp/fac-mdidesign/placed-drc.txt`; discarded. No candidate route has passed full DRC, and no change from this experiment was copied into `hardware/FAC-IO-Mini-V1.kicad_pcb` or manufacturing outputs.
- Reconnected all four moved capacitor pads in an experimental route while preserving R16/R17 branches. With the project rules explicitly loaded, KiCad DRC returned **28 violations, 0 unconnected pads** (`/tmp/fac-mdidesign/rerouted-full-drc.txt`). Remaining failures include RX length/skew, no-via, pair-gap, connector fanout shorts/crossings and built-in copper clearance. Candidate rejected; main board and draft fabrication outputs were not changed by the experiment.
- Refreshed main-board checks at 17:55 with KiCad 10.0.8: ERC **exit 0, 0 violations**; DRC/parity **exit 5, 19 violations, 0 unconnected pads, 0 parity issues**. The current DRC report is saved at `validation-reports/pcb-drc.txt`; `git diff --check` passes. One RX skew measurement changed since the earlier report, so the current count is 19, not 18.
- Next: compare a complete same-layer MDI redesign with the module-interface fallback below; reject any option that does not retain the bias/series-cap topology and pass full DRC plus ERC/parity. Production release remains blocked.

## 2026-11-08 continuation — Ethernet architecture fallback review
- The bare W5500 + CETUS magjack MDI re-route is still failing full project DRC. Added an alternate, source-verified W5500 architecture for feasibility review: WIZnet WIZ850io integrates W5500, PHY, transformer and RJ45; it exposes SPI/reset over two 1x6 headers at 2.54 mm pitch and requires a 3.3 V supply (141 mA typical on the current WIZnet page). The official mechanical drawing gives a 23 x 25 mm module and 20.32 mm row spacing. This would remove board-level MDI layout, but is not yet adopted or represented in the schematic/PCB.
- Supply check on 2026-11-08: Mouser search showed 43 units in stock and LCSC lists the exact module as C134462; Özdisan and DigiKey pages showed zero stock. This is a plausible 2-unit source path, not a confirmed Robotistan PCBA procurement commitment.
- Next: create a temporary module-interface schematic/footprint from the official pinout and dimension drawing, check mechanical clearance on this board, and compare a routed candidate against the current discrete W5500 design. Do not replace the main CAD files until the complete interface and assembly route pass ERC/DRC/parity.

## 2026-11-08 continuation — validation recheck and MDI layout investigation
- Re-ran KiCad 10.0.8 at 17:11: schematic ERC: **exit 0, 0 errors, 0 warnings**; PCB DRC with schematic parity: **exit 5, 18 violations, 0 unconnected pads, 0 footprint errors, 0 parity issues**. `git diff --check` passed. Reports refreshed at `validation-reports/schematic-erc.txt` and `validation-reports/pcb-drc.txt`.
- Inspected W5500 (U4), magjack (J3), and RX series capacitors C25/C26 placement in KiCad. The RX paths are 15.27–17.17 mm per capacitor side; moving the capacitors between PHY and magjack may reduce these runs, but no relocated/re-routed candidate passed DRC. No unverified layout was copied into the main board.
- The current main PCB and draft fabrication exports remain unchanged by this layout investigation. The board is still blocked by MDI length/skew/via/gap violations and the release blockers listed below. Next: redesign the MDI placement/routing in a disposable board copy, verify all constraints and full-board DRC, then update the board and regenerate draft outputs only after a passing candidate exists.

## 2026-11-08 continuation — MDI constraints added to the CAD gate
- KiCad 10.0.8 schematic ERC returned **exit 0, 0 errors, 0 warnings**. Exported the current schematic netlist and reviewed both timer channels: independent SN74LV221A channels drive separate MOSFET/relay coils; 470 kΩ × 1 µF gives about **470 ms nominal** (component and timer tolerances not included). Gate pull-downs are present. This is netlist evidence only; pulse width, power-on/reset/brownout behavior, and fail-safe operation still need scope/bench tests on assembled hardware.
- Added MDI path-length and pair-skew rules in `hardware/FAC-IO-Mini-V1.kicad_dru`. The rule limits TX PHY-to-magjack paths to 25 mm; RX copper is split by series capacitors, so each side is limited to 12.5 mm. Added a 0.5 mm project pair-skew target (engineering target, not a WIZnet-stated tolerance). Tested the conditions on a temporary copy, then enabled them in the project.
- Added project rules for **zero vias**, WIZnet trace width (6–12 mil) and maximum differential pair gap (10 mil) on W5500 MDI paths. Current `kicad-cli pcb drc --severity-all --exit-code-violations --schematic-parity` returns **exit 5 with 18 violations**: 4 RX path lengths, 2 RX pair-skew, 3 MDI via-count and 9 differential-gap violations; **0 unconnected pads, 0 footprint errors, 0 schematic-parity issues**. This replaces the previous blanket zero-DRC result because default KiCad rules did not evaluate these MDI layout constraints. The exact report is `validation-reports/pcb-drc.txt`.
- Exported the current schematic netlist successfully and reviewed both timer channels: independent SN74LV221A channels drive separate MOSFET/relay coils; 470 kΩ × 1 µF gives about **470 ms nominal** (component and timer tolerances not included). Gate pull-downs are present. This is netlist evidence only; pulse width, power-on/reset/brownout behavior, and fail-safe operation still need scope/bench tests on assembled hardware.
- Re-measured current board copper with KiCad's bundled `pcbnew` API: `ETH_TXP` 26.51 mm / 0 vias / F.Cu; `ETH_TXN` 30.93 mm / 1 via / F.Cu+In1.Cu; `ETH_RXP` 31.23 mm / 3 vias / F.Cu+In1.Cu; `ETH_RXN` 37.17 mm / 3 vias / F.Cu+In1.Cu. Pair length deltas are 4.42 mm (TX) and 5.94 mm (RX). DRC does not assert differential impedance, pair skew, routing length or return-path continuity. WIZnet recommends under 25 mm, matched pair length and no vias/layer changes; current board fails those layout recommendations. Do not release it as production.
- Updated `docs/validation.md` with the current ERC pass, the intentionally failing MDI DRC gate, its project-defined constraints, and remaining release gates.
- Remaining release blockers: MDI placement/routing and confirmed fabricator stackup; exact/available MPNs for the full BOM; independent electrical/layout review; supplier confirmation for assembly and THT parts; and first-article power, Ethernet, relay pulse, reset/brownout/crash and loss-of-link testing. The Robotistan `DRAFT-2026-11-08` package stays marked DRAFT; do not submit it as a production release.
- `unzip -t manufacturing/DRAFT-2026-11-08/DRAFT-FAC-IO-Mini-V1-Gerber-Drill.zip` passed archive integrity. `python3 manufacturing/release_check.py` correctly returned **exit 1**: the production approval, release reports, non-draft Gerber ZIP, BOM and position package are absent. `git diff --check` passed. The successful CAD run does not override this intentional release gate.

## 2026-11-08 fabrication draft refresh — CAD pass, release still blocked
- Checked Robotistan's live PCB service page. It offers FR-4, 1/2/4 layers, standard thickness options, and PCB assembly BOM/Pick-and-Place workflow; standard PCB minimum is 5. The public configurator does not state a stackup table or controlled-impedance service, so the current Ethernet/USB traces cannot be signed off against a verified Robotistan stackup. Keep first order to prototype/bring-up until the actual stackup is supplied and reviewed.
- New routed-length audit: summed KiCad copper centerline segments by Ethernet pair net: `ETH_TXP` 26.51 mm vs `ETH_TXN` 30.93 mm (4.42 mm skew); `ETH_RXP` 31.23 mm vs `ETH_RXN` 37.17 mm (5.94 mm skew). These are preliminary geometry sums, not impedance or PHY validation. Ethernet pairs need review/rerouting and then length/return-path recheck before release. KiCad DRC does not check differential impedance/skew unless those constraints are configured.
- Compared MDI routing to WIZnet's current hardware guide: it calls for 100 Ω differential routing, same-length pairs, preferably under 25 mm, and no vias/layer changes on TX/RX pairs. The existing routed MDI nets have vias/layer changes, and the preliminary segment totals exceed 25 mm. Two temporary F.Cu rerouting trials were rejected (124/126 reported DRC violations, including real shorts/clearance/crossings); neither was copied into the project. The DRC-clean board therefore remains unsuitable for production until MDI placement/routing is redesigned and checked with the fabricator stackup.
- Follow-up FreeRouting F.Cu-only experiment on a temporary copy could not complete the board (30 unrouted connections remained); the four MDI nets were either left open or detoured to 75–89 mm. It was rejected. No experimental tracks or footprint moves were applied to the project PCB or Gerbers.
- Hikvision DS-TMG42 documentation shows separate `Rising Control +/-` and `Falling Control +/-` command pairs, but does not publish their electrical load. Mapped J4/relay K1 to OPEN/Rising and J5/relay K2 to CLOSE/Falling. Renamed the schematic/PCB contact nets and silkscreen accordingly; documented COM/NO-only dry-contact wiring in `README.md`. No FAC-IO supply/ground is connected to the barrier command pairs.
- Matched C9 to manufacturer-specified KEMET `C1206C102KGRACTU` (1 nF, 2 kV, X7R, 1206), preserving the existing routed 1206 footprint. Set exact candidate values for F1 `1812L050/30PR`, FB1 `BLM18AG121SN1D`, and Y1 `ABM8-25.000MHZ-10-D1G-T` in schematic/PCB/BOM. Updated `hardware/FAC-IO-Mini-V1.kicad_sch` and `.kicad_pcb`; the temporary 1812 C9 reroute was discarded because it did not pass DRC.
- Latest local KiCad 10.0.8 `sch erc --severity-all --exit-code-violations`: exit 0, 0 violations. `pcb drc --severity-all --exit-code-violations --schematic-parity`: exit 0, 0 violations, 0 unconnected, 0 parity issues. Reports: `validation-reports/schematic-erc.txt`, `validation-reports/pcb-drc.txt`. `git diff --check`: exit 0.
- Regenerated `manufacturing/DRAFT-2026-11-08/` from the same current schematic/board: 11 Gerber layers, plated/non-plated drills, BOM, front SMD position CSV, and `DRAFT-FAC-IO-Mini-V1-Gerber-Drill.zip`. ZIP integrity passed. Gerbonara independently parsed 4 copper layers plus mask/silk/paste/outline, 212 plated and 8 non-plated drill objects; reported outline bounds ~110.1 x 75.1 mm. The antenna notch and silk labels are on the current board. `manufacturing/release_check.py` exits 1 as intended; no `release/APPROVED.txt` or production package exists.
- Added `DRAFT-schematic.pdf` and `DRAFT-assembly-front.pdf` to the draft package. Rendered both PDFs with Poppler; the assembly drawing uses references without values to reduce clutter. These are review aids, not approved assembly instructions.
- **Open before manufacture:** exact MPNs for remaining passives/ESD/power parts and availability, controlled impedance and return-path review against the actual 4-layer stackup, Ethernet/USB layout and power integrity review, THT assembly confirmation, external barrier OPEN-input electrical data, independent schematic/PCB review, and prototype bench tests (power, Ethernet, output pulse, reset/brownout/crash/link-loss OFF). Draft outputs must not be submitted as a production release.

## 2026-11-08 routed PCB — M3 CAD gate passed; manufacturing blocked
- Current integrated files: `hardware/FAC-IO-Mini-V1.kicad_sch`, `.kicad_pcb`, `.kicad_pro`, `.kicad_dru`, `fac_io.kicad_sym`, `fac_io.pretty/ESP32-C3-WROOM-02_0p3mmThermal.kicad_mod`, `sym-lib-table`, `fp-lib-table`. Replaced the USB receptacle with manufacturer-listed HRO `TYPE-C-31-M-12` and matching installed footprint, eliminating the GCT locating-hole clearance error. Board has 4 layers, GND plane on In1.Cu, GND pour on B.Cu, 82 schematic components and 4 board-only M3 holes. Routed all nets at >=0.2 mm; contact copper has a project DRC rule requiring >=0.5 mm separation. Manually corrected relay contact routes and a GND via after routing.
- Local KiCad 10.0.8: `kicad-cli sch erc --severity-all --exit-code-violations`: exit 0, 0 violations. `kicad-cli pcb drc --severity-all --exit-code-violations --schematic-parity`: exit 0, 0 DRC violations, 0 unconnected items, 0 footprint parity errors. Reports in `validation-reports/`. The source board matches the schematic.
- Measured direct routed paths on the current board: W5500 TXP/TXN to RJ45 19.59/19.11 mm; W5500 RXP/RXN to coupling capacitors 15.14/16.02 mm; coupling capacitors to RJ45 17.17/15.27 mm. This is geometry only; 100 Ω differential impedance, return continuity, full pair coupling and USB 90 Ω impedance have not been verified against a fabricator stackup. ESP32 antenna is still within the board outline, contrary to Espressif's preferred over-edge placement, and requires layout correction or a qualified antenna solution. W5500 analog decoupling, power-loop placement, EMI/ESD, exact passive MPNs and hardware fail-safe testing remain open. No Gerber generated or release approved.
- Next: finish signal-integrity/antenna/power layout, silk polarity and terminal labels, freeze BOM MPNs and stackup, inspect fabrication files and assembly capability, then prototype and bench-test. Do not order this CAD-pass draft as production hardware.

## 2026-11-08 integrated schematic — M2 CAD gate, electrical review open
- Replaced `hardware/FAC-IO-Mini-V1.kicad_sch` functional blocks with one 87-instance, 61-net schematic: 12 V input/protection, AP63203 3.3 V buck, ESP32-C3-WROOM-02-N4, W5500 plus CETUS magjack/matching network, self-powered USB-C, dual SN74LV221A pulse timer, AO3400A coil drivers, two Omron G6K relays and isolated output terminals. Added `hardware/FAC-IO-Mini-V1.kicad_pro`, `hardware/fp-lib-table`; expanded `hardware/sym-lib-table` and `hardware/fac_io.kicad_sym`. No previous user work was discarded; the earlier block draft was replaced only after the generated schematic parsed and passed ERC in `/tmp`.
- Ran local `kicad-cli sch erc --severity-all --exit-code-violations -o validation-reports/schematic-erc.txt hardware/FAC-IO-Mini-V1.kicad_sch`: **exit 0, 0 errors, 0 warnings**. Ran `kicad-cli sch export netlist -o validation-reports/schematic-integrated.net ...`: **exit 0**. Audited the exported net relationships for relay contacts, coil flyback, power isolation, USB VBUS sensing and timer-to-gate drive. This is a CAD/ERC pass, not a full electrical, layout, timing or hardware safety validation.
- **Next:** review exact passive/ESD/fuse/crystal/timing MPNs and power tolerances; regenerate the PCB from this schematic, place and route all 87 physical components, then run schematic parity + DRC. Existing PCB is still the incompatible partial draft. No Gerber or release approval.

## 2026-11-08 PCB synchronization — M3 routing in progress
- Regenerated `hardware/FAC-IO-Mini-V1.kicad_pcb` from the current KiCad XML netlist: 82 physical schematic components, 4 board-only M3 holes, 4 copper layers, 110 × 75 mm outline. Matched every pad to the schematic net and component UUID; placed verified library footprints without intercomponent copper/courtyard overlap. Selected `USB4105-GF-A` in place of the earlier USB4085 because the latter's installed pad geometry violates the default 0.2 mm copper clearance; updated the schematic and board together.
- Added project-local `hardware/fac_io.pretty/ESP32-C3-WROOM-02_0p3mmThermal.kicad_mod`, derived from KiCad 10's module footprint by changing only the twelve GND thermal-via drills from 0.2 to 0.3 mm; this removes the default minimum-drill DRC errors. `hardware/fp-lib-table` includes the local library.
- Real local `kicad-cli sch erc --severity-all --exit-code-violations`: **exit 0, 0 errors, 0 warnings**. Real `kicad-cli pcb drc --severity-all --exit-code-violations --schematic-parity`: **exit 5, 4 USB4105 locating-hole clearance violations, 208 unconnected items, 0 schematic-parity errors**. Reports: `validation-reports/schematic-erc.txt`, `validation-reports/pcb-drc.txt`. Placement, copper routing, USB hole exception/fabricator capability, exact BOM, power/timing calculations and hardware validation remain open. No Gerber generated.
- **Next:** resolve the USB connector hole geometry with supplier capability or another verified footprint, route all signals/power/return paths, then repeat DRC and visual inspection.

## 2026-11-08 manufacturing path and Ethernet part review — M1 in progress
- Reconfirmed the existing working tree changes from the 2026-11-07 audit; no previous edits were discarded. Local `kicad-cli version` remains 10.0.8.
- Checked Robotistan's current PCB service page. `manufacturing/README.md` now records the required fabrication Gerber ZIP/RAR and drill layers, plus BOM and Pick & Place for assembly. The page lists five boards as the standard minimum PCB order; the earlier goal of two assembled prototypes is a bring-up quantity, not a confirmed order quantity. THT component assembly and sourcing still require supplier confirmation. No upload or order was made.
- Added CETUS `J1B1211CCD` as a WIZnet-used integrated-magnetics RJ45 candidate in `hardware/component-selection-v1.md`. The local KiCad 10 footprint exists, but a matching symbol was not found. Pin mapping, center taps, shield/LED network, ESD, footprint-to-datasheet geometry and availability remain open. No schematic or PCB placement was changed for this candidate.
- WIZnet's W5500 reference drawing numbers the candidate RJ45's two chassis pins 13 and 14, while the installed KiCad footprint labels both physical shield pads 13. This discrepancy triggered the manufacturer drawing review below; project CAD uses a single shared SHIELD net for both physical tabs.
- Reviewed CETUS's own connector schematic and mechanical images: PCB pins 1–8 are Ethernet/magnetics, 9–12 are LEDs, and two physical shield tabs share the same chassis. Added project-local `hardware/fac_io.kicad_sym` with one logical SHIELD pin 13 for the installed footprint's two pad-13 tabs, plus `hardware/sym-lib-table`. `kicad-cli sym export svg --symbol J1B1211CCD` succeeded (exit 0) and the rendered symbol was visually checked. This validates CAD parsing and pin labels, **not** the full W5500 circuit, sourcing or schematic/PCB parity. WIZnet's store and LCSC listed the candidate in stock during this review; reconfirm before ordering.
- Compared Omron's G6K-2P-Y bottom-view pin drawing with KiCad's `Relay_THT:Relay_DPDT_Omron_G6K-2P-Y` and compatible `Relay:Omron_G6K-2` symbol. `A1/A2` map to physical coil pins 1/8; standardized contact pads `12/11/14` map to physical 2/3/4, and `22/21/24` to 7/6/5. Updated `hardware/component-selection-v1.md` with this mapping. No relay has yet been placed in the integrated schematic.
- Added a second project-local symbol, `SN74LV221ADR`, from TI's pin table; `kicad-cli sym export svg --symbol SN74LV221ADR` succeeded (exit 0) and the SVG was visually checked. This non-retriggerable dual monostable is a **candidate** to bound both relay pulses; no timeout circuit or firmware handshake exists yet. Updated `hardware/component-selection-v1.md` with the datasheet timing basis and open safety checks.
- Added source-backed candidates for the 3.3 V buck (`AP63203WU-7`; Diodes datasheet confirms 3.3 V/2 A) and 5.08 mm CUI input/output terminals to `hardware/component-selection-v1.md`. These are not a frozen BOM; exact input protection, inductor/capacitor MPNs, footprint geometry, supply range and assembly remain open.
- Visually inspected WIZnet's full `W5500-ref-RJ45WithMag` reference PDF against CETUS's electrical/mechanical drawings and the installed KiCad footprint. Recorded the TX/RX, center-tap, analog-rail, crystal, LED and chassis-ground requirements in `hardware/component-selection-v1.md`. The footprint's 0.9 mm signal, 1.02 mm LED and 1.6 mm shield drills match the manufacturer's hole drawing. This is a reference/footprint review, not a W5500 schematic ERC pass or signal-integrity verification.
- Reviewed TI's `SN74LV221ADR` function and power-down tables. Recorded a candidate reset-safe trigger sequence and the timing-capacitor discharge risk in `hardware/component-selection-v1.md`; it has not been implemented in CAD or bench-tested. Corrected stale status sentences in `hardware/architecture.md` and `docs/validation.md` so they distinguish real draft checks from a passed design gate.
- Re-ran local KiCad 10.0.8 `sch erc --severity-all --exit-code-violations` and `pcb drc --severity-all --exit-code-violations --schematic-parity` against the unchanged main drafts after the reference review. Both returned **exit 5**. Current reports in `validation-reports/` remain **53 ERC violations** and **15 DRC violations, 6 unconnected items, 18 schematic-parity issues**. No production Gerber was generated.
- Ran `python3 manufacturing/release_check.py`: **exit 1**, correctly blocking release because approval, passing ERC/DRC reports, Gerber ZIP, BOM and position files are absent. Marked `hardware/relay-driver-design-v0.2.md` as historical so its superseded SONGLE candidate and GPIO-only timeout cannot be mistaken for the approved relay circuit. `git diff --check` passed.
- Documented the Omron symbol's default-footprint trap (non-Y footprint must be overridden to the chosen `G6K-2P-Y`), the two-coil 18.2 mA nameplate budget, and a provisional 10.8–13.2 V external-supply assumption in `hardware/component-selection-v1.md`. These calculations are not a verified field power budget; temperature and protection-drop checks remain. Final `kicad-cli version` was 10.0.8 and `git diff --check` passed.
- **Next action:** finish exact part selection and electrical design, then replace the block-only schematic with the integrated circuit. Do not export production Gerbers from the disconnected draft PCB.

## 2026-11-07 local KiCad 10.0.8 audit — M0 in progress
- Initial working tree was clean on `main`; `kicad-cli version` returned `10.0.8`.
- Initial real ERC failed to load the main schematic (exit 3); initial DRC failed to load the PCB at line 149 (`fp_text` font thickness in the wrong S-expression, exit 3). No reports were produced by those initial attempts.
- Removed unsupported UUID fields from the 33 embedded library pins in `hardware/FAC-IO-Mini-V1.kicad_sch`. Corrected the two terminal `fp_text` expressions in `hardware/FAC-IO-Mini-V1.kicad_pcb`. Both drafts now parse. A draft schematic netlist was exported to `validation-reports/schematic-draft.net` (export exit 0); it is a functional-block netlist, not a buildable circuit.
- Corrected D1/D2 PCB net assignments: pad 1 is the banded cathode side of KiCad's `Diode_THT:D_DO-41_SOD81_P10.16mm_Horizontal` footprint and is now on `12V_PROTECTED`; pad 2 is coil low. The onsemi 1N400x datasheet identifies the band as cathode. The PCB's manually copied DO-41 pad/drill sizes still differ from the installed library footprint and require part/footprint verification before layout.
- Executed `kicad-cli sch erc --severity-all --exit-code-violations -o validation-reports/schematic-erc.txt hardware/FAC-IO-Mini-V1.kicad_sch`: **exit 5, 53 violations** (3 undriven power pins, off-grid endpoints, isolated labels, missing custom symbol-library table). No ERC pass.
- Executed `kicad-cli pcb drc --severity-all --exit-code-violations --schematic-parity -o validation-reports/pcb-drc.txt hardware/FAC-IO-Mini-V1.kicad_pcb`: **exit 5, 15 DRC violations, 6 unconnected items, 18 schematic/PCB parity errors**. The 15 include 14 footprint-library configuration warnings and one silkscreen overlap; parity includes four missing schematic footprints and 14 extra PCB footprints. No DRC pass. KiCad without `--exit-code-violations` returns 0 even when violations exist; CI must use the flag or inspect the report.
- Verified AO3400A manufacturer datasheet's SOT-23 G/S/D arrangement against the PCB's Q1/Q2 pad 1/2/3 net intent. This is a pin-function check only; the manually copied footprint geometry and supply/transient design remain unvalidated.
- The separate experimental `relay-driver-v0.kicad_sch` initially did not parse. Removed nine unsupported embedded-pin UUIDs and corrected its custom MOSFET symbol to AO3400A/KiCad `Q_NMOS_GSD` pin numbers G=1, S=2, D=3. It now exports a netlist (exit 0), but ERC still reports 44 violations (exit 5, `validation-reports/relay-driver-erc.txt`); it is not integrated or electrically approved. `relay-contacts-v0.kicad_sch` produced 21 ERC violations (exit 5, `validation-reports/relay-contacts-erc.txt`).
- Updated `.github/workflows/kicad-pcb.yml` to use `--exit-code-violations`; previously a DRC report with violations could still return exit 0. Updated `.github/workflows/kicad-schematic.yml` to fail the job on ERC violations instead of printing a warning and allowing a green check. These workflow edits were checked locally for diff whitespace only; no GitHub Actions run has been observed.
- The barrier OPEN input's voltage/current and minimum contact load are unavailable. Added Omron `G6K-2P-Y DC12` as a low-level signal-relay candidate in `hardware/component-selection-v1.md`: manufacturer datasheet lists DPDT, 12 V/9.1 mA coil and 10 µA at 10 mV DC reference failure-rate load; installed KiCad has matching symbol/footprint names. Use one changeover pole per output. This is not a frozen BOM or validated barrier compatibility; the SONGLE candidate remains unapproved for unknown low-current loading.
- **Next action:** replace the functional-block schematic with one integrated, electrically complete schematic using exact sourced MPNs and manufacturer reference circuits. Prioritize relay/terminal minimum-load compatibility, input and USB power domains, ESP32-C3 boot-safe GPIOs, W5500 magnetics/RJ45 pairing, and watchdog/link-loss relay inhibit. Then regenerate the PCB from that schematic; do not complete the disconnected manual routing draft.

## Mission
Design and manufacture two assembled prototype PCBs for an Ethernet-connected, ESP32-C3 + W5500, two-channel dry-contact barrier controller. Integration: LPR/access software -> authenticated LAN command -> timed relay pulse (nominal 500 ms, configurable and bounded) -> barrier controller's low-voltage OPEN input. Never connect relay outputs directly to motor or mains.

## Source of truth
- `README.md`, `docs/requirements.md`, `docs/validation.md`: scope, acceptance and safety gates.
- `hardware/architecture.md`: power/Ethernet/relay architecture.
- `hardware/component-selection-v1.md`, `hardware/gpio-map-v0.md`, `hardware/design-review-v0.md`: candidate components, GPIOs, risks.
- `hardware/netlist-design-v0.csv`: textual connectivity proposal, NOT an exported CAD netlist.
- `hardware/FAC-IO-Mini-V1.kicad_sch`: block-level schematic draft, NOT a complete electrical schematic.
- `hardware/FAC-IO-Mini-V1.kicad_pcb`: partial manually edited PCB draft, NOT routed or schematic-synchronized.
- `hardware/relay-driver-v0.kicad_sch`, `hardware/relay-contacts-v0.kicad_sch`: separate experimental drafts, NOT integrated.
- `.github/workflows/kicad-pcb.yml`, `kicad-schematic.yml`: GitHub Actions KiCad checks; actual passing run NOT independently confirmed.
- `firmware/`: prototype/diagnostic scaffolding; do not assume production firmware.

## Verified progress vs unverified
DONE (repository content): 100x70 mm tentative PCB outline, four M3 mounting holes, R1-R4 resistor footprint drafts, Q1/Q2 MOSFET footprint drafts, D1/D2 diode footprint drafts, J_OUT1/J_OUT2 three-pin terminal footprint drafts; some provisional copper routes. Preliminary requirements, electrical architecture, GPIO allocation, test plan and CI workflow committed.
NOT DONE: actual integrated MCU, Ethernet, 3.3 V regulator, 12 V input protection, USB-C, relays, schematic-to-PCB sync, full routing, ERC/DRC PASS, verified MPNs, verified terminal footprint, Gerber/BOM/PnP manufacturing package, assembled prototype, hardware validation.
IMPORTANT: a GitHub commit is NOT a passed ERC/DRC. Previous assistant updates repeatedly claimed progress without verifying KiCad output. Do not repeat this.

## Critical risks requiring immediate review
1. **MOSFET SOT-23 pin mapping:** draft PCB Q1/Q2 uses pad 1=gate, pad 2=GND/source, pad 3=drain. Verify against chosen AO3400A datasheet and KiCad symbol; do not trust this mapping.
2. **Flyback diode polarity:** corrected draft PCB assignment maps D1/D2 pad 1 (banded cathode) to protected 12 V and pad 2 (anode) to coil low. No actual relay coil or protected rail is present; verify again after schematic-to-PCB synchronization.
3. **Partial gate traces:** check geometric clearance, pad attachment and potential shorts; manually generated PCB text has not been validated by KiCad.
4. **Contact terminal footprint** `FAC_DRAFT:Terminal_3_P5.08_UNVERIFIED` is provisional and not tied to a chosen manufacturer component.
5. **No relay footprints**: contact terminals currently have no actual electrical path to relay contacts.
6. **W5500** requires correct oscillator, PHY magnetics, center-tap, reset, power decoupling, ESD and matched RJ45.
7. **ESP32-C3** GPIO0/1 relay drive candidate, GPIO4–7 SPI/JTAG overlap, USB GPIO18/19, boot straps GPIO2/8/9. Validate actual module pinout and reset behavior.
8. **Power domains:** 12 V input, relay coils, buck 3.3 V, USB VBUS backfeed prevention and transient protection unresolved.
9. **Manufacturing:** PCB is explicitly NOT approved; no valid production Gerbers.
10. **Fail-safe behavior:** gate pulldowns only establish OFF when MCU pins are high-impedance. A crashed MCU can hold GPIO high; link loss does not inherently de-energize a relay. An independently reviewed watchdog/enable mechanism and timed pulse limit are required before claiming OFF on crash or network failure.

## Recent repo commits
- `9809b967`: changed flyback diode PCB net assignments (needs real footprint/symbol check).
- `ef8fb960`: PCB DRC CI fails on nonzero DRC result and uploads report.
- `e06d94ab`: schematic CI fails on parse/netlist errors and prints KiCad version.
- `dabe7067`: PCB CI installation timeout and CLI existence checks.
These commits are evidence of file changes, NOT evidence of passing CI.

## Local Mac environment / next AI agent
User installed **KiCad 10.0.8** using `brew install --cask kicad` on Apple Silicon macOS. Local shell access was confirmed in the audit above. A later agent must still verify its own execution environment and re-run checks after design changes.

Run:
```bash
kicad-cli version
git clone https://github.com/kemallaydn/FAC-IO-HARDWARE.git  # only if not already cloned
cd FAC-IO-HARDWARE
mkdir -p validation-reports
kicad-cli pcb drc --severity-all -o validation-reports/pcb-drc.txt hardware/FAC-IO-Mini-V1.kicad_pcb
kicad-cli sch erc --severity-all -o validation-reports/schematic-erc.txt hardware/FAC-IO-Mini-V1.kicad_sch
```
Use `--exit-code-violations` to make violations fail the command; add `--schematic-parity` for local PCB comparison. Capture stdout, stderr, exit code and reports. Do not suppress failures. KiCad 10 may migrate older KiCad format; preserve backups and make controlled changes.

## Priority execution sequence
P0: Establish repeatable local CLI and CI; capture REAL initial ERC/DRC reports, identify syntax errors and component pin/footprint mismatches. Fix bad CAD structure, avoid arbitrary trace additions.
P1: Choose exact purchasable MPNs and vendor reference circuits; document relay minimum dry-contact load, pinout, enclosure, connector pitches, power input range and thermal/current budget.
P2: Create ONE integrated KiCad project/schematic with ESP32-C3, W5500, magnetics RJ45, oscillator, 12V protections, buck, USB-C, 2 relay drivers and real relays/terminals. ERC zero errors, reviewed warnings.
P3: Update PCB from schematic, place verified footprints, enforce antenna keepout, isolate contact nets, route power/Ethernet/USB and all signals, proper return paths. DRC zero unwaived errors.
P4: Export fabrication and assembly outputs from SAME approved commit: Gerber, drill, BOM, position files, schematic PDF, assembly drawings; inspect in independent viewer; confirm Robotistan PCBA capabilities for THT parts.
P5: Order 2 prototypes; current-limited bench bring-up, power checks, USB flash, Ethernet tests, relay continuity, pulse/failsafe testing, then controlled barrier integration.

## Definition of done
A successful CI check alone does NOT mean ready to manufacture. Only mark ready after exact MPNs and pin mapping, ERC/DRC, independent design review, Gerber inspection, assembly confirmation and prototype test plan are documented. Keep `PROJECT_STATUS.md` updated after every meaningful work session with completed work, evidence (commit/command/report), blockers and next exact action. Never claim tests passed without logs.
# 2026-11-12 — Right-edge V3 router adayı DRC sonrası reddedildi
- Önceki `rightedge-tight5` router çıktısında 9 adet 0,15 mm iz bulundu; geçici routed kopyada bu izler 0,20 mm yapıldı. Gerçek KiCad 10.0.8 DRC, zone refill sonrası **0 açık bağlantı** buldu; ancak error-level DRC **9 ihlal** ile başarısız oldu: 12V_IN/12V_FUSED hatlarında proje kuralı 0,45 mm iken beş parça 0,20 mm; iki röle kuru-kontak bölgesinde 0,50 mm kuralına karşı dört açıklık 0,2117–0,2233 mm. Kural gevşetilmedi.
- MDI ölçümü aynı adayda (izler 0,20 mm): ETH_TXN **33,19 mm / 1 via**, ETH_TXP **31,28 mm / 1 via**, ETH_RXN_PHY **17,86 mm / 3 via**, ETH_RXP_PHY **15,93 mm / 2 via**; kablo tarafı RX segmentleri 8,71/5,84 mm ve viasız. WIZnet'in via'sız/tercihen <25 mm MDI yönlendirme beklentisini karşılamıyor. R31/R32'nin mevcut konumu TX yollarını uzatıyor; MDI pin sırası da mevcut magjack yerleşiminde düz eşlenmiyor.
- Tam-severity denemesinde 416 bulgu sayıldı: yukarıdaki 9 hata ile birlikte ağırlıklı olarak footprint/silkscreen çakışmaları. Geçici dosya farklı tasarım adıyla çalıştığı ve eşlenmiş şematik içermediği için bu çalıştırma **parity doğrulaması değildir**; komut parity ağ listesini çıkaramadığını açıkça bildirdi. Bu yüzden rapor yalnız geçici aday DRC’sidir.
- Aday: `/tmp/facio-v3-finalize/rightedge-tight5-routed.kicad_pcb`; düzeltme/raporlar aynı geçici dizinde. **Ana V3 şema/PCB ve üretim paketleri değiştirilmedi; Gerber/BOM/PnP oluşturulmadı.** Bu aday reddedildi, üretime hazır değil.
- **Sonraki gerekli tasarım kararı:** Ethernet alanını W5500 ve J1B1211CCD pin sırası uyumlu yeni yerleşimle baştan kur; MDI pasiflerini inline ve yakın konumlandır; ardından MDI'yi viasız route et. Aynı yerleşim denemesinde 0,45 mm 12V yolları ve röle kontaklarının 0,50 mm ayırımı korunarak tüm netler yeniden route edilmeli; sonrasında şema-parity, tam DRC, MDI uzunluk/via ve üretici/CAM kontrolü yapılmalı.

# 2026-11-12 — MDI pin sırası yön denemesi
- U6 W5500, sağ-kenar adayında 180° yerine 0° çevrildi. Trackless yerleşim DRC’si **0 fiziksel hata** verdi ve W5500 TX pad sırası magjack MDI pad sırasıyla hizalandı. Bu, yalnızca geometrik yerleşim kontrolüdür; 183 bağlantısız öğe vardı.
- FreeRouting 2.5.0 ile geçici yönlendirme denendi: **11 unrouted item** (KiCad SES importu sonrası 22 açık bağlantı), 0 FreeRouting kendi ihlali; KiCad error-level DRC **55 ihlal** verdi: 50 iz genişliği ve 5 röle kuru-kontak açıklığı. ETH_TXN/TXP 51,08/50,35 mm ve 3 via/net; ETH_RXN/RXP_PHY 37,61/23,41 mm ve 4/2 via. Bu sonuç MDI hedeflerini iyileştirmedi; aday reddedildi.
- Deneme yalnız `/tmp/facio-v3-finalize/u6flip-*` dosyalarında. Ana V3 şema/PCB’ye değişiklik aktarılmadı ve imalat çıktısı üretilmedi. Bu karşılaştırma, yalnız U6 yönünü çevirmekle çözüm gelmediğini gösteriyor; J7 kenar yönü ve MDI pasifleri tek bir ortak yerleşim olarak yeniden kurulmalı.
# 2026-11-12 — U6/J7 birlikte döndürme ile kenar MDI geometrisi bulundu
- Yeni trackless yerleşim denemesi: W5500 U6 `(178.5,127.5,180°)`, J1B1211CCD J7 `(204.5,124.5,270°)`; J7 gövdesi sağ kart kenarına yakın. TXP/TXN ve RXP/RXN pad sıraları aynı yönde eşleşiyor; düz pad-merkez mesafeleri TXN/TXP **22,07/22,46 mm**, RXN/RXP **24,39/24,42 mm**. Bu hesaplama yalnız geometrik başlangıçtır; gerçek iz uzunluğu, empedans veya elektriksel performans kanıtı değildir.
- KiCad 10.0.8 placement-only DRC bu geçici adayda **17 fiziksel hata** buldu (4 kısa devre, 4 açıklık, 4 lehim maskesi köprüsü, 5 courtyard çakışması); yönlendirme kaldırıldığı için **183 açık öğe** var. Hatalar U6’nin çevresindeki 0402 RX seri kapasitör/49,9 Ω ağı ile eski yerleşimden kalan lokal pasiflerin birbirine ve U6 pad sırasına sığmamasında yoğunlaşıyor. Bu yerleşim onaylı PCB değildir.
- Deneme: `/tmp/facio-v3-finalize/mdialign10-trackless.kicad_pcb` ve `mdialign10-place.json`. Ana V3 şema/PCB değişmedi, üretim çıktısı yok. İlerleme: magjack pin sırası/top-edge sorunu çözülebilir görünüyor; sıradaki iş MDI pasiflerini datasheet topology'sini koruyarak fiziksel DRC'siz yerleştirmek ve sonra autoroute/ölçüm yapmak.
