kemallaydn/FAC-IO-HARDWARE/ROADMAP.md

# FAC-IO Mini — Roadmap

Status is evidence-based. Passing CAD checks alone is not a production release.

**Active objective:** Robotistan’da montajı yapılabilecek, ESP32-C3 ve iki bağımsız kuru kontak röleli en kısa güvenilir Ethernet kartını tamamla. Mevcut kanıtla en ileri yol dört katmanlı Mini V1 (hazır WIZ850io modülü): KiCad 10.0.8 tam DRC/parity temiz, ERC’de yalnızca J6/J7 kütüphane-kopyası uyumsuzluğu uyarıları var. V1’in Robotistan BOM/PCBA kabulü ve modülün fabrikada takılması doğrulanmadı. İki katmanlı çıplak W5500 Lite V3, 389 tam-seviye DRC uyarısı ve WIZnet MDI uzunluk/via kurallarını karşılamadığı için üretim yolu değil. Hiçbir revizyon üretime hazır ilan edilmedi.

| Phase | Current state | Evidence / exit criteria still needed |
|---|---|---|
| M0 Audit | Complete for current checkout | KiCad 10.0.8 CLI reports saved; current ERC/DRC/parity results in `PROJECT_STATUS.md`. |
| M1 Electrical freeze | Incomplete | Confirm actual 12 V source/environment; close hot PTC and buck thermal/current margin; verify procurement availability, pin/footprints and independent safety review. Screening budget is recorded in `hardware/component-selection-v1.md`, but its assumptions are not a design sign-off. |
| M2 Integrated schematic | CAD complete; electrical approval open | Integrated schematic/netlist and ERC pass; component suitability/startup behavior still need engineering review. |
| M3 Routed PCB | DRAFT-1.2 CAD rule gate passes; physical/layout review open | DRC/parity pass with footprint-filter checks enabled and no ignored PCB DRC checks; protected-input width rule and static GPIO map pass. Confirm carrier stackup, power/return paths, module/enclosure fit and independent review. |
| M4 Manufacturing | Current-source DRAFT review bundle staged | `manufacturing/REVIEW-2026-11-10-DRAFT/` includes fresh Gerbers/Excellon and current ERC/DRC evidence. Its release gate is blocked only on independent approval; fabricator CAM/stackup, slot acceptance and Robotistan acceptance are still open. The Gerbonara G90 warning is explained by the conventional Excellon body command and structurally cross-checked. PCBA sourcing/BOM and assembly require separate checks. |
| M5 Bring-up | Not started | Assemble prototype and record current-limited 12 V, 3.3 V, USB, Ethernet, relay, pulse-width and fault tests. |
| M6 Firmware/integration | Development target builds; not production-ready | `firmware/src/main.cpp` wires bounded HTTP parsing, mbedTLS HMAC-SHA256, physical USB key provisioning/rotation, persistent 256-sequence reservations and fixed OPEN/CLOSE GPIO pulses with a shared 600 ms guard. `firmware/tools/facio_client.py` signs/sends commands and keeps private local sequence state; host tests pass. The ESP32-C3 PlatformIO development build passes. The command server fails closed unless link/DHCP, Secure Boot, flash encryption, NVS and a per-device key are available. Signed production-security build, target/board test, crash fail-off and LPR integration remain open. |

## Lite V3 — paused comparison route (not for manufacturing)

| Phase | Current state | Evidence / exit criteria still needed |
|---|---|---|
| V3-A Architecture | Selected in `hardware/FAC-IO-Lite-V3-architecture.md` | ESP32-C3-WROOM-02-N4 + W5500 + WIZnet J1B1211CCD magjack; one dual CD74HC221; two relays; protected 12 V input. This preserves the firmware target and removes WIZ850io module/socket cost. |
| V3-B Integrated schematic | CAD/ERC complete; electrical approval open | ESP32-C3 + W5500 + J1B1211CCD, power, two relay outputs and dual one-shot are integrated. KiCad 10.0.8 ERC exits 0 with 0 errors/warnings and four listed exclusions. Verify exact datasheets, power/reset fail-off, pulse timing, GPIO map and every purchasable BOM item. |
| V3-C Two-layer PCB | Routed draft exists; MDI/vendor sign-off and routing completeness blocked | Source V3 still passes ERC 0/0 and error-level DRC/parity 0/0/0, but full DRC has 389 silk warnings and source MDI paths violate WIZnet guidance (RX totals 81.81/77.20 mm, via in every MDI net). 2026-11-12 isolated attempts: `mdialign19` is electrically connected and error-DRC clean after 0.20 mm width and local escape repair, but RX P totals ~78.16 mm and MDI vias remain; `mdialign23` shortened RX to ~44–45 mm but leaves 26 opens; `mdialign26` leaves 26 opens and clearance errors; a hybrid merge was rejected at 56 DRC violations and 11 opens. None has schematic parity, independent CAM review or manufacturing outputs. Source CAD unchanged. Evidence in `PROJECT_STATUS.md` latest entry and `/tmp/facio-v3-finalize/`. Required next: integrated placement/routing of PHY, coupling caps, magjack and power, then full DRC/parity, via-free ≤75 mm MDI, silk/return-plane review and CAM. |
  - **2026-11-11 continuation:** Fresh KiCad 10.0.8 source check: ERC 0; error-level DRC/parity 0 errors, 0 opens, 0 parity; full DRC 389 warnings. A manufacturer-reference placement-only copy uses 0402 Ethernet passives and has 0 physical error-level findings after moving U5/crystal; all routing/zones were removed, so it has 183 opens and is not a PCB candidate for manufacturing. Correction from the official J1B1211CCD schematic: R21–R24 are optional series damping locations, shown as 0 Ω; its note says 33 Ω worked best in WIZnet's own EMI tests. V3 omits the optional dampers. Evidence: `validation-reports/lite-v3-continuation-*`, `lite-v3-wiznet-placement-only-*`. Source PCB unchanged.
  - **2026-11-11 follow-up:** A WIZnet PnP-oriented, trackless relayout autorouted from 195 to 0 open connections. Widening to 0.20 mm leaves 13 clearance violations; MDI remains 46–60 mm and 2–3 vias. This is a saved review candidate only, not the V3 source board: `validation-reports/lite-v3-ethernet-relayout-trial*`. WIZnet's <25 mm/via-free MDI guidance and schematic parity are not met/verified.
  - **2026-11-11 follow-up:** A second WIZnet PnP/0402 candidate with bottom and top GND pours reduced GND opens from 16 to 5, but retained 8 clearance errors (0.1517–0.1986 mm vs 0.200 mm) and 5 disconnected top-zone islands. Candidate and DRC evidence: `validation-reports/lite-v3-wiznet-pnp-dualgnd-trial*`; rejected, source board unchanged. No Gerbers/BOM/PnP released. Clearance rules remain unchanged; routing/plane topology still needs correction.
  - **2026-11-12 follow-up:** Rejected `/tmp/facio-v3-mdi90/` after KiCad 3D review: its 90° J7 is placed inside the board, not at an accessible edge. A temporary right-edge placement gives ~18–21 mm MDI pad-center distances but still has one pair-order crossing per pair in straight fanout and courtyard collisions; no routing/parity evidence. J1B1211CCD's exact WIZnet reference shows optional R21–R24 series damping sites, drawn as 0 Ω; the note says 33 Ω worked in WIZnet's own EMI tests. V3 omits these optional parts pending EMI evidence. Source V3 remains unchanged. A new edge-constrained, via-free MDI placement/routing is required.
  - **2026-11-12 follow-up:** `rightedge-tight5` FreeRouting SES imported to a temporary copy and its nine 0.15 mm tracks widened to 0.20 mm. KiCad 10.0.8 refill DRC reports 0 opens but fails with 9 errors: five 12V_IN/12V_FUSED width violations (0.20 vs 0.45 mm) and four relay dry-contact clearances (0.2117–0.2233 vs 0.50 mm). MDI: TXN/TXP 33.19/31.28 mm with 1 via each; PHY RXN/RXP 17.86/15.93 mm with 3/2 vias. The temporary candidate has no valid schematic parity. Rejected; source V3 unchanged and no manufacturing files generated. New MDI/power/relay placement and full reroute required.
  - **2026-11-12 follow-up:** Rotating U6 to 0° on a trackless copy aligns TX pad order with the right-edge J7 and passes placement-only DRC (0 physical errors, 183 opens). FreeRouting 2.5.0 still leaves 11 unrouted items; KiCad import DRC has 55 errors (50 width, 5 contact-clearance), and MDI remains 23–51 mm with 2–4 vias. This orientation-only candidate is rejected. A combined U6/J7/MDI-passive placement is needed; source V3 unchanged.
  - **2026-11-12 follow-up:** Combined orientation trial U6 `(178.5,127.5,180°)` / edge J7 `(204.5,124.5,270°)` aligns all four MDI pairs without a pin-order crossover. Straight pad-center distances are 22.07–24.42 mm, but this is not trace-length/routing proof. Placement-only DRC still has 17 errors (shorts, clearance, mask and courtyard) around the RX passives; 183 opens are intentional on the trackless candidate. Keep working on the integrated PHY termination/coupling placement; source V3 unchanged.
  - **2026-11-12 audit:** Re-ran local KiCad 10.0.8 on current source: ERC 0 errors/warnings; error-level DRC with zone refill and schematic parity 0 errors/opens/parity; full DRC 389 warnings (193 silk overlaps, 190 silk-over-copper, 6 silk-edge). Measured current MDI: TXP/TXN 59.19/49.11 mm with 3/3 vias; RX PHY P/N 39.48/40.41 mm with 4/4 vias; RX cable P/N 42.33/36.79 mm with 1/1 vias. Across their series coupling capacitors, RX total is 81.81/77.20 mm, over WIZnet's 75 mm maximum; all MDI nets contain vias despite the vendor no-via/layer-change requirement. Netlist confirms the V3 RX 6.8 nF coupling and termination topology matches the J1B1211CCD vendor reference. A new trackless placement trial had 37 physical DRC errors and was rejected. Source V3 files remain unchanged; no manufacturing package generated. Reports: `validation-reports/lite-v3-2026-11-12-audit-*`.
| V3-D PCBA | Not started | Reconcile final BOM/PnP against live RobotistanPro identifiers and stock; obtain Robotistan CAM and assembly acceptance. |
| V3-E First article | Not started | Verify power, temperature, Ethernet, reset/brownout, programming, relay fail-off and maximum pulse before barrier connection. |

## Lite V2 status

| Phase | Current state | Evidence / exit criteria still needed |
|---|---|---|
| L0 Architecture | Candidate is WT32-ETH01 + carrier; supply route open | Robotistan lists its WT32-ETH01 stock as sold out; Görsü currently lists stock at 404.51 TL + VAT. Customer-supplied module mounting by Robotistan is not confirmed. Current firmware still needs a port from ESP32-C3 + SPI W5500 to classic ESP32 + LAN8720. |
| L1 Schematic/power | Candidate schematic exists; pad mapping corrected; electrical approval open | `hardware/FAC-IO-Lite-V2.kicad_sch` uses one CD74HC221 dual timer and two RC networks. Current ERC: 0 errors / 0 warnings; netlist confirms OPEN/CLOSE at candidate physical pads 5/6 and programming at 24–26. Report: `validation-reports/lite-v2-schematic-erc.txt`; four excluded checks remain listed. Manufacturer pin tables separate main I/O from debug; the KiCad symbol was corrected to a 26-pad candidate sequence. WT32 footprint and exact revision are unverified; verify sample geometry, power/thermal margin, timer pulse limits, relay isolation and reset-safe behavior. |
| L2 PCB | Not started; no `FAC-IO-Lite-V2.kicad_pcb` file exists | Measure the purchased WT32 exact revision, pad spacing, drill/annular geometry, height and RJ45 edge alignment; then assign the verified footprint, place/route two layers, preserve contact isolation, and pass ERC, DRC, parity and CAM review. |
| L3 PCBA package | Not started | Exact BOM/MPNs/C-codes and PnP reconcile; supplier accepts WT32 as customer-provided assembled item; obtain live price/stock and stackup/assembly confirmation. |
| L4 First article | Not started | Bench-test power, reset/brownout, programming header, Ethernet, both relays and pulse-width maximum before barrier connection. |

V1's phases below are the routed comparison design and remain gated by supplier/physical review. Lite V2 is not yet the selected manufacturing route; it has no PCB or Gerber. The active path will be frozen only after a sourced BOM and assembly route are evidenced.

## Engineering scope

V1: ESP32-C3-WROOM-02-N4 + plug-in WIZnet WIZ850io; 12 V protected input and 3.3 V buck; USB-C debug; two isolated SPDT signal relays with NO/COM/NC terminals. WIZ850io contains W5500, PHY, transformer/magnetics and RJ45. No PoE, RS485, or direct motor/mains switching.

## Immediate next actions

1. Confirm the field 12 V supply tolerance and maximum enclosure ambient; close the PTC, buck loss/temperature and effective input-capacitance calculations against those conditions.
2. Freeze orderable sources/stock and assembly process for the 56 board references and external WIZ850io; verify terminal and socket footprints against physical samples.
3. Obtain independent electrical/CAM review and Robotistan stackup, drill/slot, THT/SMT and sourcing acceptance for `manufacturing/REVIEW-2026-11-10-DRAFT/`.
4. Build a first article and complete the validation matrix. Until these gates pass, the board is not production-ready.
