kemallaydn/FAC-IO-HARDWARE/hardware/netlist-design-v0.csv

Block | Net | From | To | Design requirement | Status
POWER | 12V_IN | J_PWR.1 | FUSE.IN | External 12V input; fuse selected to source | PROVISIONAL
POWER | 12V_RETURN | J_PWR.2 | GND | Input return | PROVISIONAL
POWER | 12V_FUSED | FUSE.OUT | REV_POL.IN | Overcurrent protection | PROVISIONAL
POWER | 12V_PROTECTED | REV_POL.OUT;TVS.CATHODE;BUCK.VIN;K1.COIL_PLUS;K2.COIL_PLUS | COMMON | TVS to GND; reverse polarity and supply transient design required | PROVISIONAL
POWER | 3V3 | BUCK.VOUT;U_MCU.3V3;U_W5500.3V3 | COMMON | Place local bypass and verify W5500 rail requirements | PROVISIONAL
POWER | GND | BUCK.GND;U_MCU.GND;U_W5500.GND;Q1.SOURCE;Q2.SOURCE | COMMON | Do not connect relay dry contacts to logic ground | PROVISIONAL
ETHERNET | ETH_SCK | U_MCU.GPIO4 | U_W5500.SCLK | Review JTAG overlap | PROVISIONAL
ETHERNET | ETH_MOSI | U_MCU.GPIO5 | U_W5500.MOSI | Review JTAG overlap | PROVISIONAL
ETHERNET | ETH_MISO | U_W5500.MISO | U_MCU.GPIO6 | Review JTAG overlap | PROVISIONAL
ETHERNET | ETH_CS_N | U_MCU.GPIO7 | U_W5500.SCSn | External pullup to 3V3 required | PROVISIONAL
ETHERNET | ETH_INT_N | U_W5500.INTn | U_MCU.GPIO10 | Pullup and input configuration per W5500 datasheet | PROVISIONAL
ETHERNET | ETH_RST_N | U_MCU.GPIO3 | U_W5500.RSTn | Power-on reset and pullup timing per datasheet | PROVISIONAL
ETHERNET | ETH_PHY | U_W5500.TXRX | J_RJ45.MAGNETICS | Use full manufacturer reference schematic; this row is NOT a complete circuit | INCOMPLETE
RELAY1 | RELAY1_DRV | U_MCU.GPIO0 | R_GATE1 -> Q1.GATE | External pulldown ensures default OFF | PROVISIONAL
RELAY1 | RELAY1_COIL | Q1.DRAIN | K1.COIL_MINUS | Flyback diode across K1 coil | PROVISIONAL
RELAY1 | RELAY1_CONTACT | K1.COM;K1.NO;K1.NC | J_RLY1.COM;J_RLY1.NO;J_RLY1.NC | Dry contact isolated from logic supply | PROVISIONAL
RELAY2 | RELAY2_DRV | U_MCU.GPIO1 | R_GATE2 -> Q2.GATE | External pulldown ensures default OFF | PROVISIONAL
RELAY2 | RELAY2_COIL | Q2.DRAIN | K2.COIL_MINUS | Flyback diode across K2 coil | PROVISIONAL
RELAY2 | RELAY2_CONTACT | K2.COM;K2.NO;K2.NC | J_RLY2.COM;J_RLY2.NO;J_RLY2.NC | Dry contact isolated from logic supply | PROVISIONAL
USB | USB_DN | J_USB.D- | U_MCU.GPIO18 | USB ESD and USB-C wiring required | PROVISIONAL
USB | USB_DP | J_USB.D+ | U_MCU.GPIO19 | USB ESD and USB-C wiring required | PROVISIONAL
USB | USB_CC1 | J_USB.CC1 | R_CC1 -> GND | 5.1k nominal Rd verify USB-C design | PROVISIONAL
USB | USB_CC2 | J_USB.CC2 | R_CC2 -> GND | 5.1k nominal Rd verify USB-C design | PROVISIONAL
BOOT | BOOT_N | U_MCU.GPIO9 | SW_BOOT -> GND | GPIO9 strap with pullup and accessible recovery | PROVISIONAL
BOOT | EN | U_MCU.EN | SW_RESET -> GND | EN pullup and RC per Espressif guidelines | PROVISIONAL
