kemallaydn/FAC-IO-HARDWARE/hardware/bom-draft.csv

Reference | Quantity | Value | Footprint | Manufacturer MPN | RobotistanPro/LCSC C Code | Populate | Status
C1 | 1 | 22uF/50V | Capacitor_SMD:C_1210_3225Metric | C3225X7R1H226M250AC |  | YES | TDK 22uF/50V X7R 1210; input-bank DC-bias/temp/tolerance calculation and supplier availability remain to confirm
C2 | 1 | 10uF/50V | Capacitor_SMD:C_1206_3216Metric | CGA5L1X7R1H106K160AC |  | YES | TDK 10uF/50V X7R 1206; input-bank DC-bias/temp/tolerance calculation and supplier availability remain to confirm
C3 | 1 | 100nF/50V | Capacitor_SMD:C_0603_1608Metric | CC0603JRX7R9BB104 | C91183 | YES | Exact value/package alternative; LCSC catalog stock observed 2026-11-10; Robotistan sourcing and assembly acceptance still unconfirmed
C4 | 1 | 22uF/10V | Capacitor_SMD:C_0805_2012Metric | GRM21BZ71A226ME15L | C907991 | YES | LCSC code C907991 maps to exact manufacturer MPN GRM21BZ71A226ME15L; current stock, Robotistan procurement import and assembly acceptance remain unverified
C5 | 1 | 22uF/10V | Capacitor_SMD:C_0805_2012Metric | GRM21BZ71A226ME15L | C907991 | YES | LCSC code C907991 maps to exact manufacturer MPN GRM21BZ71A226ME15L; current stock, Robotistan procurement import and assembly acceptance remain unverified
C6 | 1 | 1uF | Capacitor_SMD:C_0805_2012Metric | GRM21BR71C105KA01L | C77079 | YES | LCSC code C77079 maps to exact manufacturer MPN GRM21BR71C105KA01L; current stock, Robotistan procurement import and assembly acceptance remain unverified
C7 | 1 | 10uF | Capacitor_SMD:C_0805_2012Metric | GRM21BZ71E106KE15L | C237493 | YES | LCSC code C237493 maps to exact manufacturer MPN GRM21BZ71E106KE15L; current stock, Robotistan procurement import and assembly acceptance remain unverified
C8 | 1 | 100nF/50V | Capacitor_SMD:C_0603_1608Metric | CC0603JRX7R9BB104 | C91183 | YES | Exact value/package alternative; LCSC catalog stock observed 2026-11-10; Robotistan sourcing and assembly acceptance still unconfirmed
C9 | 1 | 1nF/2kV | Capacitor_SMD:C_1206_3216Metric | CC1206KKX7RDBB102 | C23631 | YES | Exact value/package alternative; LCSC catalog stock observed 2026-11-10; Robotistan sourcing and assembly acceptance still unconfirmed
C28 | 1 | 100nF/100V | Capacitor_SMD:C_0805_2012Metric | C0805C104K1RACAUTO | C141125 | YES | Exact value/package alternative; LCSC catalog stock observed 2026-11-10; Robotistan sourcing and assembly acceptance still unconfirmed
C29 | 1 | 100nF/100V | Capacitor_SMD:C_0805_2012Metric | C0805C104K1RACAUTO | C141125 | YES | Exact value/package alternative; LCSC catalog stock observed 2026-11-10; Robotistan sourcing and assembly acceptance still unconfirmed
C30 | 1 | 100nF/50V | Capacitor_SMD:C_0603_1608Metric | CC0603JRX7R9BB104 | C91183 | YES | Exact value/package alternative; LCSC catalog stock observed 2026-11-10; Robotistan sourcing and assembly acceptance still unconfirmed
D1 | 1 | SS34 | Diode_SMD:D_SMA | B340A-13-F | C85098 | YES | LCSC code C85098 maps to exact manufacturer MPN B340A-13-F; current stock, Robotistan procurement import and assembly acceptance remain unverified
D2 | 1 | SMCJ15A-13-F | Diode_SMD:D_SMC | SMCJ15A-13-F | C135138 | YES | LCSC C135138 maps to exact Diodes Incorporated MPN SMCJ15A-13-F; procurement import, current stock and assembly acceptance remain unverified
D3 | 1 | 1N4007G | Diode_THT:D_DO-41_SOD81_P10.16mm_Horizontal | 1N4007G-T | C516593 | YES | LCSC code C516593 maps to exact manufacturer MPN 1N4007G-T; current stock, Robotistan procurement import and assembly acceptance remain unverified
D4 | 1 | 1N4007G | Diode_THT:D_DO-41_SOD81_P10.16mm_Horizontal | 1N4007G-T | C516593 | YES | LCSC code C516593 maps to exact manufacturer MPN 1N4007G-T; current stock, Robotistan procurement import and assembly acceptance remain unverified
F1 | 1 | 1812L075/33DR | Fuse:Fuse_1812_4532Metric | 1812L075/33DR | C151170 | YES | LCSC C151170 maps to exact Littelfuse MPN 1812L075/33DR; catalog stock/import listing is not Robotistan procurement confirmation; thermal/load validation remains open
J1 | 1 | TB007-508-02BE | TerminalBlock_CUI:TerminalBlock_CUI_TB007-508-02_1x02_P5.08mm_Horizontal | TB007-508-02BE | C3816270 | YES | Exact CUI TB007-508-02BE catalog code C3816270; Robotistan purchase/import, stock and assembly acceptance remain open
J2 | 1 | TYPE-C-31-M-12 | Connector_USB:USB_C_Receptacle_HRO_TYPE-C-31-M-12 | TYPE-C-31-M-12 | C165948 | YES | LCSC C165948 maps to exact HRO MPN TYPE-C-31-M-12; procurement import, current stock and assembly acceptance remain unverified
J4 | 1 | TB007-508-03BE | TerminalBlock_CUI:TerminalBlock_CUI_TB007-508-03_1x03_P5.08mm_Horizontal | TB007-508-03BE | C3820511 | YES | Exact CUI TB007-508-03BE catalog code C3820511; Robotistan purchase/import, stock and assembly acceptance remain open
J5 | 1 | TB007-508-03BE | TerminalBlock_CUI:TerminalBlock_CUI_TB007-508-03_1x03_P5.08mm_Horizontal | TB007-508-03BE | C3820511 | YES | Exact CUI TB007-508-03BE catalog code C3820511; Robotistan purchase/import, stock and assembly acceptance remain open
J6 | 1 | SSQ-106-03-G-S | FAC_IO:WIZ850io_Host_J1_Socket_1x06 | SSQ-106-03-G-S | C3323798 | YES | LCSC C3323798 maps to exact Samtec MPN SSQ-106-03-G-S; procurement import, current stock, mating and assembly acceptance remain unverified
J7 | 1 | SSQ-106-03-G-S | FAC_IO:WIZ850io_Host_J2_Socket_1x06 | SSQ-106-03-G-S | C3323798 | YES | LCSC C3323798 maps to exact Samtec MPN SSQ-106-03-G-S; procurement import, current stock, mating and assembly acceptance remain unverified
K1 | 1 | G6K-2P-Y DC12 | Relay_THT:Relay_DPDT_Omron_G6K-2P-Y | G6K-2P-Y DC12 | C132367 | YES | LCSC C132367 maps to exact manufacturer MPN G6K-2P-Y DC12; Robotistan import, current stock, procurement and assembly acceptance remain unverified
K2 | 1 | G6K-2P-Y DC12 | Relay_THT:Relay_DPDT_Omron_G6K-2P-Y | G6K-2P-Y DC12 | C132367 | YES | LCSC C132367 maps to exact manufacturer MPN G6K-2P-Y DC12; Robotistan import, current stock, procurement and assembly acceptance remain unverified
L1 | 1 | XAL5050-472MEC | Inductor_SMD:L_Coilcraft_XAL5050-XXX | XAL5050-472MEC |  | YES | MPN matched to schematic; Robotistan purchase code, stock and assembly acceptance open
Q1 | 1 | AO3400A | Package_TO_SOT_SMD:SOT-23 | AO3400A | C20917 | YES | LCSC code C20917 maps to exact manufacturer MPN AO3400A; current stock, Robotistan procurement import and assembly acceptance remain unverified
Q2 | 1 | AO3400A | Package_TO_SOT_SMD:SOT-23 | AO3400A | C20917 | YES | LCSC code C20917 maps to exact manufacturer MPN AO3400A; current stock, Robotistan procurement import and assembly acceptance remain unverified
R1 | 1 | 10k | Resistor_SMD:R_0603_1608Metric | RC0603FR-0710KL | C98220 | YES | LCSC code C98220 maps to exact RC0603FR-0710KL 0603 YAGEO part; current stock, Robotistan procurement import and assembly acceptance remain unverified
R2 | 1 | 10k | Resistor_SMD:R_0603_1608Metric | RC0603FR-0710KL | C98220 | YES | LCSC code C98220 maps to exact RC0603FR-0710KL 0603 YAGEO part; current stock, Robotistan procurement import and assembly acceptance remain unverified
R3 | 1 | 5.1k | Resistor_SMD:R_0603_1608Metric | RC0603FR-075K1L | C105580 | YES | LCSC code C105580 maps to exact RC0603FR-075K1L 0603 YAGEO part; current stock, Robotistan procurement import and assembly acceptance remain unverified
R4 | 1 | 5.1k | Resistor_SMD:R_0603_1608Metric | RC0603FR-075K1L | C105580 | YES | LCSC code C105580 maps to exact RC0603FR-075K1L 0603 YAGEO part; current stock, Robotistan procurement import and assembly acceptance remain unverified
R5 | 1 | 22R | Resistor_SMD:R_0603_1608Metric | RC0603FR-0722RL | C107701 | YES | LCSC code C107701 maps to exact RC0603FR-0722RL 0603 YAGEO part; current stock, Robotistan procurement import and assembly acceptance remain unverified
R6 | 1 | 22R | Resistor_SMD:R_0603_1608Metric | RC0603FR-0722RL | C107701 | YES | LCSC code C107701 maps to exact RC0603FR-0722RL 0603 YAGEO part; current stock, Robotistan procurement import and assembly acceptance remain unverified
R7 | 1 | 68k | Resistor_SMD:R_0603_1608Metric | RC0603FR-0768KL | C114633 | YES | LCSC code C114633 maps to exact RC0603FR-0768KL 0603 YAGEO part; current stock, Robotistan procurement import and assembly acceptance remain unverified
R8 | 1 | 100k | Resistor_SMD:R_0603_1608Metric | RC0603FR-07100KL | C14675 | YES | LCSC code C14675 maps to exact RC0603FR-07100KL 0603 YAGEO part; current stock, Robotistan procurement import and assembly acceptance remain unverified
R10 | 1 | 10k | Resistor_SMD:R_0603_1608Metric | RC0603FR-0710KL | C98220 | YES | LCSC code C98220 maps to exact RC0603FR-0710KL 0603 YAGEO part; current stock, Robotistan procurement import and assembly acceptance remain unverified
R11 | 1 | 10k | Resistor_SMD:R_0603_1608Metric | RC0603FR-0710KL | C98220 | YES | LCSC code C98220 maps to exact RC0603FR-0710KL 0603 YAGEO part; current stock, Robotistan procurement import and assembly acceptance remain unverified
R12 | 1 | 10k | Resistor_SMD:R_0603_1608Metric | RC0603FR-0710KL | C98220 | YES | LCSC code C98220 maps to exact RC0603FR-0710KL 0603 YAGEO part; current stock, Robotistan procurement import and assembly acceptance remain unverified
R20 | 1 | 100k | Resistor_SMD:R_0603_1608Metric | RC0603FR-07100KL | C14675 | YES | LCSC code C14675 maps to exact RC0603FR-07100KL 0603 YAGEO part; current stock, Robotistan procurement import and assembly acceptance remain unverified
R21 | 1 | 100k | Resistor_SMD:R_0603_1608Metric | RC0603FR-07100KL | C14675 | YES | LCSC code C14675 maps to exact RC0603FR-07100KL 0603 YAGEO part; current stock, Robotistan procurement import and assembly acceptance remain unverified
R23 | 1 | 768k | Resistor_SMD:R_0603_1608Metric | RC0603FR-07768KL | C482916 | YES | LCSC code C482916 maps to exact RC0603FR-07768KL 0603 YAGEO part; current stock, Robotistan procurement import and assembly acceptance remain unverified
R24 | 1 | 768k | Resistor_SMD:R_0603_1608Metric | RC0603FR-07768KL | C482916 | YES | LCSC code C482916 maps to exact RC0603FR-07768KL 0603 YAGEO part; current stock, Robotistan procurement import and assembly acceptance remain unverified
R25 | 1 | 1k | Resistor_SMD:R_0603_1608Metric | RC0603FR-071KL | C22548 | YES | LCSC code C22548 maps to exact RC0603FR-071KL 0603 YAGEO part; current stock, Robotistan procurement import and assembly acceptance remain unverified
R26 | 1 | 100k | Resistor_SMD:R_0603_1608Metric | RC0603FR-07100KL | C14675 | YES | LCSC code C14675 maps to exact RC0603FR-07100KL 0603 YAGEO part; current stock, Robotistan procurement import and assembly acceptance remain unverified
R27 | 1 | 1k | Resistor_SMD:R_0603_1608Metric | RC0603FR-071KL | C22548 | YES | LCSC code C22548 maps to exact RC0603FR-071KL 0603 YAGEO part; current stock, Robotistan procurement import and assembly acceptance remain unverified
R28 | 1 | 100k | Resistor_SMD:R_0603_1608Metric | RC0603FR-07100KL | C14675 | YES | LCSC code C14675 maps to exact RC0603FR-07100KL 0603 YAGEO part; current stock, Robotistan procurement import and assembly acceptance remain unverified
R29 | 1 | 1M | Resistor_SMD:R_0603_1608Metric | RC0603FR-071ML | C105578 | YES | LCSC code C105578 maps to exact RC0603FR-071ML 0603 YAGEO part; current stock, Robotistan procurement import and assembly acceptance remain unverified
R30 | 1 | 523k | Resistor_SMD:R_0603_1608Metric | RC0603FR-07523KL | C185324 | YES | JLCPCB catalog code C185324 maps to exact RC0603FR-07523KL 0603 YAGEO part; current stock, Robotistan procurement import and assembly acceptance remain unverified
SW1 | 1 | RESET | Button_Switch_SMD:SW_SPST_TL3342 | TL3342F100QG |  | YES | E-Switch TL3342F100QG; current configuration, 1M-cycle; lead time/MOQ and Robotistan sourcing open
SW2 | 1 | BOOT | Button_Switch_SMD:SW_SPST_TL3342 | TL3342F100QG |  | YES | E-Switch TL3342F100QG; current configuration, 1M-cycle; lead time/MOQ and Robotistan sourcing open
U1 | 1 | AP63203WU-7 | Package_TO_SOT_SMD:TSOT-23-6 | AP63203WU-7 | C780769 | YES | LCSC code C780769 maps to exact manufacturer MPN AP63203WU-7; current stock, Robotistan procurement import and assembly acceptance remain unverified
U2 | 1 | ESP32-C3-WROOM-02-N4 | FAC_IO:ESP32-C3-WROOM-02_0p3mmThermal | ESP32-C3-WROOM-02-N4 | C2934560 | YES | LCSC C2934560 maps to exact manufacturer MPN ESP32-C3-WROOM-02-N4; Robotistan import, current stock, procurement and assembly acceptance remain unverified
U3 | 1 | USBLC6-2SC6 | Package_TO_SOT_SMD:SOT-23-6 | USBLC6-2SC6 | C7519 | YES | LCSC code C7519 maps to exact manufacturer MPN USBLC6-2SC6; current stock, Robotistan procurement import and assembly acceptance remain unverified
U5 | 1 | LTC6993IS6-1 | Package_TO_SOT_SMD:TSOT-23-6 | LTC6993IS6-1#TRMPBF | C581045 | YES | LCSC code C581045 maps to exact manufacturer MPN LTC6993IS6-1#TRMPBF; current stock, Robotistan procurement import and assembly acceptance remain unverified
U6 | 1 | LTC6993IS6-1 | Package_TO_SOT_SMD:TSOT-23-6 | LTC6993IS6-1#TRMPBF | C581045 | YES | LCSC code C581045 maps to exact manufacturer MPN LTC6993IS6-1#TRMPBF; current stock, Robotistan procurement import and assembly acceptance remain unverified
