kemallaydn/FAC-IO-HARDWARE/manufacturing/DRAFT-2026-11-09-DRAFT-0.7/bom/external-items.csv

Item | MPN | Qty | Assembly | Notes
Ethernet module | WIZnet WIZ850io | 1 | Off-board / field-installed | Module supplied separately; mate fit and assembly method unverified
