kemallaydn/FAC-IO-HARDWARE/manufacturing/REVIEW-2026-11-10-PCBA-DRAFT/bom/external-items.csv

Item | MPN | RobotistanPro/LCSC C Code | Qty | Assembly | Notes
EXT1 | WIZnet WIZ850io | C134462 | 1 | Required factory final assembly | Source with PCBA order and plug into installed J6/J7 sockets before shipment; not a customer installation step. Confirm Robotistan accepts manual insertion of this through-hole module in the PCBA flow.
