kemallaydn/FAC-IO-HARDWARE/manufacturing/REVIEW-2026-11-10-PCBA-DRAFT/review/robotistan-bom-preview.png

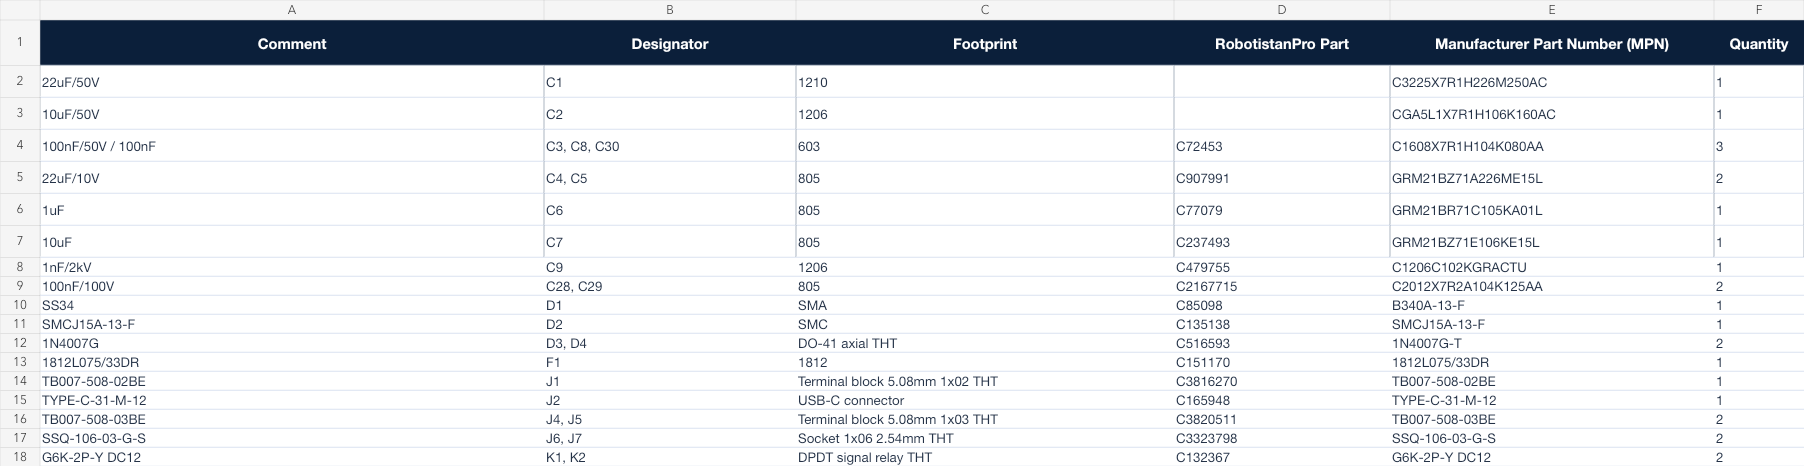
manufacturing/REVIEW-2026-11-10-PCBA-DRAFT/review/robotistan-bom-preview.png
