kemallaydn/FAC-IO-HARDWARE/manufacturing/DRAFT-2026-11-09-DRAFT-0.9/board-top.png

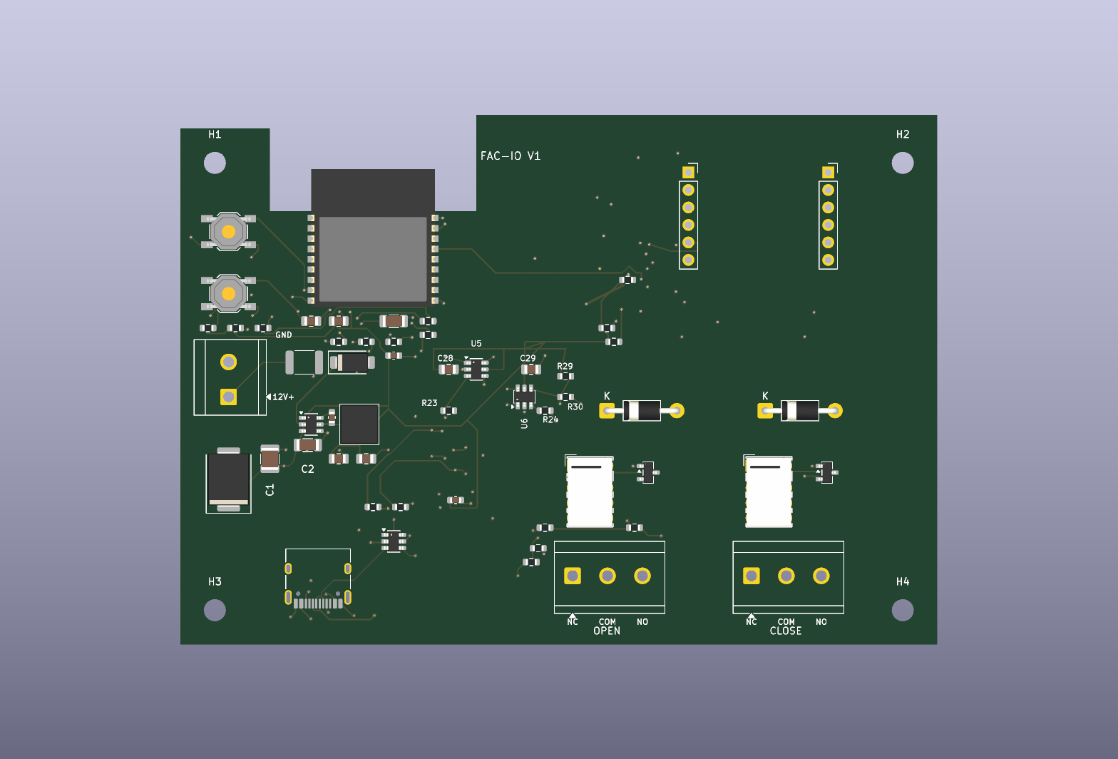
manufacturing/DRAFT-2026-11-09-DRAFT-0.9/board-top.png
