kemallaydn/FAC-IO-HARDWARE/manufacturing/DRAFT-2026-11-09-DRAFT-0.5/schematic.pdf

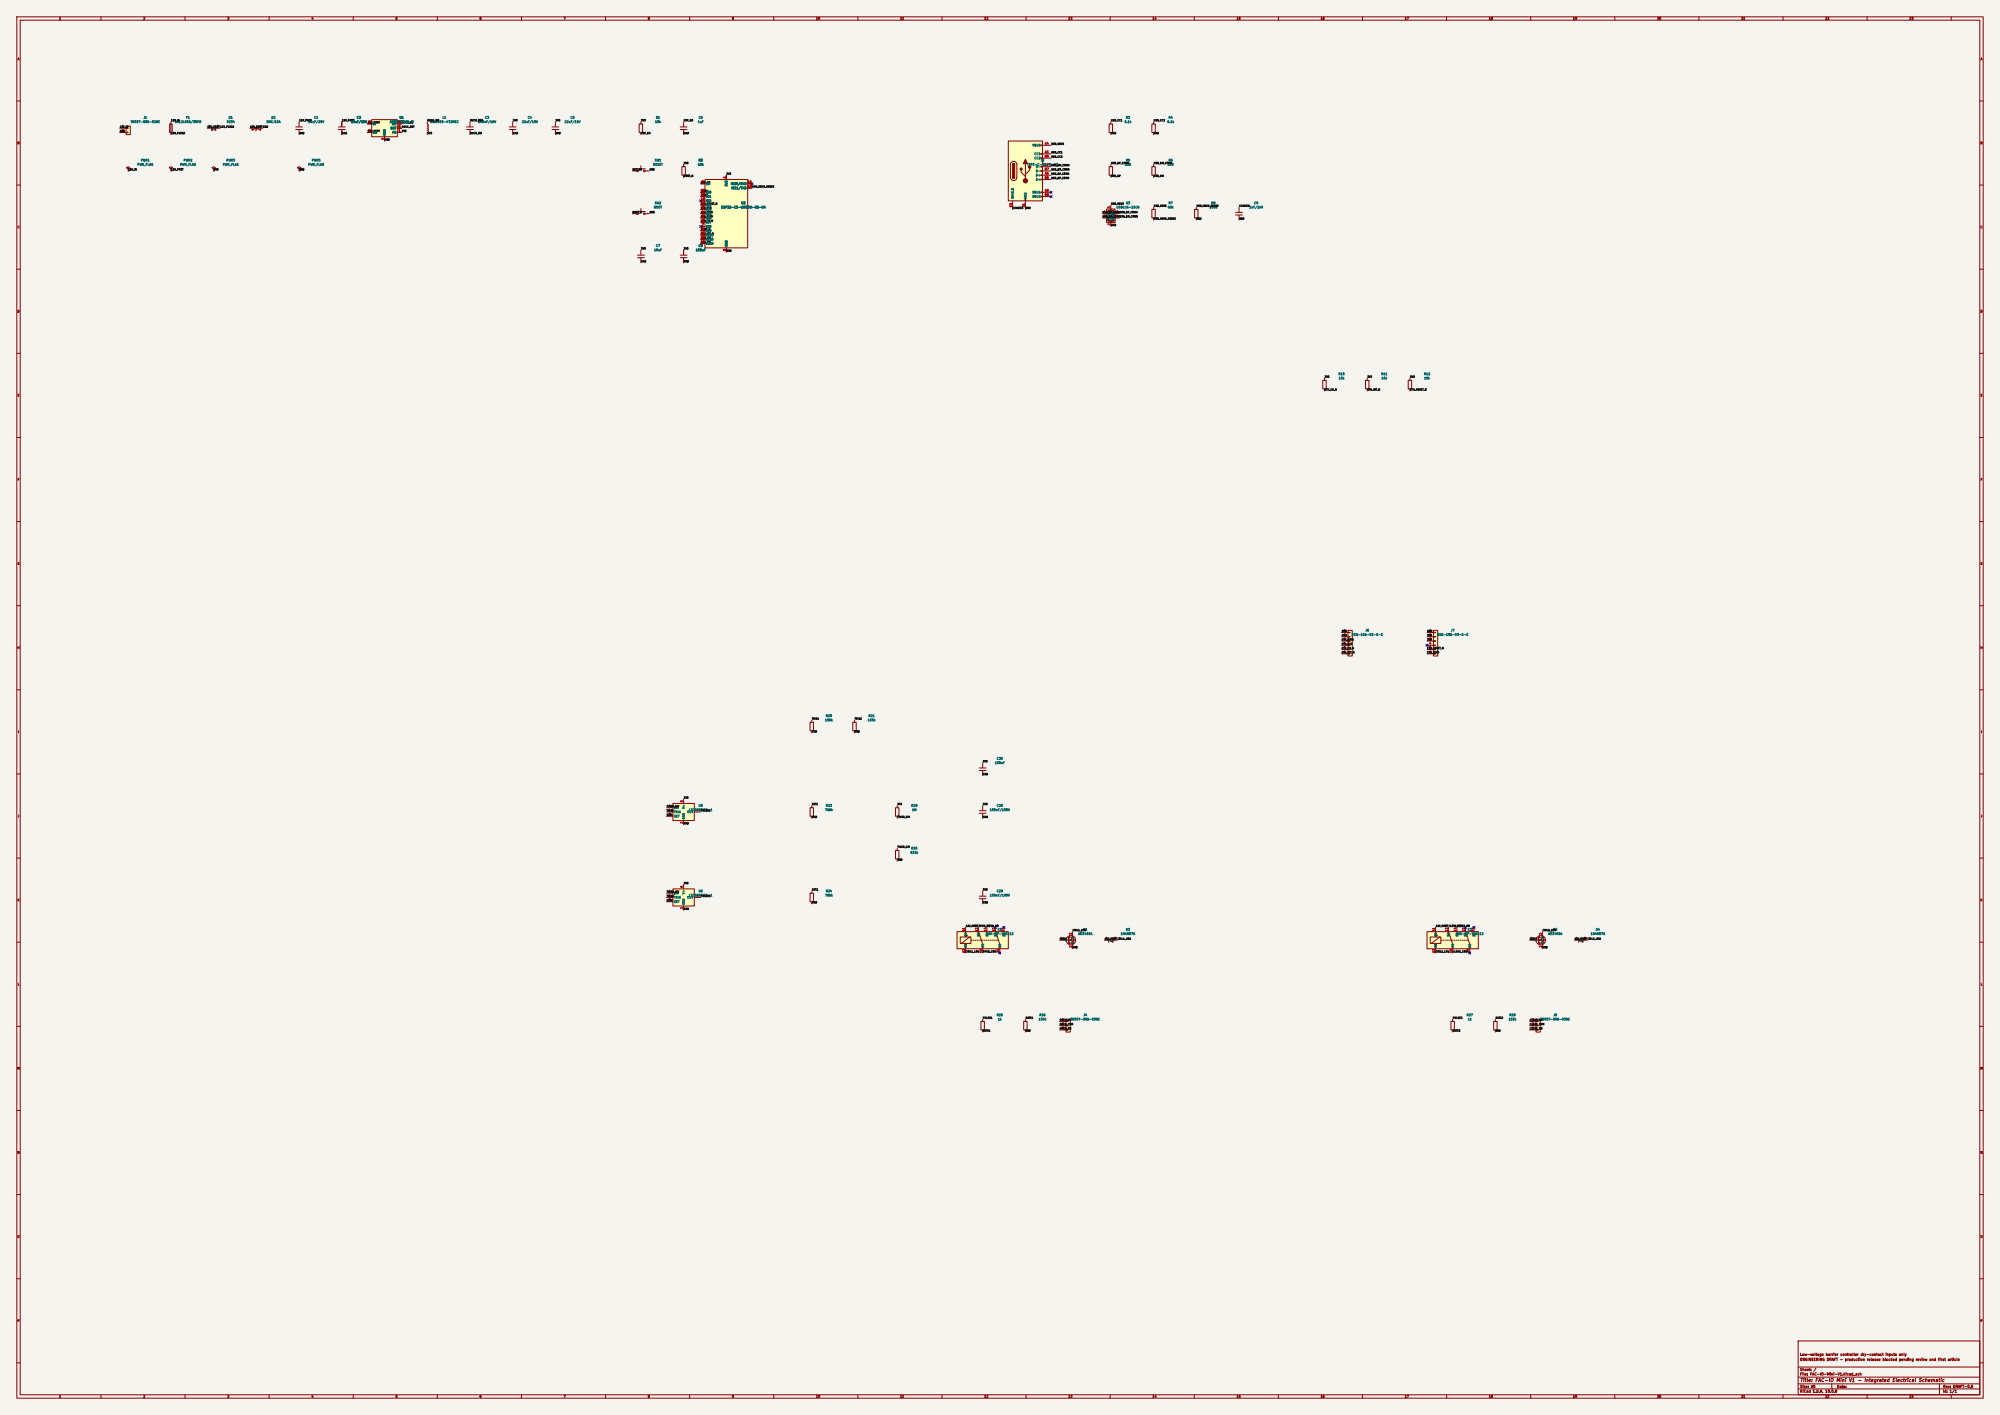
[picture p5: page 1]

Low-voltage barrier controller dry-contact inputs only
ENGINEERING DRAFT - production release blocked pending review and first article

Sheet: /
File: FAC-IO-Mini-V1.kicad_sch
Title: FAC-IO Mini V1 - Integrated Electrical Schematic

Size: A0 | Rev: DRAFT-0.5
KiCad E.D.A. 10.0.8 | Id: 1/1
