kemallaydn/FAC-IO-HARDWARE/manufacturing/DRAFT-2026-11-09-WIZ850io/schematic.pdf

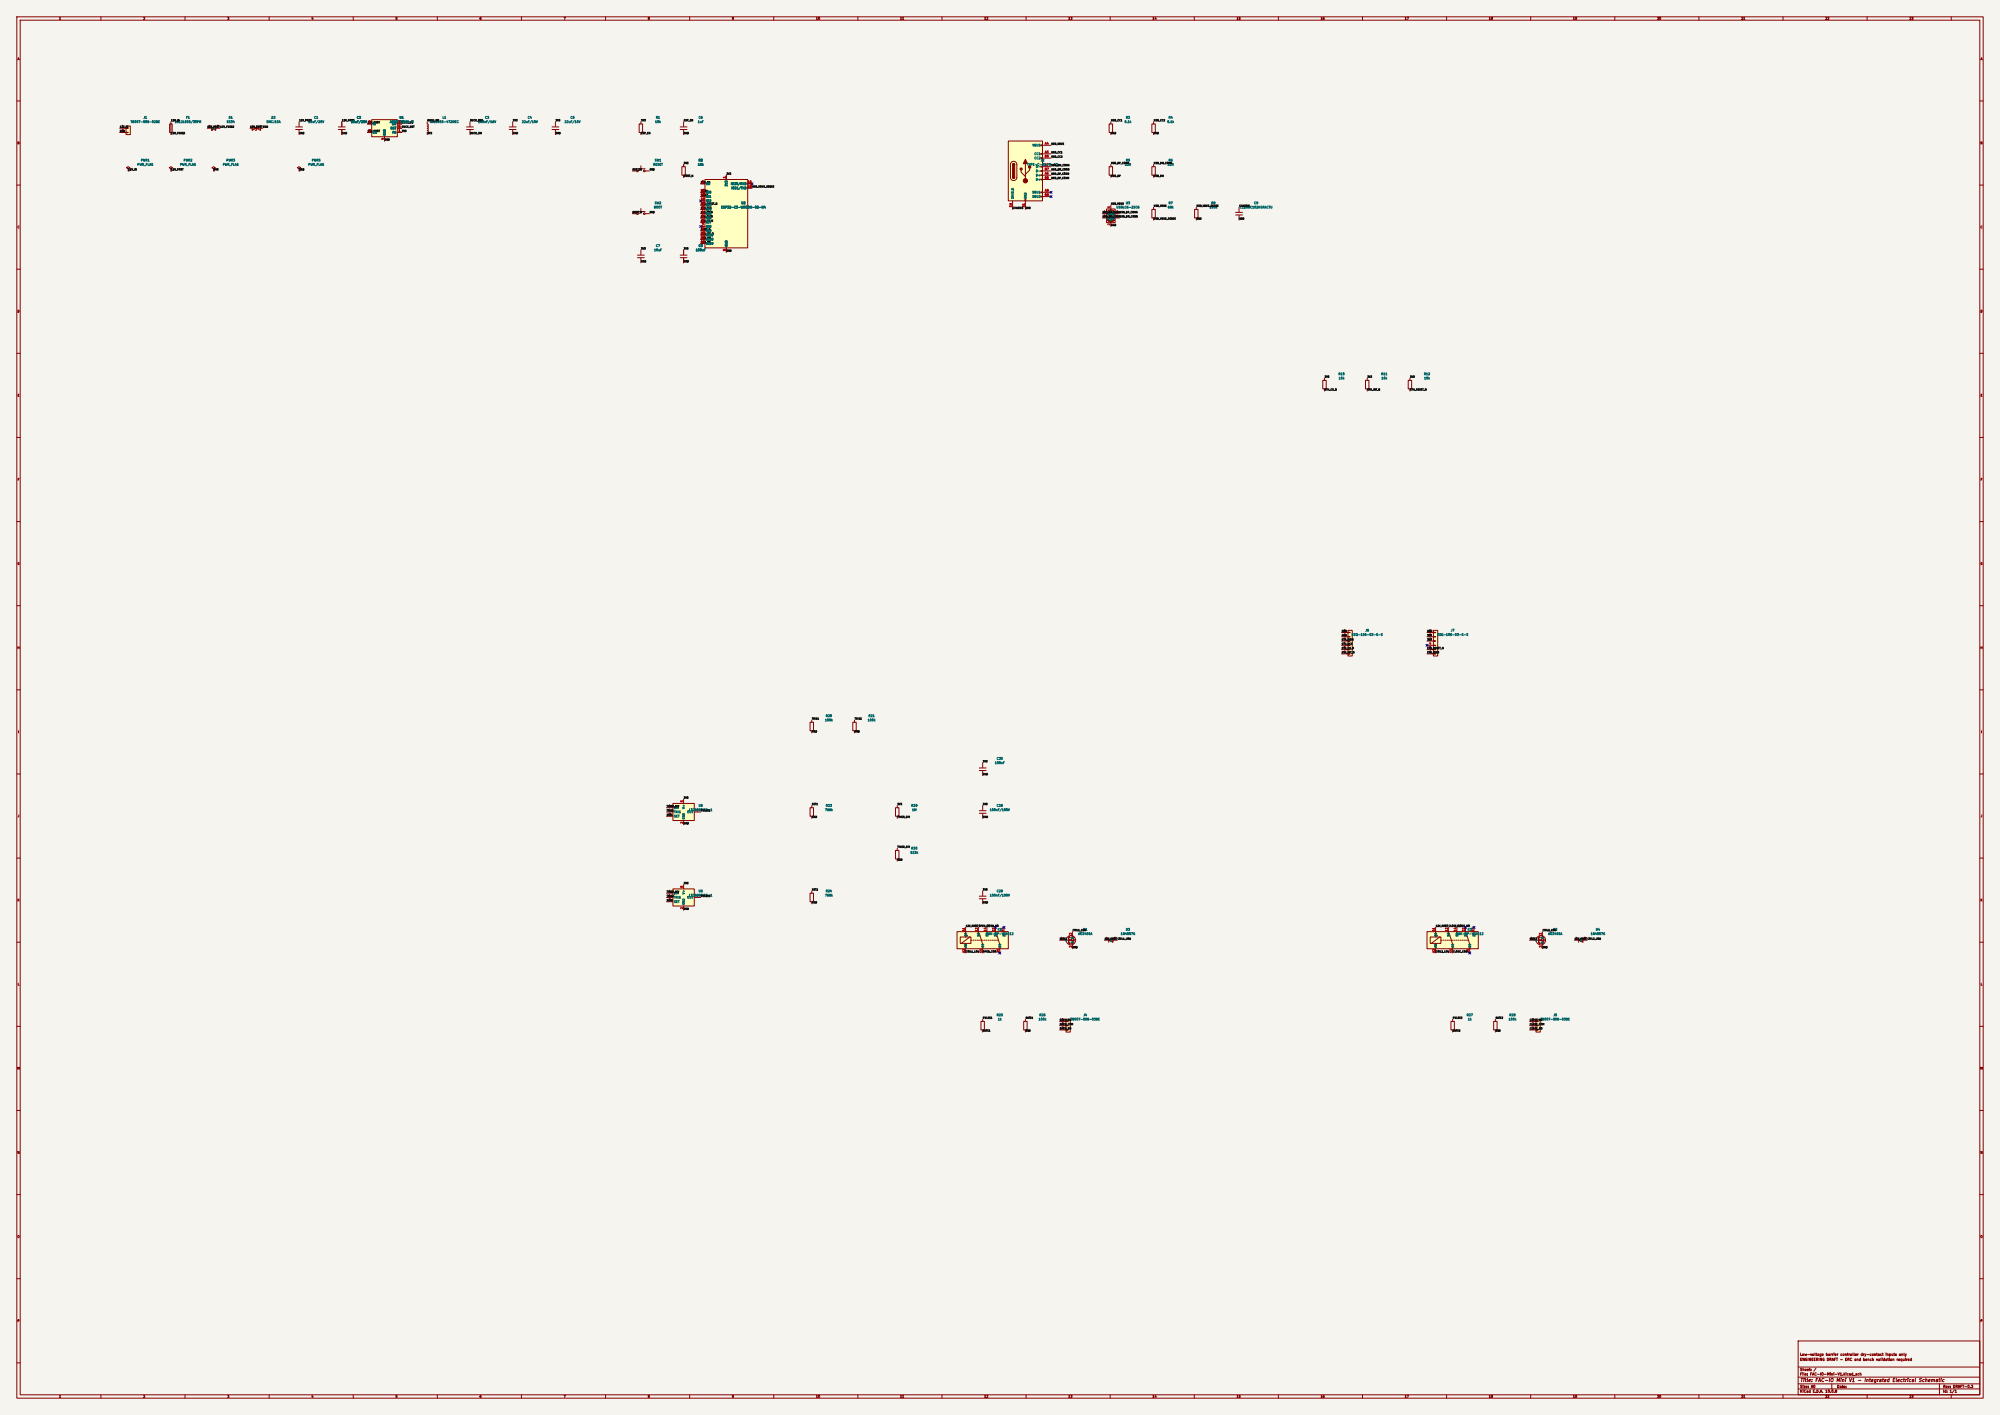
[picture p6: page 1]

Low-voltage barrier controller dry-contact inputs only
ENGINEERING DRAFT - ERC and bench validation required

Sheet: /
File: FAC-IO-Mini-V1.kicad_sch
Title: FAC-IO Mini V1 - Integrated Electrical Schematic

Size: A0 | Rev: DRAFT-0.3
KiCad E.D.A. 10.0.8 | Id: 1/1
