kemallaydn/FAC-IO-HARDWARE/manufacturing/DRAFT-2026-11-08/DRAFT-assembly-front.pdf

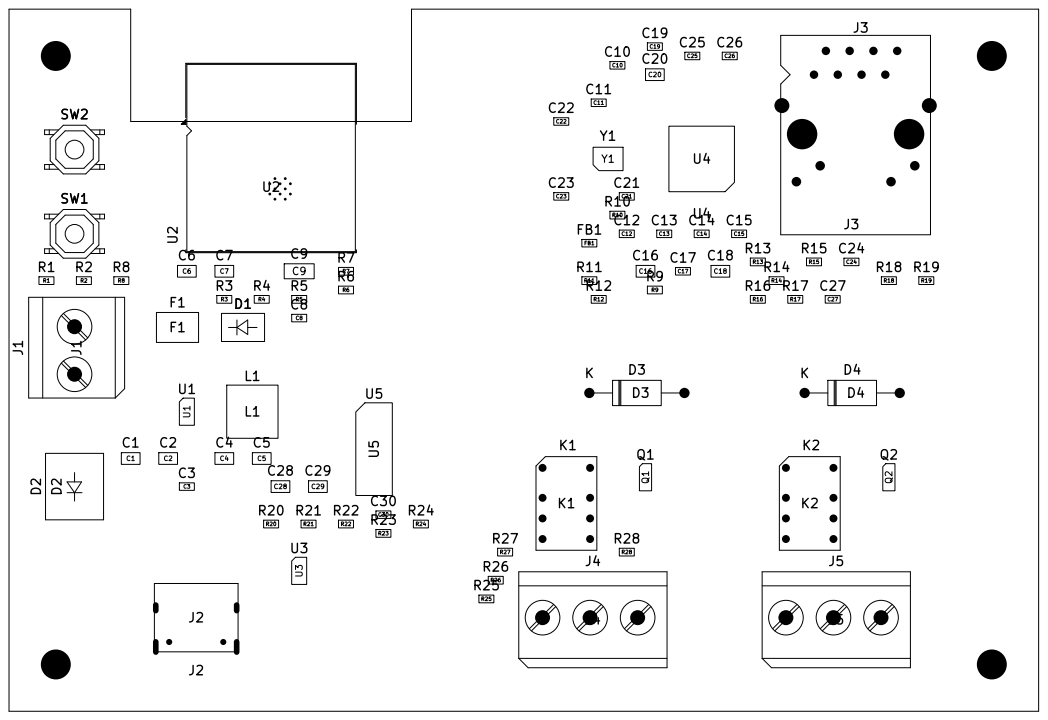
[picture p7: page 1]
