kemallaydn/FAC-IO-HARDWARE/manufacturing/DRAFT-2026-11-09-DRAFT-0.5/assembly-front.pdf

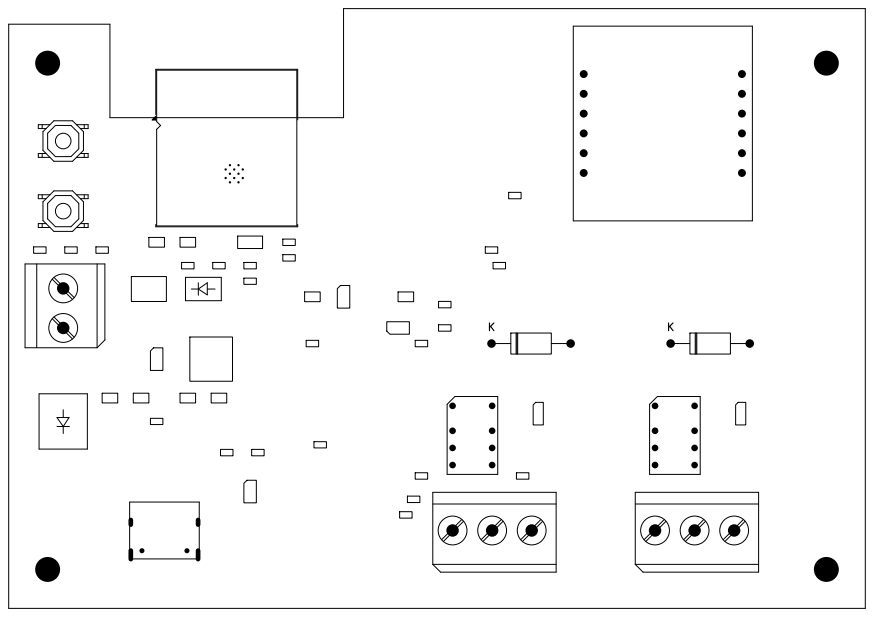
[picture p8: page 1]
