kemallaydn/FAC-IO-HARDWARE/manufacturing/DRAFT-2026-11-09-DRAFT-0.9/assembly-top.pdf

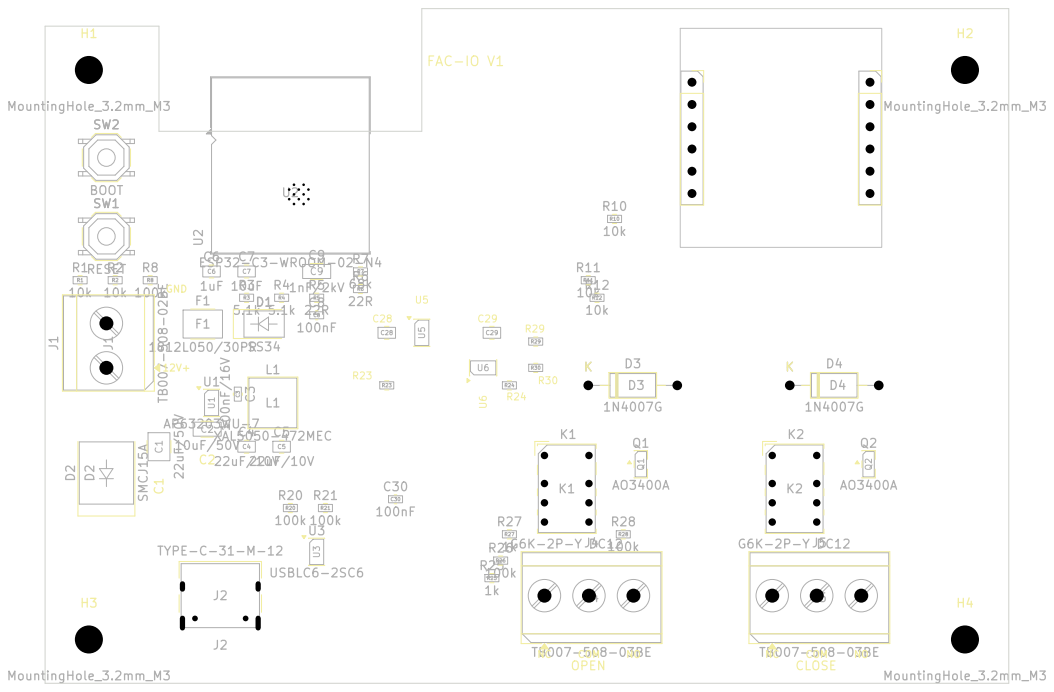
[picture p13: page 1]
