kemallaydn/FAC-IO-HARDWARE/manufacturing/DRAFT-2026-11-09-DRAFT-1.0/assembly-top.pdf

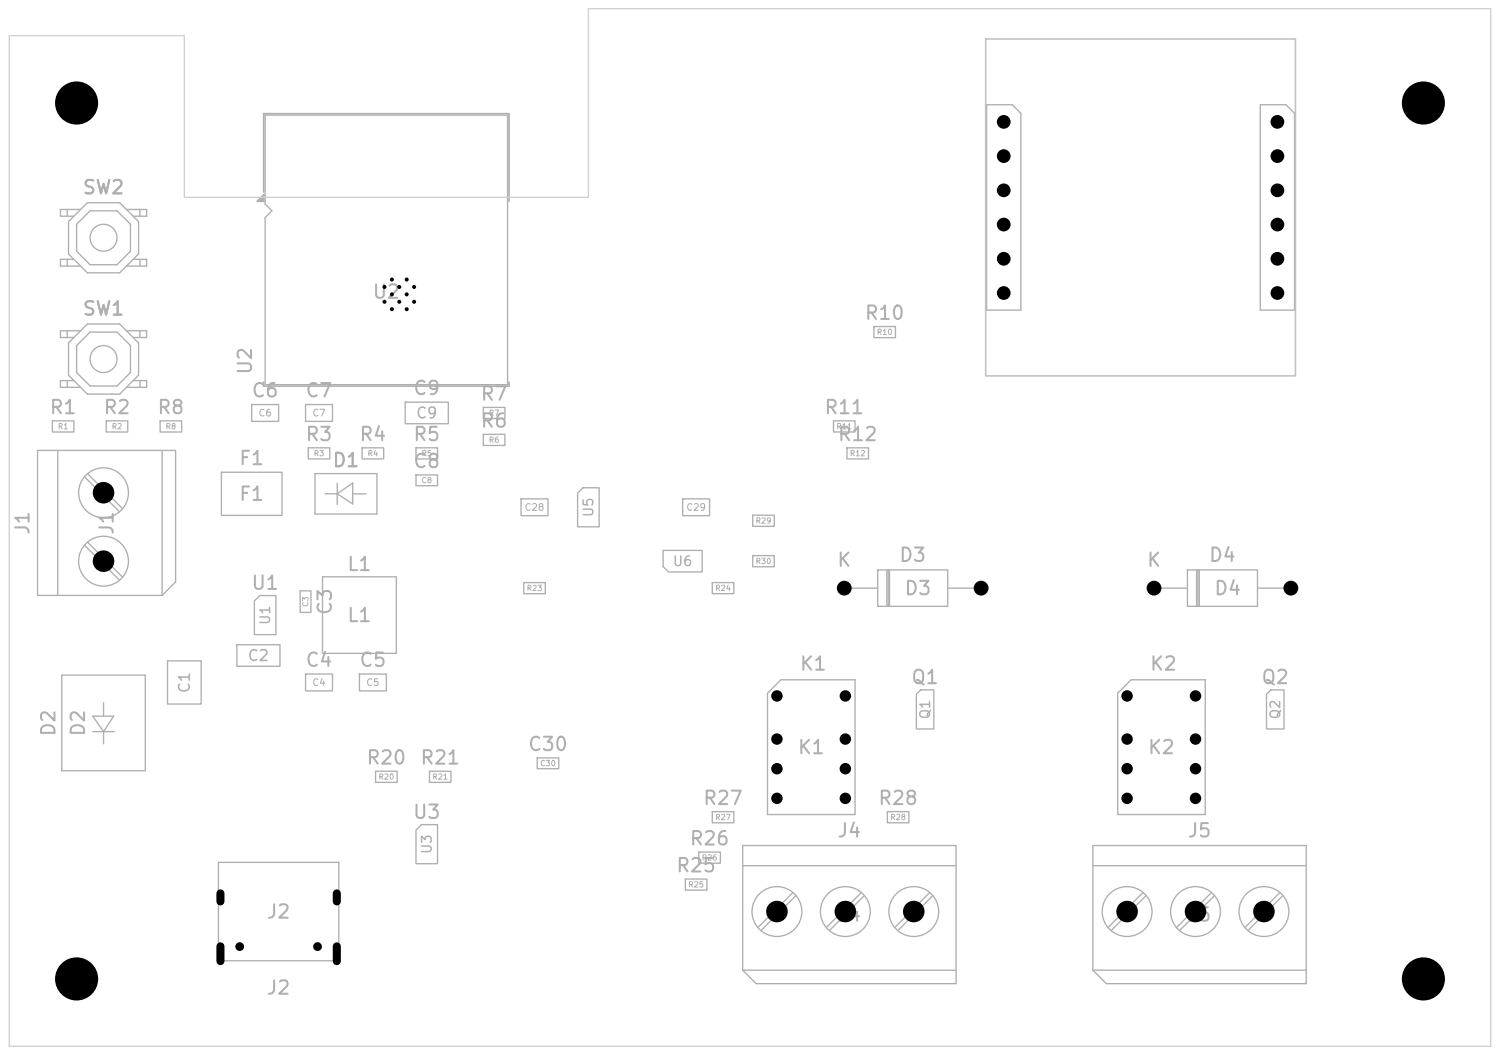
[picture p14: page 1]
