kemallaydn/FAC-IO-HARDWARE/manufacturing/DRAFT-2026-11-09-DRAFT-1.2/assembly-top.pdf

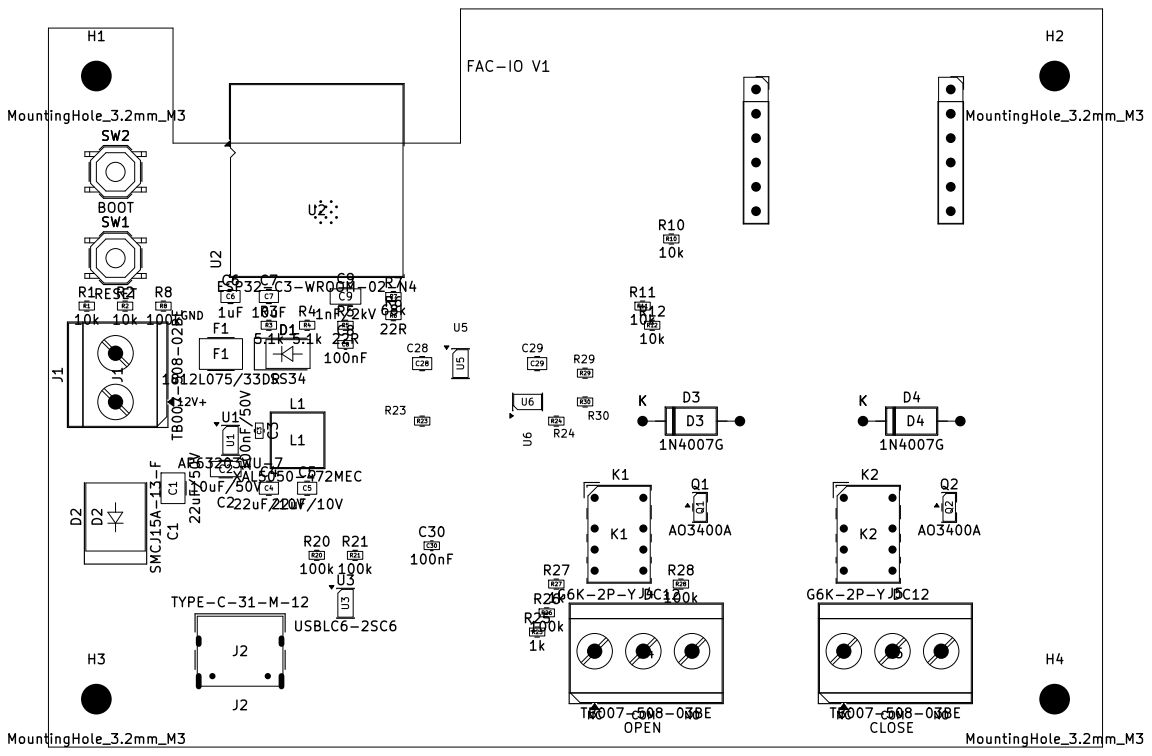
[picture p15: page 1]
