kemallaydn/FAC-IO-HARDWARE/manufacturing/DRAFT-2026-11-09-WIZ850io/assembly-front.pdf

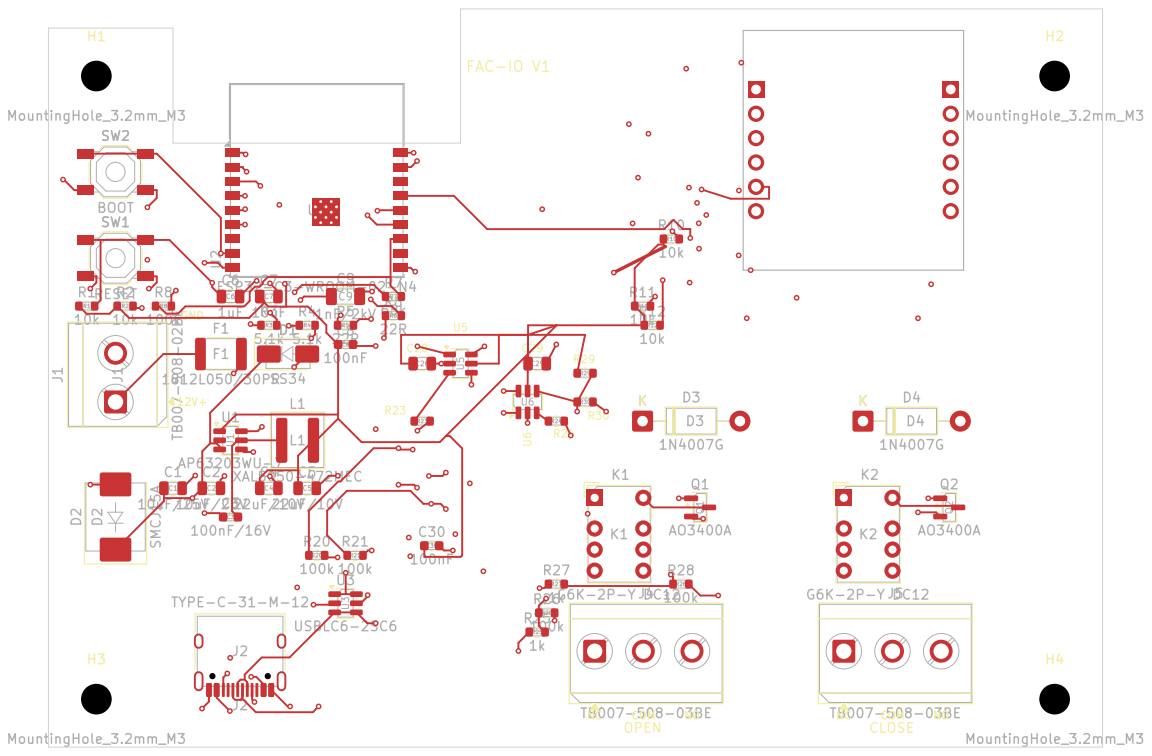
[picture p16: page 1]
