kemallaydn/FAC-IO-HARDWARE/(list of files, drawings)

Other design files:
manufacturing/DRAFT-2026-11-09-DRAFT-1.1/reports/pcb-drc-parity.json
manufacturing/DRAFT-2026-11-09-DRAFT-1.2/reports/pcb-drc-parity.json
validation-reports/candidates/lite-v3-mdialign30/FAC-IO-Lite-V3.dsn
validation-reports/candidates/lite-v3-mdialign30/routed.dsn
validation-reports/pcb-drc-parity.json
