kemallaydn/FAC-IO-HARDWARE/hardware/FAC-IO-Mini-V1.kicad_pcb

## KiCad design hardware/FAC-IO-Mini-V1.kicad_pcb (2026-11-12)

Schematic: FAC-IO-Mini-V1.kicad_sch, FAC-IO Mini V1 - Integrated Electrical Schematic

Parts:
C1: 22uF/50V; C_1210_3225Metric; MPN C3225X7R1H226M250AC
C2: 10uF/50V; C_1206_3216Metric; MPN CGA5L1X7R1H106K160AC
C3: 100nF/50V; C_0603_1608Metric; MPN CC0603JRX7R9BB104
C4, C5: 22uF/10V; C_0805_2012Metric; MPN GRM21BZ71A226ME15L
C6: 1uF; C_0805_2012Metric; MPN GRM21BR71C105KA01L
C7: 10uF; C_0805_2012Metric; MPN GRM21BZ71E106KE15L
C8, C30: 100nF; C_0603_1608Metric; MPN CC0603JRX7R9BB104
C9: 1nF/2kV; C_1206_3216Metric; MPN CC1206KKX7RDBB102
C28, C29: 100nF/100V; C_0805_2012Metric; MPN C0805C104K1RACAUTO
D1: SS34; D_SMA; MPN B340A-13-F
D2: SMCJ15A-13-F; D_SMC; MPN SMCJ15A-13-F
D3, D4: 1N4007G; D_DO-41_SOD81_P10.16mm_Horizontal; MPN 1N4007G-T
F1: 1812L075/33DR; Fuse_1812_4532Metric; MPN 1812L075/33DR
J1: TB007-508-02BE; TerminalBlock_CUI_TB007-508-02_1x02_P5.08mm_Horizontal; MPN TB007-508-02BE
J2: TYPE-C-31-M-12; USB_C_Receptacle_HRO_TYPE-C-31-M-12; MPN TYPE-C-31-M-12
J4, J5: TB007-508-03BE; TerminalBlock_CUI_TB007-508-03_1x03_P5.08mm_Horizontal; MPN TB007-508-03BE
J6: SSQ-106-03-G-S; WIZ850io_Host_J1_Socket_1x06; MPN SSQ-106-03-G-S
J7: SSQ-106-03-G-S; WIZ850io_Host_J2_Socket_1x06; MPN SSQ-106-03-G-S
K1, K2: G6K-2P-Y DC12; Relay_DPDT_Omron_G6K-2P-Y; MPN G6K-2P-Y DC12
L1: XAL5050-472MEC; L_Coilcraft_XAL5050-XXX; MPN XAL5050-472MEC
PWR1, PWR2, PWR3, PWR5: PWR_FLAG
Q1, Q2: AO3400A; SOT-23; MPN AO3400A
R1, R2, R10, R11, R12: 10k; R_0603_1608Metric; MPN RC0603FR-0710KL
R3, R4: 5.1k; R_0603_1608Metric; MPN RC0603FR-075K1L
R5, R6: 22R; R_0603_1608Metric; MPN RC0603FR-0722RL
R7: 68k; R_0603_1608Metric; MPN RC0603FR-0768KL
R8, R20, R21, R26, R28: 100k; R_0603_1608Metric; MPN RC0603FR-07100KL
R23, R24: 768k; R_0603_1608Metric; MPN RC0603FR-07768KL
R25, R27: 1k; R_0603_1608Metric; MPN RC0603FR-071KL
R29: 1M; R_0603_1608Metric; MPN RC0603FR-071ML
R30: 523k; R_0603_1608Metric; MPN RC0603FR-07523KL
SW1: RESET; SW_SPST_TL3342; MPN TL3342F100QG
SW2: BOOT; SW_SPST_TL3342; MPN TL3342F100QG
U1: AP63203WU-7; TSOT-23-6; MPN AP63203WU-7
U2: ESP32-C3-WROOM-02-N4; ESP32-C3-WROOM-02_0p3mmThermal; MPN ESP32-C3-WROOM-02-N4
U3: USBLC6-2SC6; SOT-23-6; MPN USBLC6-2SC6
U5, U6: LTC6993IS6-1; TSOT-23-6; MPN LTC6993IS6-1#TRMPBF

Connections:
/3V3: C4.1, C5.1, C7.1, C8.1, C28.1, C29.1, C30.1, J7.2, J7.3, L1.2, PWR3.1, R1.1, R2.1, R10.1, R11.1, R12.1, R29.1, U1.1 (FB), U2.1 (3V3), U5.5 (V+), U6.5 (V+)
/12V_FUSED: D1.2 (A), F1.2
/12V_IN: F1.1, J1.1, PWR1.1
/12V_PROT: C1.1, C2.1, D1.1 (K), D2.1 (K), D3.1 (K), D4.1 (K), K1.A1, K2.A1, PWR2.1, U1.2 (EN), U1.3 (IN)
/BOOT_N: R2.2, SW2.1, U2.8 (IO9)
/BUCK_BST: C3.1, U1.6 (BST)
/BUCK_SW: C3.2, L1.1, U1.5 (SW)
/CHASSIS: C9.1, J2.SH (SHIELD)
/CLOSE_COM: J5.2, K2.11
/CLOSE_NC: J5.1, K2.12
/CLOSE_NO: J5.3, K2.14
/COIL1_LOW: D3.2 (A), K1.A2, Q1.3 (D)
/COIL2_LOW: D4.2 (A), K2.A2, Q2.3 (D)
/ESP_EN: C6.1, R1.2, SW1.1, U2.2 (EN)
/ETH_CS_N: J6.5, R10.2, U2.6 (IO7)
/ETH_INT_N: J6.6, R11.2, U2.10 (IO10)
/ETH_MISO: J7.6, U2.5 (IO6)
/ETH_MOSI: J6.3, U2.4 (IO5)
/ETH_RESET_N: J7.5, R12.2, U2.15 (IO3)
/ETH_SCK: J6.4, U2.3 (IO4)
/GATE1: Q1.1 (G), R25.2, R26.1
/GATE2: Q2.1 (G), R27.2, R28.1
/GND: C1.2, C2.2, C4.2, C5.2, C6.2, C7.2, C8.2, C9.2, C28.2, C29.2, C30.2, D2.2 (A), J1.2, J2.A1 (GND), J2.A12 (GND), J2.B1 (GND), J2.B12 (GND), J6.1, J6.2, J7.1, PWR5.1, Q1.2 (S), Q2.2 (S), R3.2, R4.2, R8.2, R20.2, R21.2, R23.2, R24.2, R26.2, R28.2, R30.2, SW1.2, SW2.2, U1.4 (GND), U2.9 (GND), U2.19 (GND), U3.2 (GND), U5.2 (GND), U6.2 (GND)
/OPEN_COM: J4.2, K1.11
/OPEN_NC: J4.1, K1.12
/OPEN_NO: J4.3, K1.14
/PULSE1: R25.1, U5.6 (OUT)
/PULSE2: R27.1, U6.6 (OUT)
/SET1: R23.1, U5.3 (SET)
/SET2: R24.1, U6.3 (SET)
/TIMER_DIV: R29.2, R30.1, U5.4 (DIV), U6.4 (DIV)
/TRIG1: R20.1, U2.18 (IO0), U5.1 (TRIG)
/TRIG2: R21.1, U2.17 (IO1), U6.1 (TRIG)
/USB_CC1: J2.A5 (CC1), R3.1
/USB_CC2: J2.B5 (CC2), R4.1
/USB_DM: R6.2, U2.13 (IO18)
/USB_DM_CONN: J2.A7 (D-), J2.B7 (D-), R6.1, U3.3 (I/O2), U3.4 (I/O2)
/USB_DP: R5.2, U2.14 (IO19)
/USB_DP_CONN: J2.A6 (D+), J2.B6 (D+), R5.1, U3.1 (I/O1), U3.6 (I/O1)
/USB_VBUS: J2.A4 (VBUS), J2.A9 (VBUS), J2.B4 (VBUS), J2.B9 (VBUS), R7.1, U3.5 (VBUS)
/USB_VBUS_SENSE: R7.2, R8.1, U2.12 (IO21/TXD)

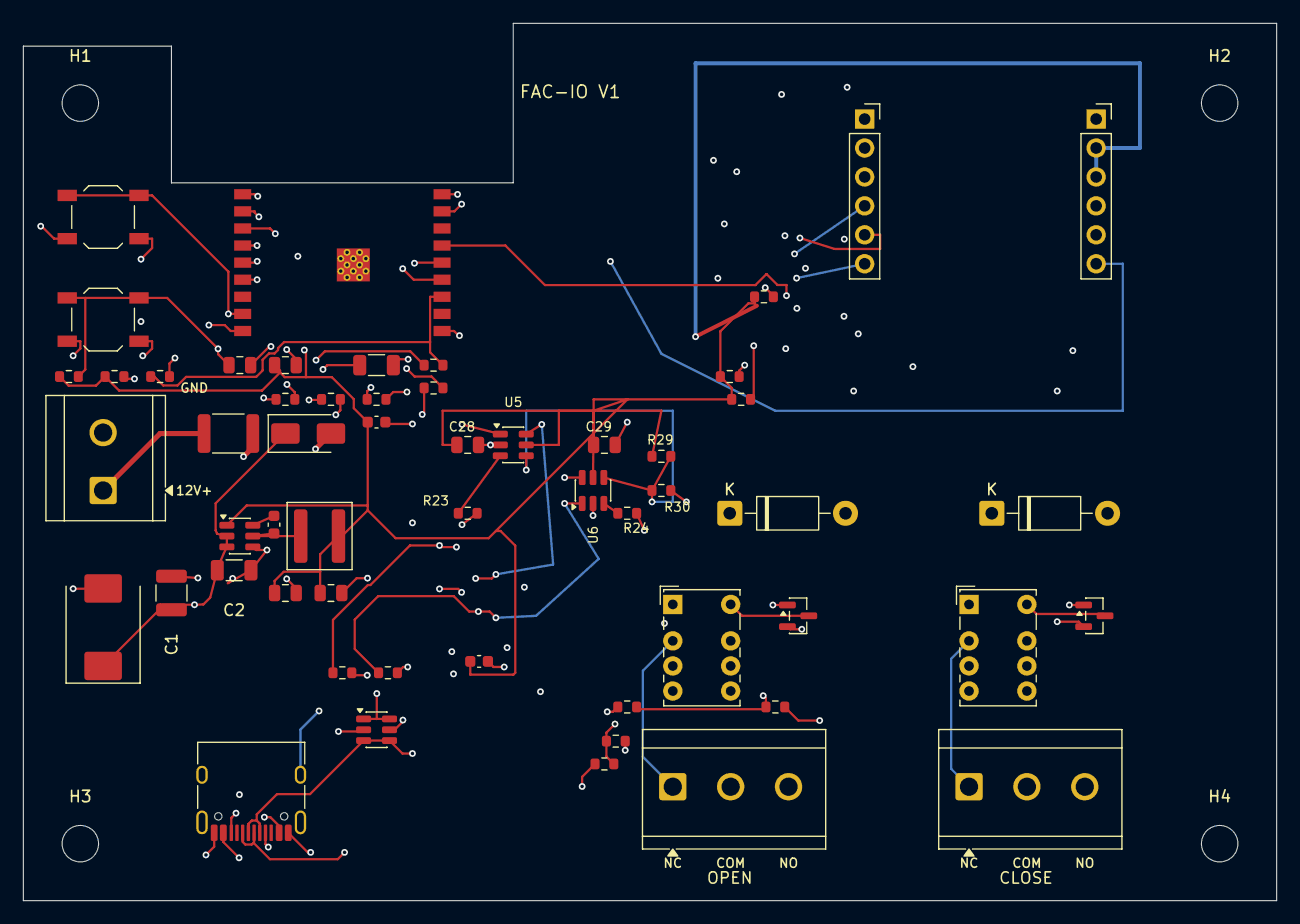
[picture p17: board FAC-IO-Mini-V1.kicad_pcb from above]

Board: 4 copper layers, 110.0 x 77.0 mm, 60 parts (0 on the bottom side), 41 nets.

Other parts of the board:
H1, H2, H3, H4: MountingHole_3.2mm_M3
