kemallaydn/FAC-IO-HARDWARE/validation-reports/candidates/lite-v3-mdialign31/FAC-IO-Lite-V3.kicad_pcb

## KiCad design validation-reports/candidates/lite-v3-mdialign31/FAC-IO-Lite-V3.kicad_pcb (2026-11-12)

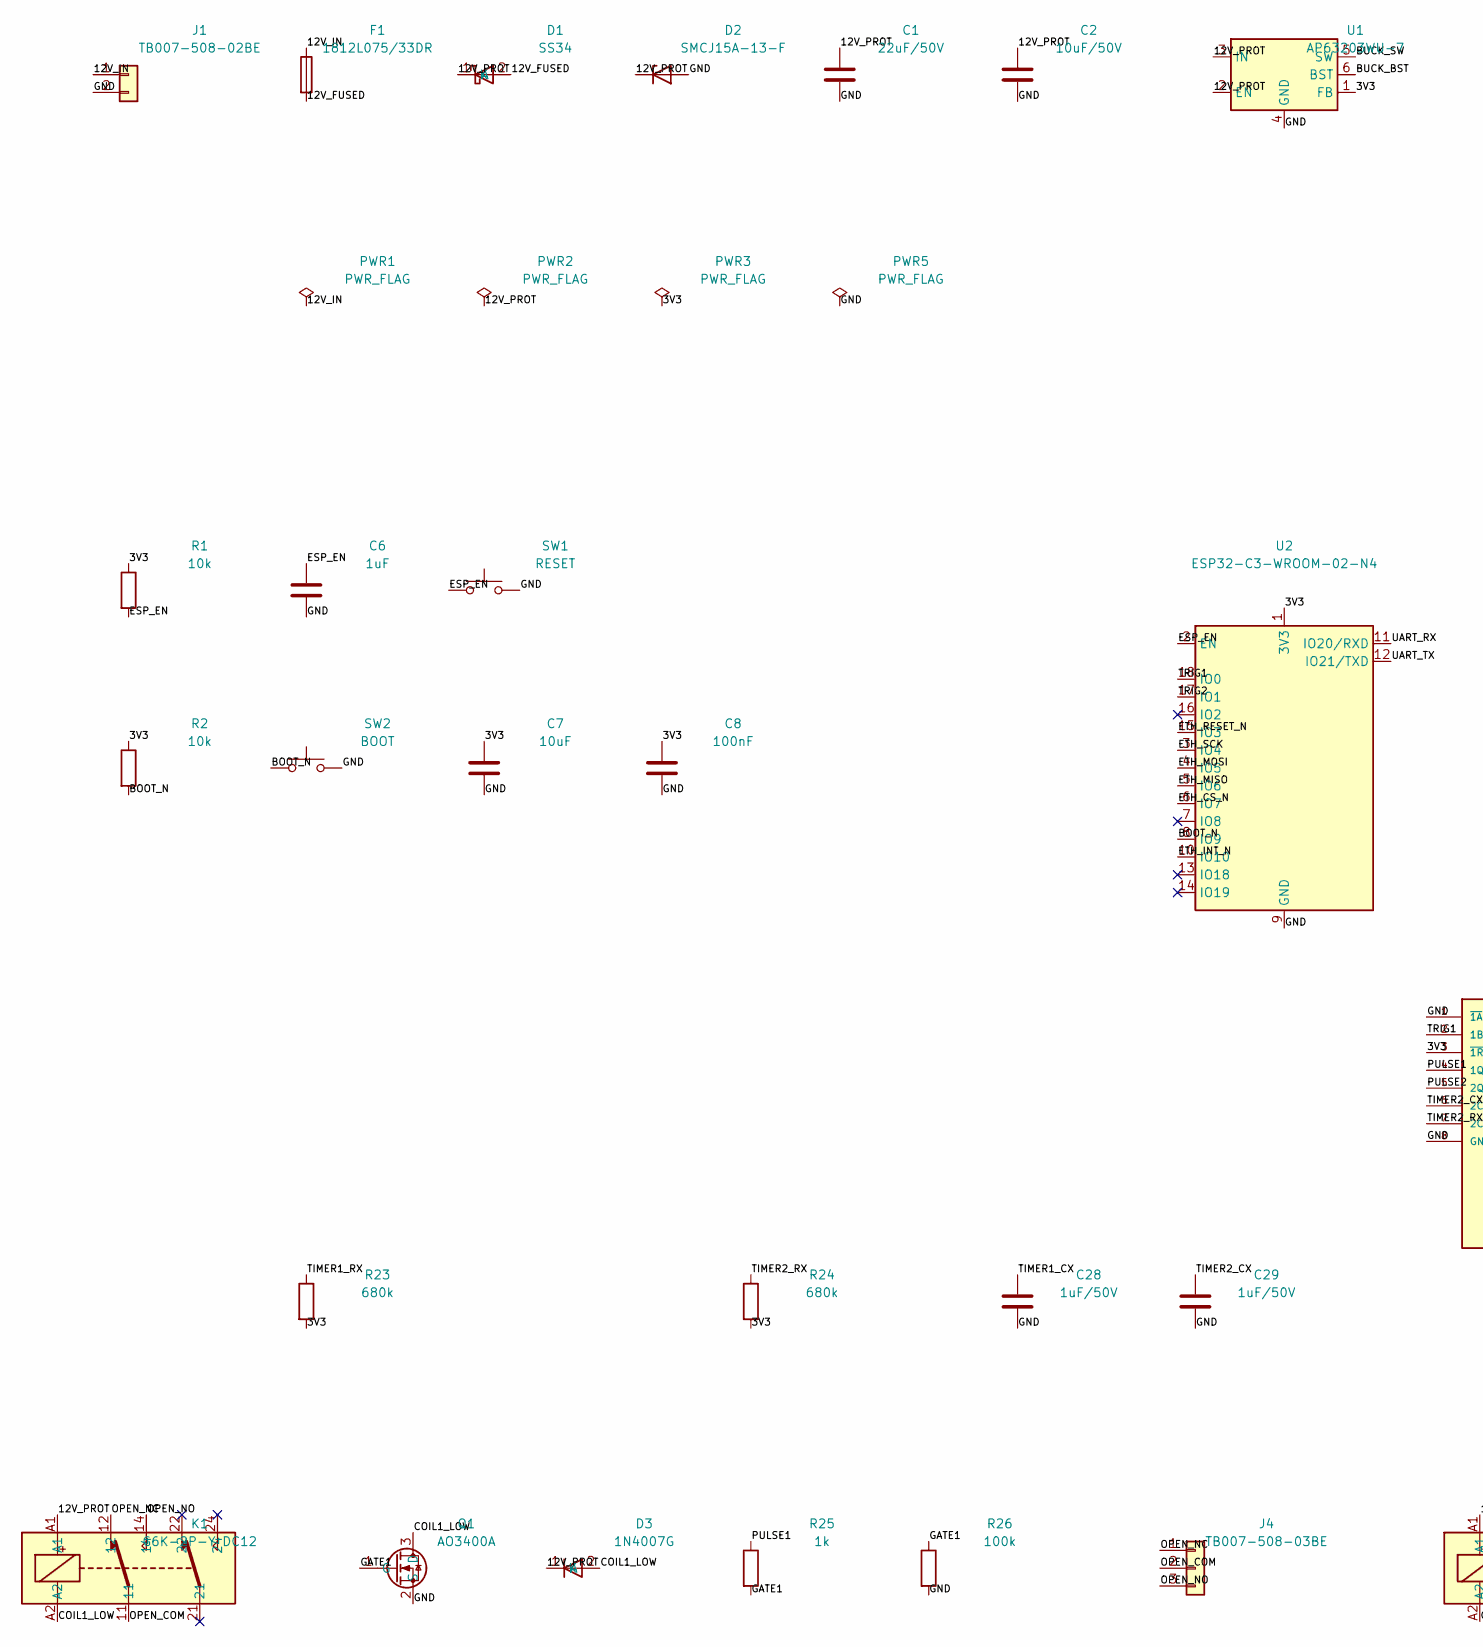
[picture p18: schematic FAC-IO-Lite-V3.kicad_sch, FAC-IO Lite V3 - Electrical Draft, part in row 1, column 1]

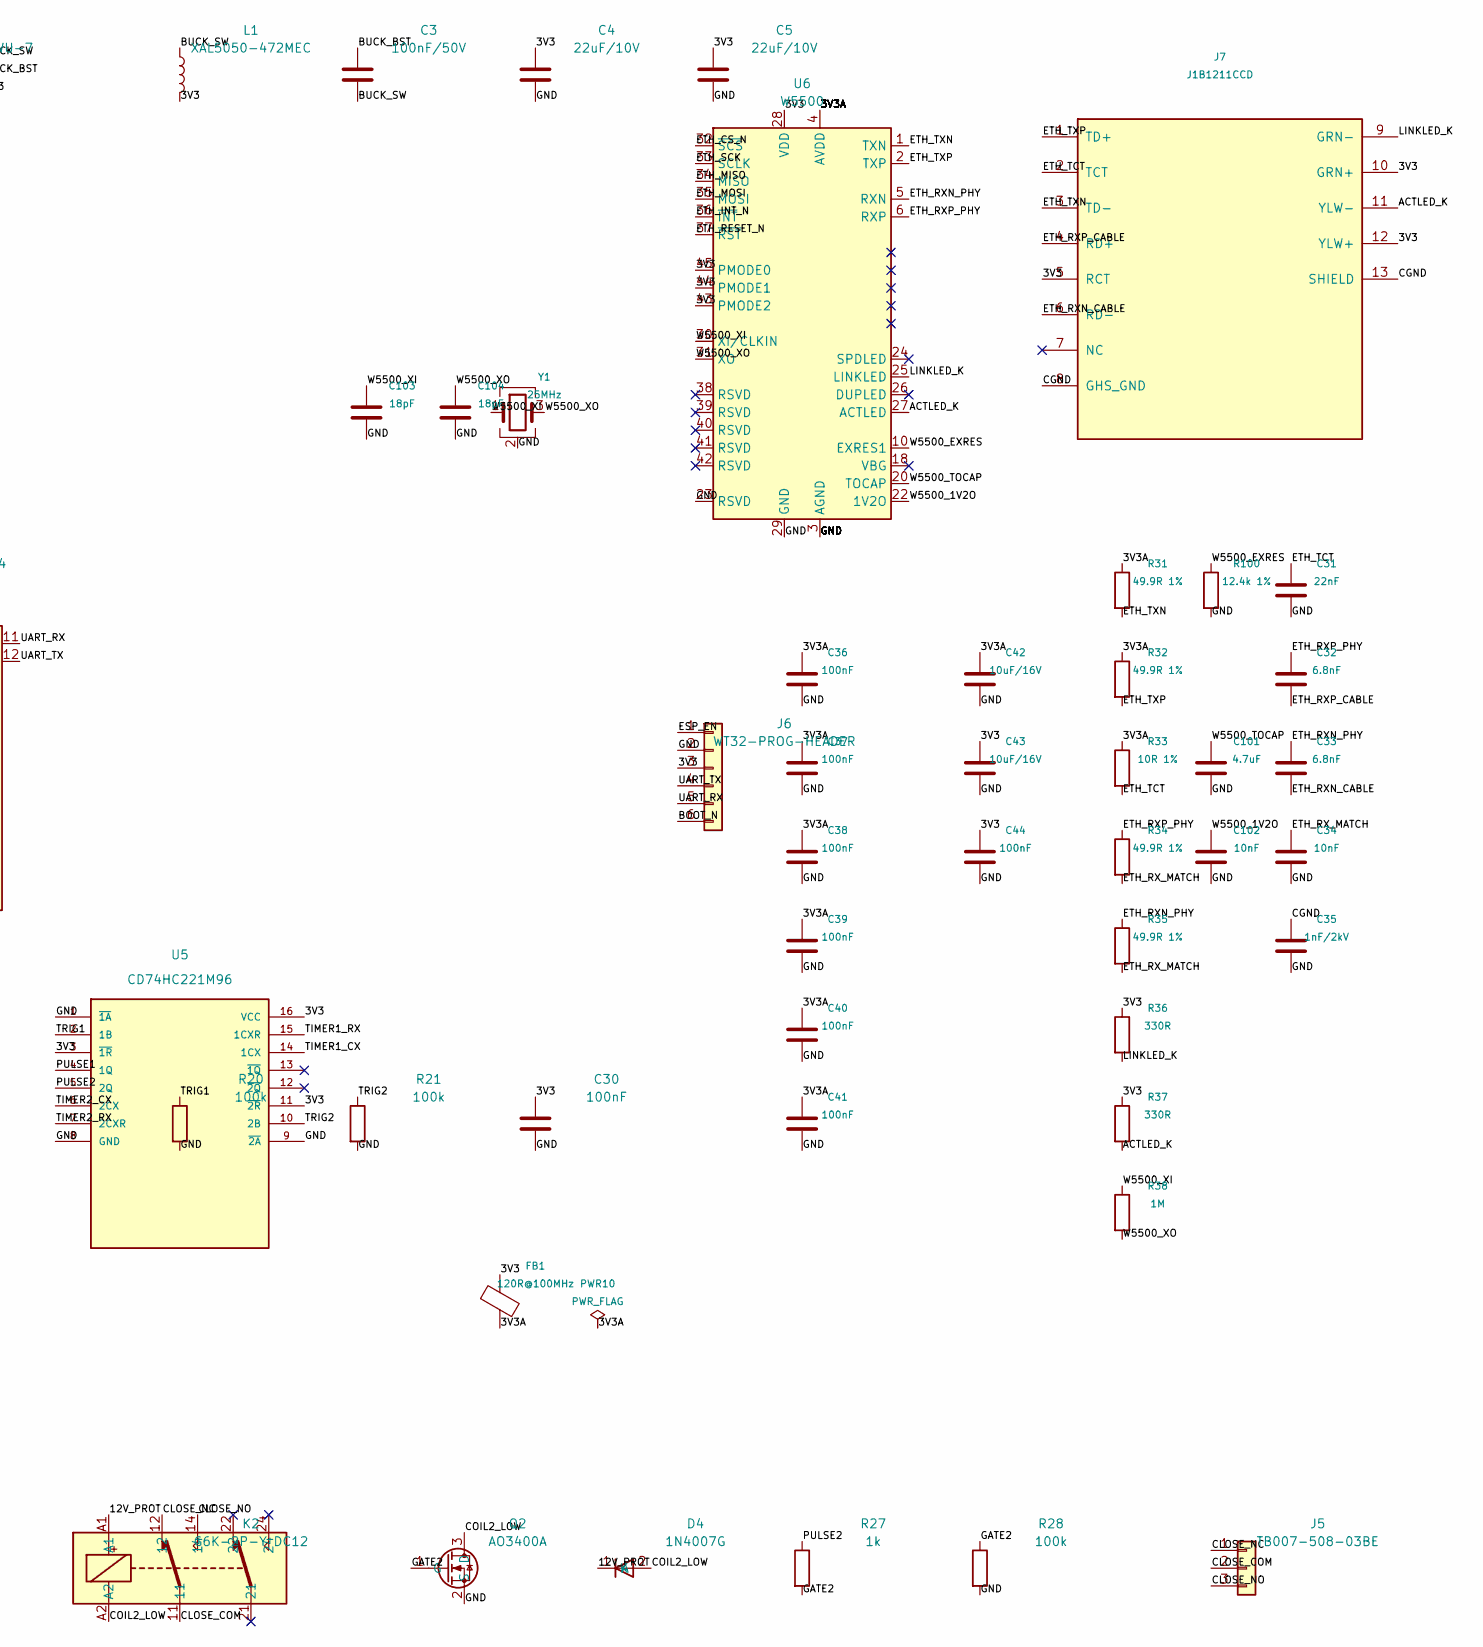
[picture p19: schematic FAC-IO-Lite-V3.kicad_sch, FAC-IO Lite V3 - Electrical Draft, part in row 1, column 2]

Parts:
C1: 22uF/50V; C_1210_3225Metric; MPN C3225X7R1H226M250AC
C2: 10uF/50V; C_1206_3216Metric; MPN CGA5L1X7R1H106K160AC
C3: 100nF/50V; C_0603_1608Metric; MPN CC0603JRX7R9BB104
C4, C5: 22uF/10V; C_0805_2012Metric; MPN GRM21BZ71A226ME15L
C6: 1uF; C_0805_2012Metric; MPN GRM21BR71C105KA01L
C7: 10uF; C_0805_2012Metric; MPN GRM21BZ71E106KE15L
C8, C30: 100nF; C_0603_1608Metric; MPN CC0603JRX7R9BB104
C28, C29: 1uF/50V; C_0805_2012Metric; MPN C0805C105K5RACTU
C31: 22nF; C_0603_1608Metric
C32, C33: 6.8nF; C_0603_1608Metric
C34, C102: 10nF; C_0603_1608Metric
C35: 1nF/2kV; C_1206_3216Metric
C36, C37, C38, C39, C40, C41, C44: 100nF; C_0603_1608Metric
C42, C43: 10uF/16V; C_0805_2012Metric
C101: 4.7uF; C_0805_2012Metric
C103, C104: 18pF; C_0603_1608Metric
D1: SS34; D_SMA; MPN B340A-13-F
D2: SMCJ15A-13-F; D_SMC; MPN SMCJ15A-13-F
D3, D4: 1N4007G; D_DO-41_SOD81_P10.16mm_Horizontal; MPN 1N4007G-T
F1: 1812L075/33DR; Fuse_1812_4532Metric; MPN 1812L075/33DR
FB1: 120R@100MHz; L_0603_1608Metric; MPN HHM1M1608-121JT
J1: TB007-508-02BE; TerminalBlock_CUI_TB007-508-02_1x02_P5.08mm_Horizontal; MPN TB007-508-02BE
J4, J5: TB007-508-03BE; TerminalBlock_CUI_TB007-508-03_1x03_P5.08mm_Horizontal; MPN TB007-508-03BE
J6: WT32-PROG-HEADER; PinHeader_1x06_P2.54mm_Vertical; MPN TBD_STANDARD_1X06_HEADER
J7: J1B1211CCD; RJ45_Cetus_J1B1211CCD_Horizontal; MPN J1B1211CCD
K1, K2: G6K-2P-Y DC12; Relay_DPDT_Omron_G6K-2P-Y; MPN G6K-2P-Y DC12
L1: XAL5050-472MEC; L_Coilcraft_XAL5050-XXX; MPN XAL5050-472MEC
PWR1, PWR2, PWR3, PWR5, PWR10: PWR_FLAG
Q1, Q2: AO3400A; SOT-23; MPN AO3400A
R1, R2: 10k; R_0603_1608Metric; MPN RC0603FR-0710KL
R20, R21, R26, R28: 100k; R_0603_1608Metric; MPN RC0603FR-07100KL
R23, R24: 680k; R_0603_1608Metric; MPN RC0603FR-07680KL
R25, R27: 1k; R_0603_1608Metric; MPN RC0603FR-071KL
R31, R32, R34, R35: 49.9R 1%; R_0603_1608Metric
R33: 10R 1%; R_0603_1608Metric
R36, R37: 330R; R_0603_1608Metric
R38: 1M; R_0603_1608Metric; MPN RC0603FR-071ML
R100: 12.4k 1%; R_0603_1608Metric; MPN RC0603FR-0712K4L
SW1: RESET; SW_SPST_TL3342; MPN TL3342F100QG
SW2: BOOT; SW_SPST_TL3342; MPN TL3342F100QG
U1: AP63203WU-7; TSOT-23-6; MPN AP63203WU-7
U2: ESP32-C3-WROOM-02-N4; ESP32-C3-WROOM-02_0p3mmThermal; MPN ESP32-C3-WROOM-02-N4
U5: CD74HC221M96; SOIC-16_3.9x9.9mm_P1.27mm; MPN CD74HC221M96; LCSC C133954
U6: W5500; LQFP-48_7x7mm_P0.5mm; MPN W5500
Y1: 25MHz; Crystal_SMD_3225-4Pin_3.2x2.5mm; MPN TBD_25MHZ_CRYSTAL

Connections:
/3V3: C4.1, C5.1, C7.1, C8.1, C30.1, C43.1, C44.1, FB1.1, J6.3, J7.5 (RCT), J7.10 (GRN+), J7.12 (YLW+), L1.2, PWR3.1, R1.1, R2.1, R23.2, R24.2, R36.1, R37.1, U1.1 (FB), U2.1 (3V3), U5.3 (~1R), U5.11 (~2R), U5.16 (VCC), U6.28 (VDD), U6.43 (PMODE2), U6.44 (PMODE1), U6.45 (PMODE0)
/3V3A: C36.1, C37.1, C38.1, C39.1, C40.1, C41.1, C42.1, FB1.2, PWR10.1, R31.1, R32.1, R33.1, U6.4 (AVDD), U6.8 (AVDD), U6.11 (AVDD), U6.15 (AVDD), U6.17 (AVDD), U6.21 (AVDD)
/12V_FUSED: D1.2 (A), F1.2
/12V_IN: F1.1, J1.1, PWR1.1
/12V_PROT: C1.1, C2.1, D1.1 (K), D2.1 (K), D3.1 (K), D4.1 (K), K1.A1, K2.A1, PWR2.1, U1.2 (EN), U1.3 (IN)
/ACTLED_K: J7.11 (YLW-), R37.2, U6.27 (ACTLED)
/BOOT_N: J6.6, R2.2, SW2.1, U2.8 (IO9)
/BUCK_BST: C3.1, U1.6 (BST)
/BUCK_SW: C3.2, L1.1, U1.5 (SW)
/CGND: C35.1, J7.8 (GHS_GND), J7.13 (SHIELD)
/CLOSE_COM: J5.2, K2.11
/CLOSE_NC: J5.1, K2.12
/CLOSE_NO: J5.3, K2.14
/COIL1_LOW: D3.2 (A), K1.A2, Q1.3 (D)
/COIL2_LOW: D4.2 (A), K2.A2, Q2.3 (D)
/ESP_EN: C6.1, J6.1, R1.2, SW1.1, U2.2 (EN)
/ETH_CS_N: U2.6 (IO7), U6.32 (~SCS)
/ETH_INT_N: U2.10 (IO10), U6.36 (~INT)
/ETH_MISO: U2.5 (IO6), U6.34 (MISO)
/ETH_MOSI: U2.4 (IO5), U6.35 (MOSI)
/ETH_RESET_N: U2.15 (IO3), U6.37 (~RST)
/ETH_RXN_CABLE: C33.2, J7.6 (RD-)
/ETH_RXN_PHY: C33.1, R35.1, U6.5 (RXN)
/ETH_RXP_CABLE: C32.2, J7.4 (RD+)
/ETH_RXP_PHY: C32.1, R34.1, U6.6 (RXP)
/ETH_RX_MATCH: C34.1, R34.2, R35.2
/ETH_SCK: U2.3 (IO4), U6.33 (SCLK)
/ETH_TCT: C31.1, J7.2 (TCT), R33.2
/ETH_TXN: J7.3 (TD-), R31.2, U6.1 (TXN)
/ETH_TXP: J7.1 (TD+), R32.2, U6.2 (TXP)
/GATE1: Q1.1 (G), R25.2, R26.1
/GATE2: Q2.1 (G), R27.2, R28.1
/GND: C1.2, C2.2, C4.2, C5.2, C6.2, C7.2, C8.2, C28.2, C29.2, C30.2, C31.2, C34.2, C35.2, C36.2, C37.2, C38.2, C39.2, C40.2, C41.2, C42.2, C43.2, C44.2, C101.2, C102.2, C103.2, C104.2, D2.2 (A), J1.2, J6.2, PWR5.1, Q1.2 (S), Q2.2 (S), R20.2, R21.2, R26.2, R28.2, R100.2, SW1.2, SW2.2, U1.4 (GND), U2.9 (GND), U2.19 (GND), U5.1 (~1A), U5.8 (GND), U5.9 (~2A), U6.3 (AGND), U6.9 (AGND), U6.14 (AGND), U6.16 (AGND), U6.19 (AGND), U6.23 (RSVD), U6.29 (GND), U6.48 (AGND), Y1.2 (G), Y1.4 (G)
/LINKLED_K: J7.9 (GRN-), R36.2, U6.25 (LINKLED)
/OPEN_COM: J4.2, K1.11
/OPEN_NC: J4.1, K1.12
/OPEN_NO: J4.3, K1.14
/PULSE1: R25.1, U5.4 (1Q)
/PULSE2: R27.1, U5.5 (2Q)
/TIMER1_CX: C28.1, U5.14 (1CX)
/TIMER1_RX: R23.1, U5.15 (1CXR)
/TIMER2_CX: C29.1, U5.6 (2CX)
/TIMER2_RX: R24.1, U5.7 (2CXR)
/TRIG1: R20.1, U2.18 (IO0), U5.2 (1B)
/TRIG2: R21.1, U2.17 (IO1), U5.10 (2B)
/UART_RX: J6.5, U2.11 (IO20/RXD)
/UART_TX: J6.4, U2.12 (IO21/TXD)
/W5500_1V2O: C102.1, U6.22 (1V2O)
/W5500_EXRES: R100.1, U6.10 (EXRES1)
/W5500_TOCAP: C101.1, U6.20 (TOCAP)
/W5500_XI: C103.1, R38.1, U6.30 (XI/CLKIN), Y1.1
/W5500_XO: C104.1, R38.2, U6.31 (XO), Y1.3

Board: 2 copper layers, 71 parts (0 on the bottom side), 52 nets, no tracks yet.
