kemallaydn/FAC-IO-HARDWARE/(commit log)

2026-11-07 hardware: add hardware/bom-draft.csv initial design baseline
    [bom-draft.csv]
2026-11-07 engineering: add verified references and prototype acceptance matrix
2026-11-07 hardware: specify preliminary electrical nets and review critical pin risks
    [netlist-design-v0.csv]
2026-11-07 firmware: add safe ESP32-C3 diagnostic PlatformIO skeleton
2026-11-07 firmware: add bounded relay pulse state machine and rollover tests
2026-11-07 firmware: add tested dual-relay logic controller
2026-11-07 hardware: add initial KiCad functional block schematic (not manufacturing ready)
    [FAC-IO-Mini-V1.kicad_sch]
2026-11-07 firmware: add host-tested fail-closed relay controller v2
2026-11-07 manufacturing: block incomplete PCBA release and test release gate
2026-11-07 hardware: draft KiCad dual MOSFET relay-coil driver schematic
    [relay-driver-v0.kicad_sch]
2026-11-07 ci: add actual KiCad CLI schematic parse and SVG export check
2026-11-07 hardware: select concrete relay driver candidates and calculate coil/gate design
2026-11-07 hardware: add dual isolated SPDT contact and terminal schematic draft
    [relay-contacts-v0.kicad_sch]
2026-11-07 ci: export KiCad netlists and ERC reports, archive artifacts and forbid premature production approval
2026-11-07 hardware: create initial KiCad PCB mechanical outline with four M3 mounting holes
    [FAC-IO-Mini-V1.kicad_pcb]
2026-11-07 ci: run KiCad PCB DRC on board changes and archive reports
2026-11-07 hardware: place four real 0603 relay gate resistors with named copper pads on PCB draft
    [FAC-IO-Mini-V1.kicad_pcb]
2026-11-07 hardware: add two AO3400A candidate SOT-23 footprints to PCB draft
    [FAC-IO-Mini-V1.kicad_pcb]
2026-11-07 hardware: place two through-hole flyback diode footprints in PCB draft
    [FAC-IO-Mini-V1.kicad_pcb]
2026-11-07 hardware: route first two MOSFET gate nets between series resistors, pulldowns and gate pads
    [FAC-IO-Mini-V1.kicad_pcb]
2026-11-07 hardware: extend initial source and gate routing stubs for relay MOSFETs
    [FAC-IO-Mini-V1.kicad_pcb]
2026-11-07 hardware: replace exploratory MOSFET gate traces with pad-aligned routing only
    [FAC-IO-Mini-V1.kicad_pcb]
2026-11-07 hardware: add two provisional 3-pin dry-contact terminal footprints and isolated nets
    [FAC-IO-Mini-V1.kicad_pcb]
2026-11-07 fix: reverse flyback diode net assignments to cathode +12V, anode coil low
    [FAC-IO-Mini-V1.kicad_pcb]
2026-11-07 ci: enforce KiCad PCB DRC failures and preserve reports
2026-11-07 ci: fail schematic validation on netlist export errors and print KiCad version
2026-11-07 ci: bound KiCad installation time and verify CLI executable
2026-11-07 docs: add PROJECT_STATUS.md for local KiCad AI handoff
2026-11-07 docs: add AGENTS.md for local KiCad AI handoff
2026-11-07 docs: add ROADMAP.md for local KiCad AI handoff
2026-11-08 Refactor code structure for improved readability and maintainability
    [FAC-IO-Mini-V1-B_Cu.gbl, FAC-IO-Mini-V1-B_Mask.gbs, FAC-IO-Mini-V1-B_Paste.gbp, FAC-IO-Mini-V1-B_Silkscreen.gbo, FAC-IO-Mini-V1-Edge_Cuts.gm1, FAC-IO-Mini-V1-F_Cu.gtl, FAC-IO-Mini-V1-F_Mask.gts, FAC-IO-Mini-V1-F_Paste.gtp]
2026-11-10 Add regression tests and validation reports for FAC-IO production package
    - Introduced `test_release_check.py` with comprehensive unit tests for release checks, including validation of BOM, CAD sources, and approval profiles.
    - Created validation reports for Excellon structure, firmware secure build tests, Gerber parsing, and DRC parity.
    - Added negative control report for DRC width violations to ensure compliance with design rules.
    [FAC-IO-Mini-V1-B_Cu.gbl, FAC-IO-Mini-V1-B_Cu.gbr, FAC-IO-Mini-V1-B_Mask.gbr, FAC-IO-Mini-V1-B_Mask.gbs, FAC-IO-Mini-V1-B_Paste.gbp, FAC-IO-Mini-V1-B_Paste.gbr, FAC-IO-Mini-V1-B_Silkscreen.gbo, FAC-IO-Mini-V1-B_Silkscreen.gbr]
2026-11-12 Add validation report for WIZnet PnP dual ground trial
    This commit introduces a new validation report for the WIZnet PnP-oriented J7/U6 placement. The report details the exploratory candidate's design considerations, including the use of 0402 MDI passives and FreeRouting imported traces. It highlights the DRC errors encountered, including clearance violations and unconnected zone-island items, indicating that the candidate has not passed necessary reviews and is not suitable for manufacturing.
    [FAC-IO-Lite-V2.kicad_sch, FAC-IO-Lite-V3.dsn, FAC-IO-Lite-V3.kicad_pcb, FAC-IO-Lite-V3.kicad_sch, FAC-IO-Mini-V1.csv, FAC-IO-Mini-V1.kicad_pcb, FAC-IO-Mini-V1.kicad_sch, FAC-IO-Mini-V1.xlsx]
